gqkhao/pcb-schematics/01.png

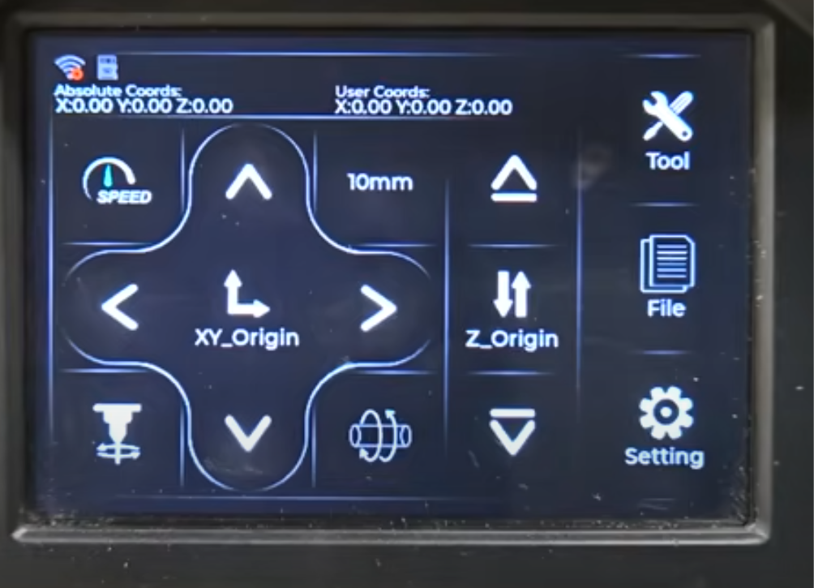
01.png
