gqkhao/pcb-schematics/CMB50N20测试正常MOS管.jpg

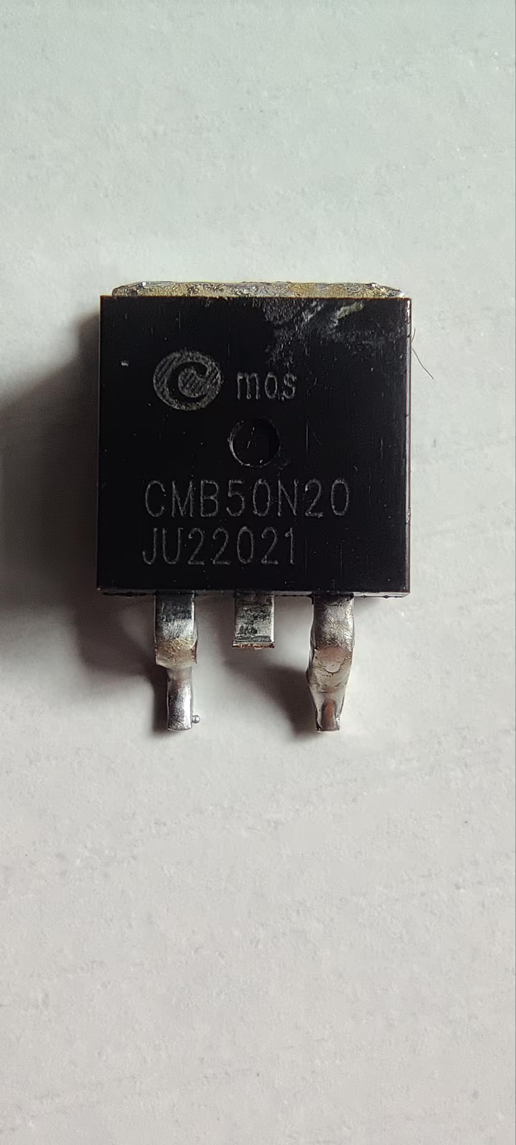
CMB50N20测试正常MOS管.jpg
