gqkhao/pcb-schematics/FluidNC/包裹款功能.docx

测试确定主板功能无误，主板功能如下

1.XYZ轴均为闭环步进电机；A轴：使用开环电机，用于升降探针；B和C轴：使用开环电机，旋转轴用；

2.控制板控制RGB状态灯（三色）；主轴照明灯不过控制板，总开关控制亮灭；光线不足通过灯带灯光补充，也是总开关控制亮灭；

3.限位端子三个对应XYZ轴，总共使用六个硬限位开关；

4.开盖保护功能启用了，则开盖后，主轴停，XYZ轴停，机器暂停；通过按键开关方式的一种控制开盖保护功能启用或者不启用（就是打开盖子后机器继续运动）

5.复位：机器上实体按键复位；

6.急停开关：拍下断电，出口欧洲需求专门认证的安全继电器模块（有现货）

7.对刀功能支持，电路板有接口；

8.购买的自动换刀模块有开合盖功能：开关信号触发实现，电路板有接口；

9.探针接口有，上位机控制自动调平、巡边；

10.控制板有接口,机器壳子要留DB9口；

11.USB接口有，WIFI功能有；

12.电源：一个交流转直流48V开关电源，一个DCDC直流小模块；

14.除尘，气泵控制，电路板有接口控制；

15.激光端口输出24V，需要使用24V激光器，电路板有接口；

16.控制板有SD卡接口，通过延长线接机器壳子上面的SD卡口，手轮屏幕不带SD卡口；

17.增加一路电平检测接口，用于检测刀具是否装夹到位
