gqkhao/pcb-schematics/4轴5.0/四轴5.0控制板升级说明.docx

四轴5.0控制板升级说明：

1、 激光和cnc切换引出一路IO口单独检测控制；
2、 12V电源输出端子修改为24V；
3、 对四个定位孔周围铺铜进行挖空；
4、 拨码开关SW2不焊接；
5、 功率MOS管板子上的Q2采用CMB50N20如下图

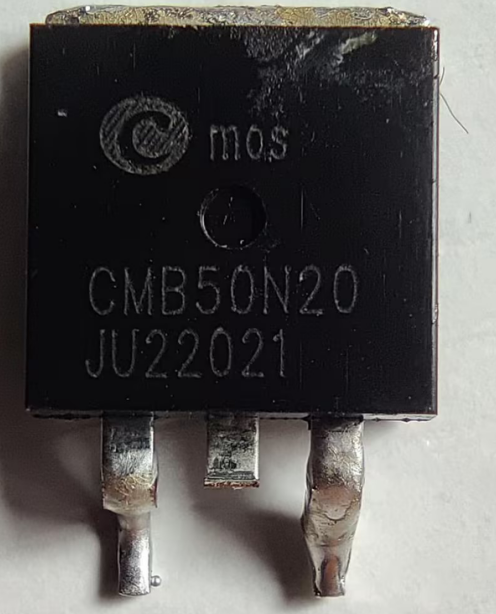
[picture p21: figure]
企业微信截图_17570547071518
