gqkhao/pcb-schematics/3020机器转接板/XZ转接板.pdf

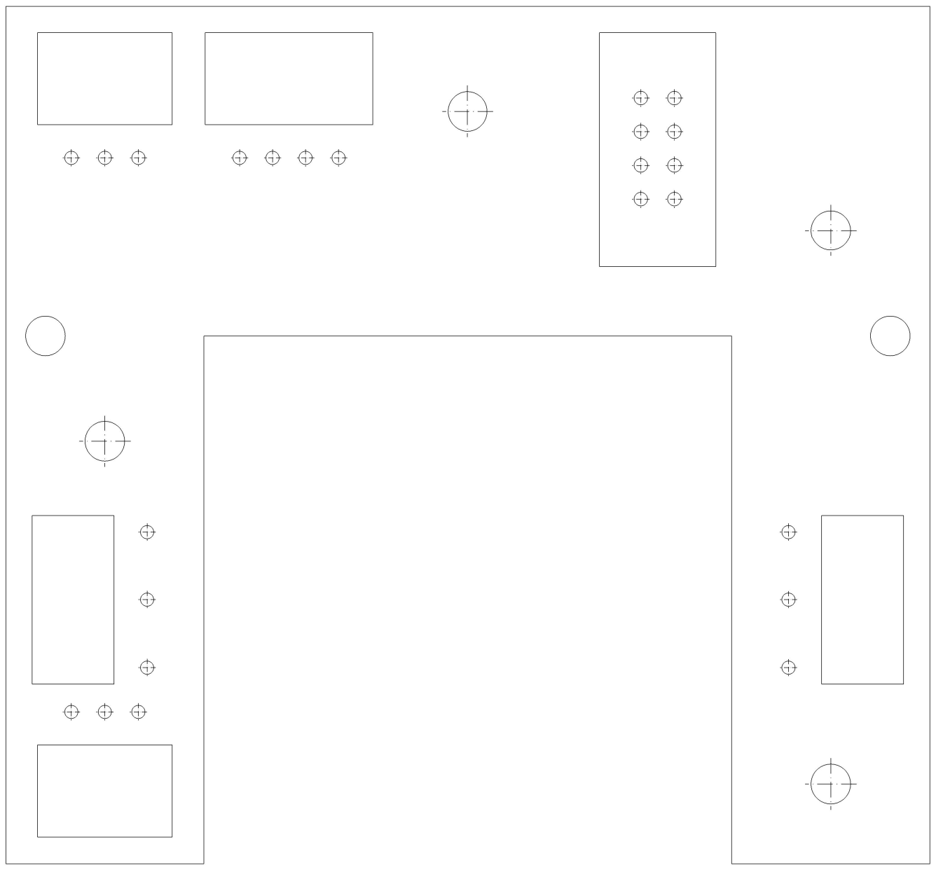
[picture p22: page 1]
