gqkhao/pcb-schematics/3020机器转接板/小限位开关板.png

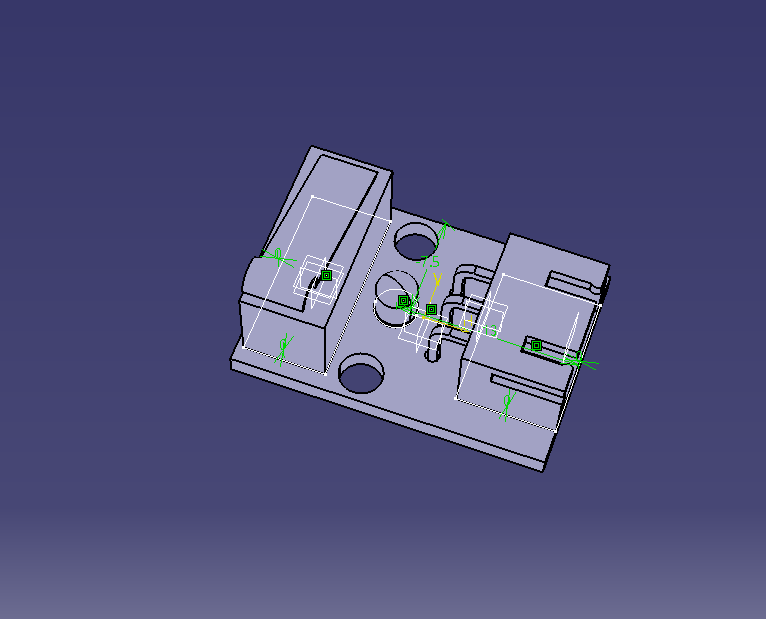
3020机器转接板/小限位开关板.png
