gqkhao/pcb-schematics/3020机器转接板/限位开关.png

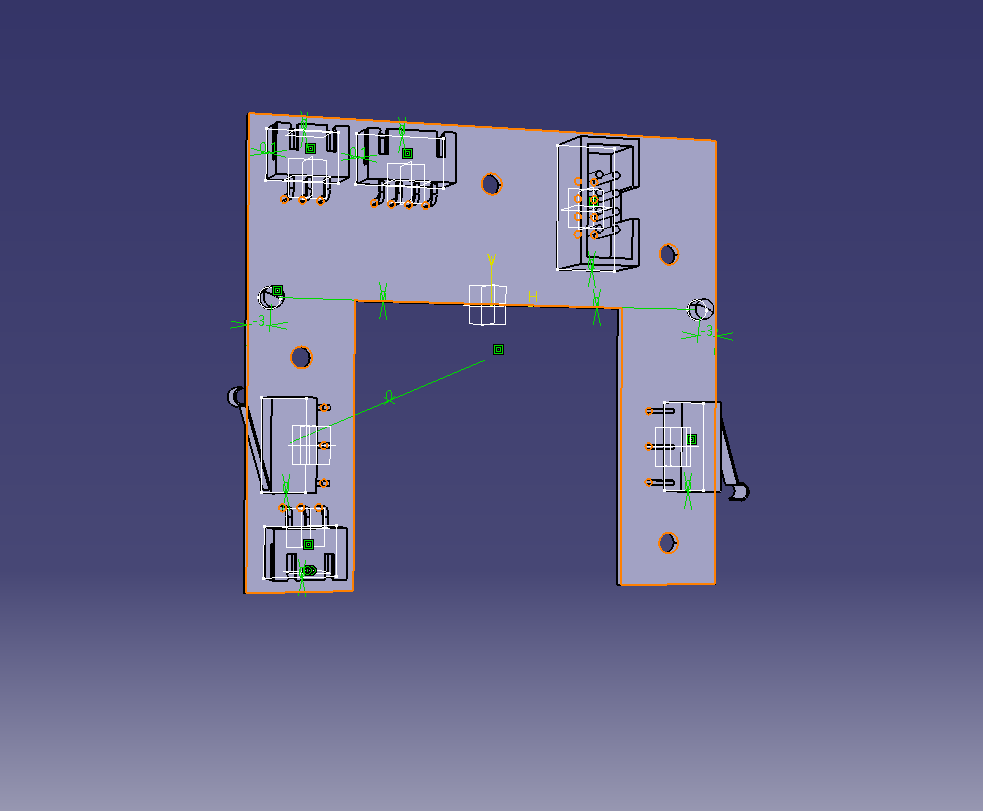
3020机器转接板/限位开关.png
