gqkhao/pcb-schematics/4040lite转接板/脉冲信号.png

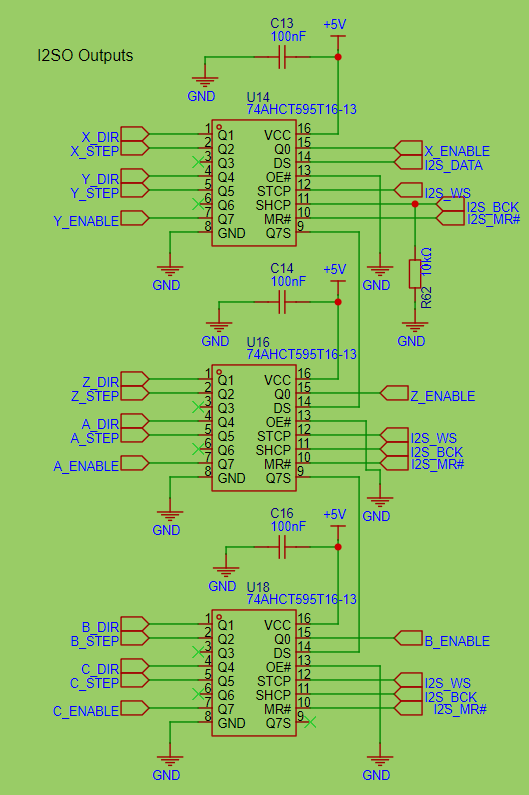
4040lite转接板/脉冲信号.png
