gqkhao/pcb-schematics/FluidNC/电源模块图片.png

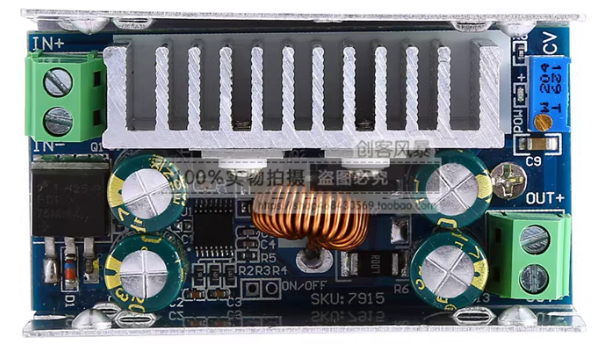
FluidNC/电源模块图片.png
