gqkhao/pcb-schematics/探针圆盘/对刀连接示意图/主板全部.png

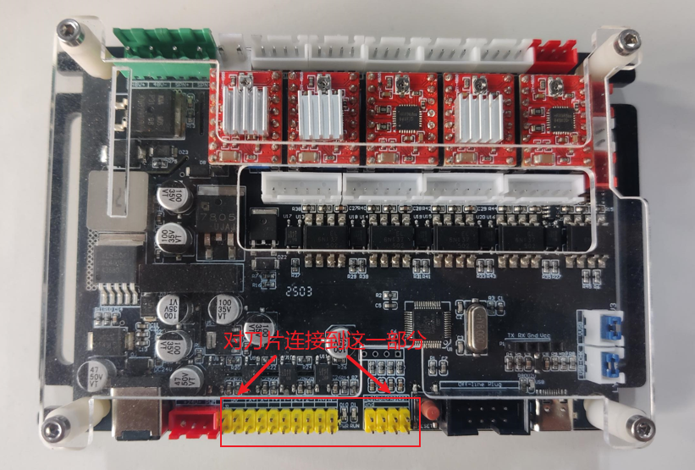
探针圆盘/对刀连接示意图/主板全部.png
