gqkhao/pcb-schematics/探针圆盘/对刀连接示意图/主板细节.png

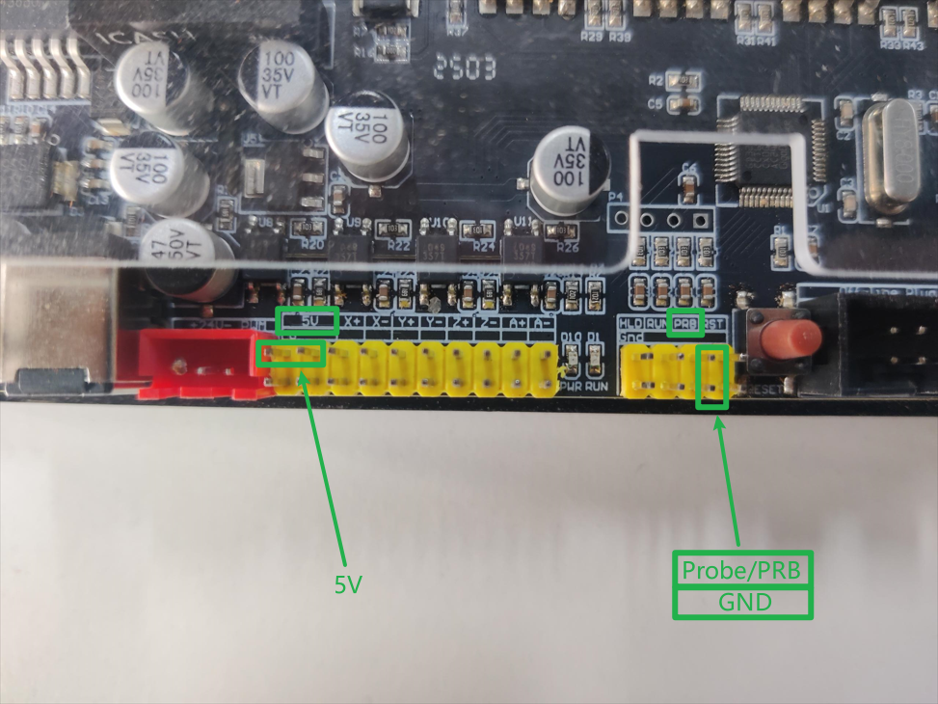
探针圆盘/对刀连接示意图/主板细节.png
