gqkhao/pcb-schematics/探针圆盘/对刀连接示意图/对刀片.jpg

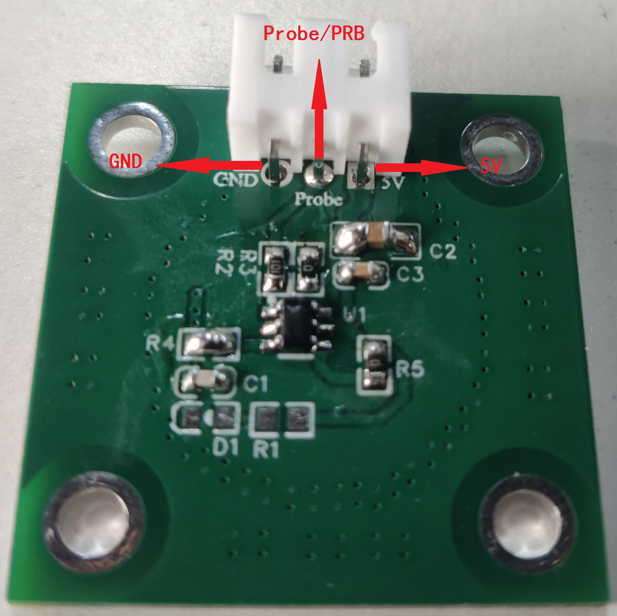
探针圆盘/对刀连接示意图/对刀片.jpg
