gqkhao/pcb-schematics/电机驱动TB6600/TB6600驱动板/tb6600板子资料/保证在110度条件下运行的 3.3V 5V驱动高速逻辑IC耦合器 TLP2309 - 电子发烧友网_files/15355635O-1.gif

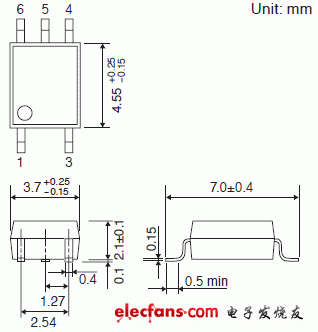
电机驱动TB6600/TB6600驱动板/tb6600板子资料/保证在110度条件下运行的 3.3V 5V驱动高速逻辑IC耦合器 TLP2309 - 电子发烧友网_files/15355635O-1.gif
