gqkhao/pcb-schematics/4040M/BOM_MCU+U盘__2026-06-23.xlsx

No. | 位号 | 数量 | 规格 | 封装 | 备注
1 | C1,C6,C10,C14,C34 | 5 | 100uF/10V | 电解电容贴片5.3X5.3
2 | C2,C3,C4,C7,C9,C12,C13,C17,C21,C22,C23,C24,C26,C28,C29,C33,C37,C40,C41,C42,C43,C44,C45,C46,C47,C48,C49,C25,C27,C39,C54,C55 | 32 | 0.1uF | C0603
3 | C5,C11,C15,C16,C50,C51,C52,C53 | 8 | 100uF/35V | 电解电容贴片6X6
4 | C30,C31,C32,C35,C36,C38 | 6 | 33pF | C0603
5 | CN1 | 1 | XHD2.54--3Pin | 弯针插件XHD2.54--3Pin
6 | D1,D9,D22 | 3 | SMAJ28A | SMA
7 | D2,D3,D6,D7,D8,D10,D11,D24 | 8 | SS56 | SMA
8 | D4,D12,D13,D16,D17,D20 | 6 | PESD5V0L1BA-N | SOD-323
9 | D5,D23 | 2 | SMAJ06A | SMA
10 | D14 | 1 | SMBJ15A | SMA
11 | D15 | 1 | 1N4148 | SOD-323
12 | D18,D19 | 2 | USBLC6-2SC6 | SOT-23-6
13 | L1,L2 | 2 | 贴片功率电感68uH | SMD_L7.0-W7.0
14 | LED1,LED2,LED3,LED5,D21 | 5 | 贴片LED绿光 | LED0603
15 | R1 | 1 | 47kΩ | R0603
16 | R4,R5,R8,R19,R22,R42,R43,R47,R48,R49,R57,R58,R61,R63 | 15 | 0Ω | R0603
17 | R10,R11,R23 | 3 | 22Ω | R0603
18 | R12,R16,R25,R32,R34 | 5 | 5.1K | R0603
19 | R13,R17,R26,R20,R27,R29,R36,R38,R33,R35,R40,R41,R45 | 13 | 220Ω | R0603
20 | R2,R3,R6,R7,R52,R53,R54,R56,R50,R76,R77,R78,R79,R21,R28,R30,R31,R37,R39,R24,R44,R46,R55,R59,R60,R62,R64,R65,R66,R67,R68,R69,R70,R71,R72,R73,R74,R75,R80,R81 | 40 | 10K | R0603
21 | U1 | 1 | 1117-3.3 | SOT-223
22 | U3,U5 | 2 | XL1509-5.0 | ESOP-8
23 | U9,U11,U14,U15,U16,U17,U18,U19,U21,U22,U26 | 11 | LTV-357T光耦 | SOP-4
24 | U23 | 1 | CH340G | SOIC-16
25 | U24 | 1 | CA-IS3760 | SOIC-16
26 | U27 | 1 | GD32F303CCT6 | LQFP48
27 | U29 | 1 | SP3232EEN | SOIC-16
28 | U30 | 1 | CH376T | SSOP-20_L7.5-W5.2-P0.65-LS8.0-BL
29 | USB1 | 1 | TYPE-C贴片座子 | USB-TYPE-C-SMD
30 | USB2 | 1 | U-USBAR04P-F002 | USB-A-TH_USB-302-T
31 | Y1,Y2 | 2 | 12M | 晶振贴片49SSMD
32 | Y3 | 1 | 8M | 晶振贴片
33
34 | U2,U4 | 2 | 插件隔离电源模块B0505LS-1WR3 | B0505LS-1WR3 | 插件物料
35 | DC1 | 1 | 插件DC007B-2.5 | 插件DC-IN-TH_HX-DC007B-2.5
36 | H3,H4,H5,H6,H7,H8,H9,H10 | 8 | 插件2.54单排母座8P | 插件2.54单排母座8P
37 | P1,P2,P3 | 3 | 插件XHD2.54--2Pin | 直针插件XHD2.54--2Pin
38 | P5,P6,P7,P9,P10,P11 | 6 | 插件XHD2.54--3Pin | 直针插件XHD2.54--3Pin
39 | P8,P14 | 2 | 插件5.08-2Pin | 弯针KF2EDG15R-5.08-2P
40 | P15 | 1 | 插件USB-B10-BRW | D型口USB母座
41 | P16,P17,P18,P19 | 4 | 插件XHD2.54--4Pin | 直针插件XHD2.54--4Pin
