gqkhao/pcb-schematics/3020-2.0包裹款/BOM_触摸屏控制板v1.0_2026-04-15.xlsx

序号 | 名称规格 | 数量 | 封装 | 位号
1 | 100uF/35V | 2 | 贴片电解电容6X6 | C1,C29
2 | 104/50v | 17 | 0603C | C2,C3,C15,C16,C17,C18,C19,C20,C21,C22,C23,C24,C25,C26,C27,C28,C30,C31
3 | 4.7uF/25V | 3 | C1206 | C4,C5,C14
4 | 100uF/10V | 2 | 贴片电解电容L5.3-W5.3 | C7,C8
5 | SS56 | 3 | SMA | D1,D2,D11
6 | LED绿或红灯 | 3 | 0603LED | D3,D5,D10
7 | USBLC6-2SC6 | 1 | SOT-23-6 | D7
8 | 1N4148 | 6 | SOD-323 | D8,D9,D12,D13,D14,D15
9 | FPC--6Pin(0.5mm)翻盖下接 | 1 | FPC--6Pin(0.5mm间距) | FPC1
10 | FPC--40Pin(0.5mm)抽屉上接 | 1 | FPC--40Pin(0.5mm间距) | FPC3
11 | 功率电感68uH | 2 | SMD_L7.0-W7.0 | L1,L6
12 | 2.54-4Pin立贴 | 2 | SMD_4P-2.54 | P9,P10
13 | SS8050 | 3 | SOT-23-3 | Q2,Q3,Q5
14 | 47K | 3 | 0603R | R1,R2,R32
15 | 10K | 20 | 0603R | R3,R5,R6,R7,R13,R14,R15,R16,R18,R19,R36,R20,R21,R22,R27,R28,R29,R30,R34,R35
16 | 1K | 1 | 0603R | R31
17 | XL1509-5.0 | 1 | SOP-8 | U1
18 | 1117-3.3 | 2 | SOT-223 | U2,U4
19 | ESPS3-32-WROOM-N8R8 | 1 | WIRELM-SMD_ESP32-S3 | U5
20 | CH340C(没有库存可以不焊接) | 1 | SOIC-16 | U6
21 | 自弹TF卡座TFAA | 1 | SIM-SMD | U8
22 | TYPE-C 16PIN | 1 | USB-C-SMD_TYPE-C | USB2
