gqkhao/pcb-schematics/转接隔离板/BOM_转接隔离板_-03-05.xlsx

No. | 数量 | Comment | Designator | Footprint
1 | 2 | 104 | C1,C3 | 0603C
2 | 1 | 100uF/35V | C2 | 电解电容贴片6x6
3 | 2 | 100uF/35V | C4,C5 | 电解电容贴片6X6
4 | 2 | 4.7uF | C6,C7 | C0805
5 | 1 | 104 | C8 | C1206
6 | 2 | 红光 | D1,D8 | 0603LED
7 | 3 | PESD24VL2BTN | D2,D4,D5 | SOT-23-3_L2.9-W1.6-P1.90-LS2.8-BR
8 | 1 | PESD24VL1BA | D3 | SOD-323_L1.7-W1.3-LS2.5-BI
9 | 1 | PESD5V0L1BA-N | D6 | SOD-323_L1.7-W1.3-LS2.5-BI
10 | 1 | 绿光 | D7 | 0603LED
11 | 1 | PESD3V3L1BA-N | D9 | SOD-323_L1.7-W1.3-LS2.5-BI
12 | 1 | 稳压管8.2V | DZ1 | SMA
13 | 2 | WJ2EDGVC-5.08-2P | P1,P6 | CONN-TH_WJ2EDGVC-5.08-2P
14 | 8 | 3P | P2,P3,P4,P5,P8,P9,P10,P11 | HDR1X3_CON
15 | 1 | 2P | P7 | HDR1X2_CON
16 | 1 | F50N06/FDB3632(FR9024N)/F540NS | Q1 | TO-263-2_L10.0-W9.1-P5.08-LS15.2-TL
17 | 3 | 100K | R1,R8 | 0603R
18 | 9 | 10K | R2,R3,R5,R6,R10,R11,R12,R13,R14,R15 | 0603R
19 | 1 | 5.1K | R4 | 0603R
20 | 1 | 47K | R7 | 0603R
21 | 1 | 100Ω | R9 | 0603R
22 | 5 | LTV-357T-C | U1,U2,U3,U5,U6 | SOP-4_L4.4-W3.9-P2.54-LS7.0-TL
23 | 1 | 1117-3.3 | U4 | SOT-223
