gqkhao/pcb-schematics/控制板10长宽/BOM_控制板_.xlsx

序号 | 数量 | Comment | Designator | Footprint | 备注
1 | 1 | HNR-1255PA5.0 | BUZ1 | BUZ-TH_BD12.5-P5.00-D0.9 | HNR-1255PA5.0
2 | 4 | 104 | C1,C11,C20,C50 | 0603C | 104
3 | 4 | 104 | C37,C39,C44,C52 | C0603
4 | 15 | 104 | C4,C5,C6,C9,C10,C13,C14,C15,C16,C17,C18,C23,C32,C35,C46 | 0603C
5 | 2 | 22pF | C2,C3 | 0603C | 22pF
6 | 6 | 100uF/35V | C12,C24,C25,C27,C33,C47 | 电解电容贴片6X6 | 100uF/35V
7 | 3 | 100uF/63V | C19,C21,C22 | 电解电容贴片10x10 | 100uF/63V
8 | 1 | 104 | C26 | 0805C | 104
9 | 3 | 105 | C28,C29,C31 | 0805C | 105
10 | 4 | 100uF/35V | C30,C38,C42,C51 | 电解电容贴片6x6 | 100uF/35V
11 | 6 | 4.7uF | C34,C36,C40,C43,C48,C49 | C0805 | 4.7uF
12 | 2 | 105 | C41,C45 | C0603 | 105
13 | 11 | ESD05V52D-C | D1,D2,D3,D4,D8,D9,D10,D11,D12,D13,D14 |  | ESD05V52D-C
14 | 8 | SS56二极管 | D5,D6,D17,D18,D20,D22,D25,D27 | SMA | 拆其它
15 | 3 | 贴片LED | D7,D19,D26 | 0603LED
16 | 3 |  | D15,D21,D24 | 0603LED
17 | 1 |  | D23 | 0603LED
18 | 3 | SMAZ10V | DZ1,DZ2,DZ4 | SMA
19 | 1 | RS5M | DZ3 | SMC
20 | 5 | 2.54排针 | H1,H2,H3,H4,H5 | HDR-TH_2P-P2.54-V-M | 2.54排针
21 | 1 | SW_6X6_H=12.0MM | K1 | KEY-SMD_4P-L6.0-W6.0-P4.50-LS9.0 | 拆其它
22 | 1 | 47uH/470 | L1 | IND-SMD_L13.45-W12.6 | 47uH/470
23 | 1 | 47uH/470 | L2 | IND-SMD_L13.45-W12.6 | 47uH/470
24 | 1 | 33uH/330 | L3 | IND-SMD_L7.0-W7.0_SMDRI74-330MT | 33uH/330
25 | 14 | 2.54排针 | P1,P2,P3,P4,P5,P6,P7,P8,P9,P10,P11,P12,P22,P25 | HDR1X2_CON | 2P
26 | 3 |  | P13,P14,P15 | HDR-TH_3P-P2.54-V-M | PZ254V-11-03P
27 | 1 |  | P16 | IDC8 | 8P
28 | 6 |  | P17,P26,P27,P31,P32,P33 | HDR1X3_CON | 3P
29 | 4 |  | P18,P19,P20,P21 | HDR1X4_CON | 4P
30 | 1 |  | P23 | SIP4
31 | 4 | DB2ER-5.0-2P-GN | P24,P28,P29,P30 | CONN-TH_2P-P5.00_DB2ER-5.0-2P-GN | DB2ER-5.0-2P-GN
32 | 7 | SS8050 | Q1,Q3,Q4,Q5,Q8,Q11,Q13 | SOT-23 | SS8050
33 | 1 | AO3401 | Q2 | SOT-23-3_L3.0-W1.7-P0.95-LS2.9-BR | AO3401
34 | 2 | F50N06 (FR9024N) | Q6,Q9 | TO-252 | F50N06 (FR9024N)
35 | 1 | IRFB4110PBF | Q7 | TO-220-3_L10.0-W4.5-P2.54-L | IRFB4110PBF
36 | 2 | AO3401 | Q10,Q12 | SOT-23 | AO3401
37 | 14 | 1K | R1,R2,R3,R4,R13,R14,R15,R17,R22,R23,R24,R25,R77,R81 | 0603R
38 | 13 | 10K | R5,R6,R7,R8,R19,R20,R21,R29,R31,R34,R35,R36,R39 | 0603R
39 | 15 |  | R9,R12,R16,R40,R43,R48,R51,R53,R57,R67,R73,R75,R76,R79,R80 | 0603R
40 | 2 |  | R45,R46 | R0603
41 | 3 |  | R32,R33,R44 | 0603R
42 | 6 | 1K | R11,R42,R55,R69,R74,R78 | 0603R
43 | 5 | 100K | R18,R52,R54,R56,R58 | 0603R
44 | 7 |  | R68,R71,R47,R41,R59,R70,R82 | 0603R
45 | 4 | 510Ω | R27,R28,R37,R38 | 0603R
46 | 2 | 100Ω | R49,R50,R63 | 0603R
47 | 2 | 0Ω | R60,R72 | 0603R
48 | 1 | 44.2K | R61 | 0603R | 拆其它
49 | 1 | 2.37K | R62 | 0603R
50 | 2 | 0Ω | R65,R66,R64 | R0603
51 | 11 | LTV-357T-C | U1,U2,U3,U4,U5,U6,U7,U8,U10,U11,U12 | SOP-4_L4.4-W3.9-P2.54-LS7.0-TL | 拆其它
52 | 1 | USBLC6-2SC6 | U9 | SOT-23-6_L2.9-W1.6-P0.95-LS2.8-BL | USBLC6-2SC6
53 | 1 | CH340C | U13 | SOIC-16_L9.9-W3.9-P1.27-LS6.0-BL | CH340C
54 | 1 | STM32F103RCT6 | U14 | LQFP-64_L10.0-W10.0-P0.50-LS12.0-BL | STM32F103RCT6
55 | 3 | CA-IS3760 | U15,U16,U17 | SOIC-16_L9.9-W3.9-P1.27-LS6.0-BL | CA-IS3760
56 | 1 | CD4066B | U18 | SOP-14_L8.6-W3.9-P1.27-LS6.0-BL | CD4066B
57 | 1 | CA-IS3720LS | U19 | SOIC-8_L4.9-W3.9-P1.27-LS6.0-BL | 拆其它
58 | 1 | 74LVC1G04 | U20 | SOT-23-5 | 74LVC1G04
59 | 1 | LM2576HVS-ADJ | U21 | TO-263 | 拆其它
60 | 1 | LM2596S-12 | U22 | TO-263-5_L10.2-W8.6-P1.70-LS14.4-BR | LM2596S-12
61 | 2 | B0505LS-1WR3 | U23,U24 | PWRM-TH_BXXXXLS-1WR3 | B0505LS-1WR3
62 | 1 | 1117-3.3 | U25 | SOT-223 | 1117-3.3
63 | 1 | LM2596S-5.0RG | U26 | TO-263-5_L10.1-W8.7-P1.70-LS15.2-BR | LM2596S-5.0RG
64 | 1 | USB-B10-BRW | USB_TTL1 | USB-B-TH_USB-B10-BRW | USB-B10-BRW
65 | 1 | 8M | Y1 | 晶振贴片 | 8M
