gqkhao/pcb-schematics/控制板10长宽/BOM_控制板_-02-17.xlsx

No. | Quantity | Comment | Designator | Footprint | Name
1 | 1 | HNR-1255PA5.0 | BUZ1 | BUZ-TH_BD12.5-P5.00-D0.9 | HNR-1255PA5.0
2 | 18 | 104 | C1,C4,C5,C6,C9,C10,C13,C14,C15,C16,C17,C18,C20,C23,C32,C35,C46,C50 | 0603C | 104
3 | 2 | 22pF | C2,C3 | 0603C | 22pF
4 | 2 | 33pF | C7,C8 | 0603C | 33pF
5 | 2 | 104 | C11,C26 | 0805C | 104
6 | 6 | 100uF/35V | C12,C24,C25,C27,C33,C47 | 电解电容贴片6X6 | 100uF/35V
7 | 3 | 100uF/63V | C19,C21,C22 | 电解电容贴片10x10 | 100uF/63V
8 | 3 | 105 | C28,C29,C31 | 0805C | 105
9 | 4 | 100uF/35V | C30,C38,C42,C51 | 电解电容贴片6x6 | 100uF/35V
10 | 6 | 4.7uF | C34,C36,C40,C43,C48,C49 | C0805 | 4.7uF
11 | 4 | 104 | C37,C39,C44,C52 | C0603 | 104
12 | 2 | 105 | C41,C45 | C0603 | 105
13 | 11 | ESD05V52D-C | D1,D2,D3,D4,D8,D9,D10,D11,D12,D13,D14 | SOD-523_L1.2-W0.8-LS1.6-BI | ESD05V52D-C
14 | 8 | SS56 | D5,D6,D17,D18,D20,D22,D25,D27 | SMA | SS56
15 | 3 | 红光 | D7,D19,D26 | 0603LED | 红光
16 | 3 | 绿光 | D15,D21,D24 | 0603LED | 绿光
17 | 1 | 1N4148 | D16 | SMA | 1N4148
18 | 1 | -̹- | D23 | 0603LED | -̹-
19 | 3 | --ѹ------SMAZ10V | DZ1,DZ2,DZ4 | SMA | --ѹ------SMAZ10V
20 | 1 | RS5M | DZ3 | SMC | RS5M
21 | 5 | PZ254V-11-02P | H1,H2,H3,H4,H5 | HDR-TH_2P-P2.54-V-M | PZ254V-11-02P
22 | 1 | SW_6X6_H=12.0MM | K1 | KEY-SMD_4P-L6.0-W6.0-P4.50-LS9.0 | SW_6X6_H=12.0MM
23 | 1 | 47uH/5A | L1 | IND-SMD_L13.45-W12.6 | 47uH/5A
24 | 1 | 33uH | L2 | IND-SMD_L13.45-W12.6 | 33uH
25 | 1 | 33uH | L3 | IND-SMD_L7.0-W7.0_SMDRI74-330MT | 33uH
26 | 14 | 2P | P1,P2,P3,P4,P5,P6,P7,P8,P9,P10,P11,P12,P22,P25 | HDR1X2_CON | 2P
27 | 3 | PZ254V-11-03P | P13,P14,P15 | HDR-TH_3P-P2.54-V-M | PZ254V-11-03P
28 | 1 | 8P | P16 | IDC8 | 8P
29 | 6 | 3P | P17,P26,P27,P31,P32,P33 | HDR1X3_CON | 3P
30 | 4 | 4P | P18,P19,P20,P21 | HDR1X4_CON | 4P
31 | 1 | 4P | P23 | SIP4
32 | 4 | DB2ER-5.0-2P-GN | P24,P28,P29,P30 | CONN-TH_2P-P5.00_DB2ER-5.0-2P-GN | DB2ER-5.0-2P-GN
33 | 7 | SS8050 | Q1,Q3,Q4,Q5,Q8,Q11,Q13 | SOT-23 | SS8050
34 | 1 | AO3401 | Q2 | SOT-23-3_L3.0-W1.7-P0.95-LS2.9-BR | AO3401
35 | 2 | F50N06 (FR9024N) | Q6,Q9 | TO-252 | F50N06 (FR9024N)
36 | 1 | IRFB4110PBF/不贴 | Q7 | TO-220-3_L10.0-W4.5-P2.54-L | IRFB4110PBF/不贴
37 | 2 | AO3401 | Q10,Q12 | SOT-23 | AO3401
38 | 14 | 1K | R1,R2,R3,R4,R13,R14,R15,R17,R22,R23,R24,R25,R77,R81 | 0603R | 1K
39 | 28 | 10K | R5,R6,R7,R8,R9,R12,R16,R19,R20,R21,R29,R31,R34,R35,R36,R39,R40,R43,R48,R51,R53,R57,R67,R73,R75,R76,R79,R80 | 0603R | 10K
40 | 2 | 5.1K | R10,R44 | 0603R | 5.1K
41 | 6 | 2K | R11,R42,R55,R69,R74,R78 | 0603R | 2K
42 | 5 | 20K | R18,R52,R54,R56,R58 | 0603R | 20K
43 | 2 | 1M | R26,R30 | R0603 | 1M
44 | 4 | 510Ω | R27,R28,R37,R38 | 0603R | 510Ω
45 | 2 | 10k | R32,R33 | 0603R | 10k
46 | 4 | 50K | R41,R59,R70,R82 | 0603R | 50K
47 | 2 | 10K | R45,R46 | R0603 | 10K
48 | 2 | 200K | R47,R68 | 0603R | 200K
49 | 2 | 100 | R49,R50 | 0603R | 100
50 | 2 | 0Ω | R60,R72 | 0603R | 0Ω
51 | 1 | 44.2K | R61 | 0603R | 44.2K
52 | 1 | 2.37K | R62 | 0603R | 2.37K
53 | 1 | 100Ω | R63 | R0603 | 100Ω
54 | 1 | 0Ω/NC | R64 | R1210 | 0Ω/NC
55 | 2 | 0Ω | R65,R66 | R1210 | 0Ω
56 | 1 | 100K | R71 | 0603R | 100K
57 | 11 | LTV-357T-C | U1,U2,U3,U4,U5,U6,U7,U8,U10,U11,U12 | SOP-4_L4.4-W3.9-P2.54-LS7.0-TL | LTV-357T-C
58 | 1 | MSUSBLC6-2SC6 | U9 | SOT-23-6_L2.9-W1.6-P0.95-LS2.8-BL | MSUSBLC6-2SC6
59 | 1 | CH340G | U13 | SOIC-16_L9.9-W3.9-P1.27-LS6.0-BL | CH340G
60 | 1 | STM32F103RBT6/RCT6 | U14 | LQFP-64_L10.0-W10.0-P0.50-LS12.0-BL | STM32F103RBT6/RCT6
61 | 3 | CA-IS3760 | U15,U16,U17 | SOIC-16_L9.9-W3.9-P1.27-LS6.0-BL | CA-IS3760
62 | 1 | CD4066B | U18 | SOP-14_L8.6-W3.9-P1.27-LS6.0-BL | CD4066B
63 | 1 | CA-IS3720LS | U19 | SOIC-8_L4.9-W3.9-P1.27-LS6.0-BL | CA-IS3720LS
64 | 1 | 74LVC1G04 | U20 | SOT-23-5 | 74LVC1G04
65 | 1 | LM2576HVS-ADJ | U21 | TO-263 | LM2576HVS-ADJ
66 | 1 | LM2596S-12 | U22 | TO-263-5_L10.2-W8.6-P1.70-LS14.4-BR | LM2596S-12
67 | 2 | B0505LS-1WR3 | U23,U24 | PWRM-TH_BXXXXLS-1WR3 | B0505LS-1WR3
68 | 1 | 1117-3.3 | U25 | SOT-223 | 1117-3.3
69 | 1 | LM2596S-5.0RG | U26 | TO-263-5_L10.1-W8.7-P1.70-LS15.2-BR | LM2596S-5.0RG
70 | 1 | USB-B10-BRW | USB_TTL1 | USB-B-TH_USB-B10-BRW | USB-B10-BRW
71 | 1 | 8M | Y1 | 晶振贴片 | 8M
72 | 1 | 12M | Y2 | 晶振贴片49SSMD | 12M
