gqkhao/pcb-schematics/安全继电器TXAS1-3012/BOM_延时继电器.xlsx

序号 | 数量 | Comment | 位号 | 封装
1 | 8 | 1K | R8,R10,R18,R20,R23, R25,R30,R33 | 0603R
2 | 1 | 4P | P9 | SIP4
3 | 4 | 4.7uF | C1,C2,C8,C16 | C1206
4 | 8 | 5.08-2P | P1,P2,P3,P4,P5,P6,P7,P8 | CONN-TH_2P-P5.08_ DB128L-5.08-2P
5 | 2 | 5.1K | R31,R34 | 0603R
6 | 1 | 8M | Y1 | 晶振贴片SMD
7 | 3 | 10k | R14,R15,R17 | 0603R
8 | 20 | 10K | R2,R3,R4,R5,R6, R9,R11,R12,R13,R16 R19,R21,R22,R24, R26,R28,R29,R32,R35 | 0603R
9 | 2 | 22pF | C10,C11 | 0603C
10 | 1 | 47K | R27 | 0603R
12 | 1 | 100uF/35V | C4 | 电解电容贴片6X6
13 | 1 | 100uF/50V | C6 | CAP-SMD_BD10.0-L10.3-W 10.3-LS11.0-R-RD
14 | 7 | 104 | C5,C7,C9,C12,C13,C14,C15 | 0603C
15 | 1 | 104 | C3 | C0603
16 | 1 | 1117-3.3 | U3 | SOT-223
17 | 1 | B0505LS-1WR3 | U1 | PWRM-TH_BXXXXLS-1WR3
18 | 1 | CJ7805 | U2 | TO-263-2
19 | 3 | JQC-3FF/24VDC-1HS(551) | K1,K2,K3 | RELAY-TH_JQC-3FF-1HXX
20 | 8 | LTV-357T-C | U4,U5,U7,U8,U9, U10,U11,U12 | SOP-4_L4.4-W3.9- P2.54-LS7.0-TL
21 | 1 | mSMD030 | F1 | F1812
22 | 1 | PESD3V3L1BA-N | D44 | SOD-523_L1.2-W0.8-LS1.6-BI
23 | 1 | PESD5V0L1BA-N | D2 | SOD-523_L1.2-W0.8-LS1.6-BI
24 | 3 | PESD24VL2BTN | D38,D41,D42 | SOT-23-3_L2.9-W1.6-P 1.90-LS2.8-BR
25 | 4 | SS56 | D1,D5,D10,D12 | SMA
26 | 3 | SS8050 | Q1,Q2,Q3 | SOT-23-3_L2.9-W1.3-P 1.90-LS2.4-BR
27 | 1 | STM32F103C8T6/CBT6 | U6 | LQFP48
29 | 7 | 绿光LED | D6,D11,D13, D39,D40,D43 | 0603
