gqkhao/pcb-schematics/FluidNC/BOM_RS232--_2025-11-11.xlsx

No. | 数量 | Comment | Designator | Footprint
1 | 1 | 100uF/35V | C6 | 电解电容贴片6X6
2 | 1 | 10uF | C9 | C1206
3 | 5 | 104 | C27,C28,C29,C30,C31 | 0603C
4 | 1 | 100uF/10V | C40 | CAP-SMD_BD5.0-L5.3-W5.3-RD
5 | 1 | SS56 | D3 | SMA
6 | 1 | XDDB-1809-0816 | DB1 | DB9-TH_LD09P33E4GV00LF
7 | 1 | PZ254V-11-04P | H1 | HDR-TH_4P-P2.54-V-M
8 | 2 | 510Ω | R40,R41 | 0603R
9 | 1 | SP3232EEN-L/TR | U12 | SP3232EEN-L/TR
10 | 1 | CJ7805 | U18 | CJ7805
