gqkhao/pcb-schematics/FluidNC/BOM_4040-3.0--01-08.xlsx

No. | 数量 | Comment | Designator | Footprint
1 | 7 | 103 | C1,C2,C3,C6,C12,C17,C18 | 11
2 | 2 | 100uF/35V | C4,C13 | 电解电容贴片6X6
3 | 11 | 104 | C5,C8,C11,C14,C16,C19,C21,C22,C23,C24,C25 | 0603C
4 | 2 | 10uF | C7,C27 | C1206
5 | 1 | 100uF/10V | C9 | CAP-SMD
6 | 2 | 4.7uF | C10,C20 | C1206
7 | 1 | 100uF/35V | C15 | 电解电容贴片6X6
8 | 2 | 33pF | C26,C29 | 0603C
9 | 1 | 104 | C28 | 11
10 | 1 | SS56 | D1 | SMA
11 | 1 | SS34 | D2 | SMA
12 | 3 | 绿光 | D3,D5,D7 | 0603LED
13 | 1 | PESD5V0L1BA-N | D4 | SOD-323
14 | 1 | PESD3V3L1BA-N | D6 | SOD-323
15 | 2 | 1N4148 | D8,D9 | SOD-123
16 | 2 | PZ254V-11-08P | H1,H2 | HDR-TH_8P-P2.54-V-M
17 | 3 | PZ254V-11-02P | H3,H4,H5 | HDR-TH_2P-P2.54-V-M
18 | 1 | SW_6X6_H=12.0MM | K1 | KEY-SMD_4P
19 | 1 | TS-1088-AR02016 | K2 | SW-SMD_
20 | 1 | 68uH | L1 | IND-SMD_
21 | 1 | KF2EDGVC-5.08-2P | P1 | CONN-TH_P5.08
22 | 5 | 3P | P2,P6,P13,P16,P17 | HDR1X3_CON
23 | 8 | 4P | P3,P4,P5,P7,P8,P11,P12,P19 | HDR1X4_CON
24 | 4 | 2P | P9,P10,P14,P15 | HDR1X2_CON
25 | 1 | USB-B12-BRW | P18 | USB-B-TH_USB-B12-BRW
26 | 3 | SS8050 | Q1,Q2,Q3 | SOT-23-3
27 | 27 | 10K | R1,R2,R3,R4,R9,R10,R14,R16,R19,R20,R27,R28,R29,R30,R31,R32,R33,R34,R39,R41,R45,R24,R8,R40,R42,R43,R44 | 0603R
29 | 2 | 100Ω | R6,R13 | 10
30 | 4 | 47K | R7,R5,R11,R21 | 0603R
32 | 2 | RT0603BRD0710KL | R12,R15 | R0603
33 | 4 | 1.8K | R17,R18,R22,R23 | 0603R
36 | 2 | 100 | R25,R26 | 0603R
37 | 1 | 1K | R35 | 0603R
38 | 1 | 0Ω | R36 | 0603R
39 | 2 | 470Ω | R37,R38 | 0603R
40 | 1 | SN74AHC1G08 | U1 | SC-70-5_L2.1
41 | 1 | XL1509-5.0E1 | U2 | ESOP-8
42 | 5 | 74LVC1G17 | U3,U5,U9,U10,U11 | SOT-23-5
43 | 1 | 1117-3.3 | U4 | SOT-223
44 | 2 | 74AHCT595T16-13 | U6,U7 | TSSOP-16
45 | 1 | ESP32-WROOM-32 | U8 | WIFI-SMD
46 | 1 | CH340G | U12 | SOIC-16
47 | 1 | 自弹TF卡座TFAA | U13 | SIM-SMD
48 | 1 | USBLC2-2SC6 | U14 | SOT-23-6
49 | 1 | 12M | Y1 | 晶振贴片49SSMD
