gqkhao/pcb-schematics/FluidNC/BOM_12-23_2025-12-23.xlsx

No. | 数量 | Comment | Designator | Footprint
1 | 7 | 103 | C1,C4,C11,C14,C20,C21,C31 | 11
2 | 4 | 100uF/35V | C2,C7,C13,C19 | 电解电容贴片6X6
3 | 17 | 104 | C3,C10,C12,C16,C17,C18,C23,C25,C26,C27,C28,C29,C30,C32,C33,C35,C39 | 0603C
4 | 1 | 10uF | C5 | C1206
5 | 2 | 100uF/10V | C6,C34 | CAP-SMD_BD5.0-L5.3-W5.3-RD
6 | 2 | 4.7uF | C8,C9 | C1206
7 | 1 | 100uF/35V(47uF/50V) | C24 | 电解电容贴片6X6
8 | 2 | 33pF | C36,C37 | 0603C
9 | 1 | 104 | C38 | 11
10 | 2 | SS56 | D1,D2 | SMA
11 | 1 | SS34 | D3 | SMA
12 | 3 | 绿光 | D4,D6,D7 | 0603LED
13 | 5 | PESD5V0L1BA-N | D5,D8,D11,D13,D21 | SOD-323_L1.8-W1.3-LS2.5-BI
14 | 1 | PESD3V3L1BA-N | D9 | SOD-323_L1.8-W1.3-LS2.5-BI
15 | 7 | 1N4148 | D14,D15,D16,D17,D18,D19,D20 | SOD-123_L2.8-W1.8-LS3.7-RD
16 | 1 | XDDB-1809-0816 | DB1 | DB9-TH_LD09P33E4GV00LF
17 | 6 | PZ254V-11-08P | H1,H2,H5,H6,H9,H10 | HDR-TH_8P-P2.54-V-M
18 | 2 | PZ254V-11-03P | H7,H14 | HDR-TH_3P-P2.54-V-M
19 | 1 | PZ254V-11-02P | H8 | HDR-TH_2P-P2.54-V-M
20 | 2 | PZ254 | H11,H12 | HDR-TH_2P-P2.54-V-M
21 | 1 | PZ254V-11-04P | H13 | HDR-TH_4P-P2.54-V-M
22 | 1 | JQC-3FF/24VDC-1HS(551) | K1 | RELAY-TH_JQC-3FF-1HXX
23 | 1 | SW_6X6_H=12.0MM | K2 | KEY-SMD_4P-L6.0-W6.0-P4.50-LS9.0
24 | 1 | TS-1088-AR02016 | K3 | SW-SMD_L3.9-W3.0-P4.45
25 | 1 | 68uH | L1 | IND-SMD_L7.0-W7.0_SMDRI74-330MT
26 | 2 | KF2EDGVC-5.08-2P | P1,P2 | CONN-TH_P5.08_KF2EDGVC-5.08-2P
27 | 11 | 3P | P3,P4,P5,P6,P8,P9,P17,P20,P21,P22,P24 | HDR1X3_CON
28 | 7 | 4P | P7,P11,P14,P15,P16,P18,P19 | HDR1X4_CON
29 | 2 | 2P | P10,P12 | HDR1X2_CON
30 | 1 | USB-B12-BRW | P23 | USB-B-TH_USB-B12-BRW
31 | 4 | SS8050 | Q1,Q2,Q3,Q4 | SOT-23-3_L2.9-W1.3-P1.90-LS2.4-BR
32 | 27 | 10K | R1,R2,R3,R6,R11,R12,R16,R17,R18,R22,R23,R24,R26,R33,R34,R35,R38,R39,R40,R41,R44,R45,R46,R49,R54,R60,R61 | 0603R
33 | 3 | 22K | R4,R9,R13 | 10
34 | 3 | 1K | R5,R36,R47 | 0603R
35 | 3 | 100 | R7,R10,R14 | 10
36 | 4 | 47K | R8,R37,R57,R59 | 0603R
37 | 4 | 22K | R15,R27,R42,R58 | 0603R
38 | 5 | 100 | R20,R21,R29,R30,R43 | 0603R
39 | 1 | 10kΩ | R25 | R0603
40 | 3 | 0Ω | R32,R48,R83/NC | 0603R
41 | 4 | 10K | R50,R51,R53,R56 | 10
42 | 2 | 100Ω | R52,R55 | 0603R
43 | 3 | LTV-357T-C | U1,U10,U18 | SOP-4_L4.4-W3.9-P2.54-LS7.0-TL
44 | 1 | XL1509-5.0E | U2 | ESOP-8_L4.9-W3.9-P1.27-LS6.0-BL-EP
45 | 1 | CJ7812 | U3 | TO-263-2_L10.1-W9.1-P5.08-LS15.2-TL
46 | 1 | 1117-3.3 | U4 | SOT-223
47 | 5 | 74LVC1G17 | U5,U7,U12,U14,U19 | SOT-23-5
48 | 2 | 74AHCT595T16-13 | U6,U8 | TSSOP-16_L5.0-W4.4-P0.65-LS6.4-BL
49 | 1 | ESP32-WROOM-32 | U9 | WIFI-SMD_ESP32-WROOM-32UE-A
50 | 1 | SP3232EEN-L/TR | U11 | SOIC-16_L9.9-W3.9-P1.27-LS6.0-BL
51 | 1 | 74LVC1G04 | U13 | SOT-23-5
52 | 1 | CH340G | U15 | SOIC-16_L9.9-W3.9-P1.27-LS6.0-BL
53 | 1 | 自弹TF卡座TFAA | U16 | SIM-SMD_C9900015645
54 | 1 | USBLC2-2SC6 | U17 | SOT-23-6
