gqkhao/pcb-schematics/4轴5.0/LY-4X5.0-V3.1--BOM(20260119)新.xlsx

型号：LY-5X-V3.1
序号 | 元件 | 位号 | 封装 | 用量
1 | 100nf(104)/50V | C1,C15,C16,C17,C19,C12,C14,C24,C25,C26,C62,C29,C30,C31,C32,C77,C78 | C0603 | 17
2 | 1UF(105)/50v | C4,C6 | 0805C | 2
3 | 100uF/35V | C5,C8,C11,C13,C28，C79 | 电解贴片6x6.7 | 6
4 | 1UF(105)/50v | C7,C9 | C0603 | 2
5 | 10nf(103)/50V | C18,C64,C65,C66,C67,C68,C69 | C0603 | 7
6 | 33pF/50V | C20,C21 | C0603 | 2
7 | 22pF/50V | C22,C23 | C0603 | 2
10 | 10uF/10V | C72,C74,C76 | C0805 | 3
11 | 红灯 | D1,D5,D6 | LED0603 | 3
12 | SS56 | D2,D3, | SMA | 2
14 | SMBJ36A | D11 | SMB | 1
17 | 6*6*9轻触 | K1 | 四脚轻触 | 1
18 | 33uH 1265电感 | L1 | 1265 | 1
19 | 33uH 0630电感 | L3 | 0630 | 1
22 | SS8050 | Q5 | SOT-23 | 1
23 | SI2301 | Q4 | SOT-23-3 | 1
24 | si2302 | Q6 | SOT-23-3 | 1
25 | 1K | R1,R12,R21,R99,R101 | 0603R | 5
26 | 470R 1% | R9,R19,R27 | 0603R | 3
27 | 10K 1% | R2,R8,R11,R10,R13,R16,R20,R28,R86,R88,R90,R92,R94,R96,R100,R102,R103,R107 | 0603R | 18
28 | 100 1% | R14,R15,R34,R39,R40,R85,R87,R89,R91,R93,R95,R97 | 0603R | 12
29 | 1M 1% | R22,R23 | R0603 | 2
35 | LM2596S-12 | U1 | TO-263-5 | 1
36 | LM2596S-5.0RG | U2 | TO-263-5 | 1
37 | 1117-3.3 | U3 | SOT-223 | 1
38 | GD32F303CCT6 | U6 | LQFP48 | 1
39 | LTV-357T-C | U7,U9,U10,U12 | SOP-4 | 4
40 | CH340G | U8 | SOP16 | 1
41 | 74LVC1G17 | U13 | SOT-23-5 | 1
43 | CA-IS3720LS | U16,U17,U19,U20,U30 | SOIC-8 | 5
45 | USBLC6-2SC6（UL26） | U29 | SOT-23-6 | 1
46 | 12M | Y1 | 49SSMD | 1
47 | 8M | Y2 | 49HC-SMD | 1
以下为插件料
48 | B0505LS-1WR3 | U4 | 4 DIP | 1
49 | VH3.96-3P | SW1 | VH3.96 | 1
51 | USB-Type-B-4DIP | USB1 |  | 1
52 | XH2.54-3P | P4,P6,P8,P10,P11,P14,P21,P22 | HDR1X3_CON | 8
53 | XH2.54-2P | P5,P9,P12,P13,P19,P20,P29,P30,P15,P32 | HDR1X2_CON | 10
54 | XH2.54-4P-直插蓝色 | J1,J2,J3,J4,J5, |  | 5
57 | DC3-8P弯插 | P16 | DC3 | 1
59 | DC007B | P1 | DC007B | 1
60 | DB2ER-5.0-2P-GN | P2 | P5.0 | 2
