gqkhao/pcb-schematics/3轴6.0--esp32/BOM_esp32__2025-07-31.xlsx

No. | 数量 | Comment | Designator | Footprint
1 | 4 | 103 | C1,C4,C11,C16 | 11
2 | 1 | 100uF/35V | C2 | 电解电容贴片6X6
3 | 11 | 104 | C3,C6,C10,C17,C18,C19,C20,C23,C24,C25,C26 | 0603C
4 | 1 | 10uF | C5 | C1206
5 | 1 | 100uF/10V | C7 | CAP-SMD_BD5.0-L5.3-W5.3-RD
6 | 2 | 4.7uF | C8,C9 | C1206
7 | 2 | 33pF | C27,C28 | 0603C
8 | 1 | 104 | C30 | 11
9 | 1 | SS56 | D1 | SMA
10 | 1 | SS34 | D2 | SMA
11 | 3 | 绿光 | D3,D5,D7 | 0603LED
12 | 1 | PESD5V0L1BA-N | D4 | SOD-323_L1.8-W1.3-LS2.5-BI
13 | 1 | PESD3V3L1BA-N | D6 | SOD-323_L1.8-W1.3-LS2.5-BI
14 | 3 | 1N4148 | D8,D9,D10 | SOD-123_L2.8-W1.8-LS3.7-RD
15 | 1 | 68uH | L1 | IND-SMD_L7.0-W7.0_SMDRI74-330MT
16 | 1 | WJ2EDGR-5.08-2P | P1 | CONN-TH_WJ2EDGR-5.08-2P
17 | 5 | 3P | P2,P3,P4,P8,P19 | HDR1X3_CON
18 | 5 | 4P | P5,P6,P9,P12,P13 | HDR1X4_CON
19 | 1 | USB-B10-BRW | P16 | USB-B-TH_USB-B10-BRW
20 | 2 | SS8050 | Q2,Q3 | SOT-23-3_L2.9-W1.3-P1.90-LS2.4-BR
21 | 3 | 20K | R1,R4,R8 | 10
22 | 3 | 100 | R2,R5,R9 | 10
23 | 1 | 47K | R3 | 0603R
24 | 13 | 10K | R6,R7,R10,R14,R24,R28,R29,R32,R39,R40,R41,R42,R47 | 0603R
25 | 1 | 20K | R15 | 0603R
26 | 1 | 100 | R20 | 0603R
27 | 2 | 0Ω | R30,R31 | 0603R
28 | 4 | 10K | R63,R64,R66,R68 | 10
29 | 1 | XL1509-5.0E1 | U1 | ESOP-8
30 | 1 | 1117-3.3 | U2 | SOT-223
31 | 1 | 74LVC1G04 | U4 | SOT-23-5
32 | 1 | ESP32-WROOM-32 | U6 | ESP32-WROOM-32UE-A
33 | 1 | CA-IS3760 | U7 | SOIC-16_L9.9-W3.9-P1.27-LS6.0-BL
34 | 4 | 74LVC1G17 | U8,U9,U12,U13 | SOT-23-5
35 | 1 | CH340G | U14 | SOIC-16_
36 | 1 | USBLC2-2SC6 | U15 | SOT-23-6
37 | 1 | 自弹TF卡座TFAA | U16 | SIM-SMD_C9900015645
38 | 1 | 12M | Y1 | 晶振贴片49SSMD
