gqkhao/pcb-schematics/3轴6.0--esp32/BOM_esp32_2025-07-11.xlsx

序号 | 数量 | Comment | Designator | Footprint
1 | 6 | 103 | C1,C4,C12,C14,C15,C16 | 11
2 | 2 | 100uF/35V | C2,C8 | 电解电容贴片6X6
3 | 12 | 104 | C3,C6,C11,C17,C18,C19,C20,C21,C22,C23,C24,C25 | 0603C
4 | 2 | 10uF | C5,C28 | C1206
5 | 1 | 100uF/10V | C7 | CAP-SMD_BD5.0-L5.3-W5.3-RD
6 | 2 | 4.7uF | C9,C10 | C1206
7 | 1 | 100uF/35V(47uF/50V) | C13 | 电解电容贴片6X6
8 | 2 | 33pF | C26,C27 | 0603C
9 | 1 | SS56 | D1 | SMA
10 | 1 | SS34 | D2 | SMA
11 | 4 | 绿光 | D3,D5,D7,D8 | 0603LED
12 | 1 | PESD5V0L1BA-N | D4 | SOD-323_L1.8-W1.3-LS2.5-BI
13 | 1 | PESD3V3L1BA-N | D6 | SOD-323_L1.8-W1.3-LS2.5-BI
14 | 5 | 1N4148 | D9,D10,D11,D12,D13 | SOD-123_L2.8-W1.8-LS3.7-RD
16 | 2 | PZ254V-11-08P | H1,H2 | HDR-TH_8P-P2.54-V-M
17 | 1 | SW_6X6_H=12.0MM | K1 | KEY-SMD_4P-L6.0-W6.0-P4.50-LS9.0
18 | 1 | 68uH | L1 | IND-SMD_L7.0-W7.0_SMDRI74-330MT
19 | 1 | WJ2EDGR-5.08-2P | P1 | CONN-TH_WJ2EDGR-5.08-2P
20 | 5 | 3P | P2,P3,P5,P9,P15 | HDR1X3_CON
21 | 2 | 2P | P11,P12 | HDR1X2_CON
22 | 7 | 4P | P6,P7,P8,P10,P13,P14,P17 | HDR1X4_CON
23 | 1 | USB-B10-BRW | P16 | USB-B-TH_USB-B10-BRW
26 | 3 | SS8050 | Q3,Q4,Q5 | SOT-23-3_L2.9-W1.3-P1.90-LS2.4-BR
27 | 3 | 20K | R1,R4,R8 | 10
28 | 3 | 100 | R2,R5,R9 | 10
29 | 1 | 47K | R3 | 0603R
30 | 22 | 10K | R6,R7,R10,R16,R18,R25,R26,R27,R28,R29,R30,R33,R34,R35,R36,R39,R40,R41,R42,R43,R45,R48 | 0603R
34 | 4 | 1.8K | R15,R17,R20,R21 | 0603R
35 | 1 | 20K | R19 | 0603R
36 | 3 | 100 | R22,R23,R24 | 0603R
37 | 7 | 0Ω | R31,R32,R38,R44,R46,R47,R49 | 0603R
38 | 1 | 1K | R37 | 0603R
39 | 1 | XL1509-5.0E1//SXL1509-5.0E1 | U1 | ESOP-8_L4.9-W3.9-P1.27-LS6.0-BL-EP
40 | 1 | 1117-3.3 | U2 | SOT-223
41 | 1 | CJ7812 | U3 | TO-263-2_L10.1-W9.1-P5.08-LS15.2-TL
42 | 2 | 74LVC1G04 | U4,U9 | SOT-23-5
43 | 1 | ESP32-WROOM-32 | U5 | WIFI-SMD_ESP32-WROOM-32UE-A
44 | 1 | CA-IS3760 | U6 | SOIC-16_L9.9-W3.9-P1.27-LS6.0-BL
45 | 5 | 74LVC1G17 | U7,U8,U10,U11,U12 | SOT-23-5
46 | 1 | CH340G | U13 | SOIC-16_L9.9-W3.9-P1.27-LS6.0-BL
47 | 1 | USBLC2-2SC6 | U14 | SOT-23-6
48 | 1 | 12M | Y1 | 晶振贴片49SSMD
