gqkhao/pcb-schematics/3轴5.2/BOM_3轴5.2--.xlsx

No. | 数量 | Comment | Designator | Footprint | Name
1 | 3 | 100uF/63V | C1,C2,C20 | 电解电容贴片10x10 | 100uF/63V
2 | 19 | 104 | C3,C9,C14,C18,C19,C27,C38,C39,C40,C41,C42,C43,C44,C45,C81,C102,C106,C107,C108 | 0603C | 104
3 | 7 | 105 | C4,C12,C30,C31,C32,C33,C70 | 0805C | 105
4 | 2 | 10uF | C6,C8 | C1206 | 10uF
5 | 4 | 100uF/35V | C7,C10,C13,C15 | 电解电容贴片6X6 | 100uF/35V
6 | 7 | 103 | C17,C20,C23,C26,C60,C61,C62 | 0603C | 103
7 | 2 | 22pF | C21,C22 | 0603C | 22pF
8 | 2 | 100uF/35V | C24,C80 | 电解电容贴片6x6 | 100uF/35V
9 | 1 | 103? | C25 | 0603C | 103?
10 | 4 | 47uF/50V | C34,C35,C36,C37 | 电解电容贴片6X6 | 47uF/50V
11 | 4 | 224 | C46,C47,C48,C49 | 0603C | 224
12 | 2 | 33pF | C54,C55 | 0603C | 33pF
13 | 1 | 33nF | C56 | 0603C | 33nF
14 | 1 | SS34 | D1 | SMA | SS34
15 | 3 | 红光 | D4,D10,D13 | 0603LED | 红光
16 | 7 | SS56 | D5,D6,D7,D9,D11,D17,D18 | SMA | SS56
17 | 3 | 绿光 | D12,D15,D16 | 0603LED | 绿光
18 | 2 | 快恢复二极管RS2M | DZ1,DZ2 | SMC | 快恢复二极管RS2M
19 | 1 | 稳压二极管SMAZ10V | DZ4 | SMA | 稳压二极管SMAZ10V
20 | 4 | 4P | J6,J7,J8,J9 | SIP4 | 4P
21 | 1 | 按键 | K1 | 船型开关KCD1-101 | 按键
22 | 1 | 按键 | K2 | 按键6x6贴片 | 按键
23 | 2 | 47uH/5A | L1,L2 | 电感贴片12X12 | 47uH/5A
24 | 1 | 68uH | L3 | IND-SMD_L7.0-W7.0_SMDRI74-330MT | 68uH
25 | 1 | DC007B | P1 | DC007B | DC007B
26 | 1 | KF300 | P2 | 直插座4P-KF300 | KF300
27 | 8 | 3P | P3,P4,P7,P8,P11,P12,P14,P16 | HDR1X3_CON | 3P
28 | 6 | 2P | P5,P6,P9,P13,P23,P25 | HDR1X2_CON | 2P
29 | 1 | USB_TYPE-B | P10 | USB_TYPEB | USB_TYPE-B
30 | 1 | 2P-3.96 | P15 | 2P-P3.96 | 2P-3.96
31 | 1 | 2P | P17 | VH3.96-2P直插座 | 2P
32 | 1 | 8P | P18 | IDC8 | 8P
33 | 4 | 4P | P19,P20,P21,P22 | HDR1X4_CON | 4P
34 | 1 | 2P红色 | P24 | HDR1X2_CON | 2P红色
35 | 1 | KF300 | P27 | 直插座2P-KF300 | KF300
36 | 1 | Header 3X2 | P30 | HDR2X3 | Header 3X2
37 | 1 | SIP4 | P50 | SIP4
38 | 1 | F540NS | Q1 | TO-263-2 | F540NS
39 | 1 | F50N06 | Q2 | TO-252 | F50N06
40 | 1 | SS8050 | Q3 | SOT-23 | SS8050
41 | 1 | 16K | R1 | 0603R | 16K
42 | 23 | 10K | R2,R4,R11,R14,R19,R21,R45,R46,R47,R48,R49,R50,R51,R57,R58,R66,R67,R68,R70,R72,R73,R81,R90 | 0603R | 10K
43 | 6 | 1K | R3,R27,R71,R76,R77,R78 | 0603R | 1K
44 | 1 | 44.2K | R6 | 0603R | 44.2K
45 | 2 | 1.8K | R7,R75 | 0603R | 1.8K
46 | 1 | 2.37K | R8 | 0603R | 2.37K
47 | 1 | 680!! | R15 | 0603R | 680!!
48 | 13 | 100 | R16,R22,R25,R52,R59,R60,R61,R62,R63,R64,R65,R80,R91 | 0603R | 100
49 | 8 | 0.1 | R29,R30,R31,R32,R33,R34,R35,R36 | 0805R | 0.1
50 | 4 | 20K | R37,R38,R39,R40 | 0603R | 20K
51 | 4 | 10K | R41,R42,R43,R44 | 松下贴片电位器3x3 | 10K
52 | 4 | 0 | R53,R54,R55,R56 | 0603R | 0
53 | 1 | 1K? | R74 | 0603R | 1K?
54 | 1 | 1K!! | R100 | 0603R | 1K!!
55 | 2 | 10k | R102,R104 | 0603R | 10k
56 | 1 | 0603R | R103 | 0603R
57 | 1 | LM2576HVS-ADJ | U2 | TO-263 | LM2576HVS-ADJ
58 | 1 | XL4015 | U3 | TO-263 | XL4015
59 | 1 | STM32F103C8T6/CBT6 | U4 | LQFP48 | STM32F103C8T6/CBT6
60 | 1 | 1117-3.3 | U5 | SOT-223 | 1117-3.3
61 | 1 | CH340G | U6 | SOP16 | CH340G
62 | 1 | XL1509-5.0E1//SXL1509-5.0E1 | U7 | ESOP-8_L4.9-W3.9-P1.27-LS6.0-BL-EP | XL1509-5.0E1//SXL1509-5.0E1
63 | 4 | HR4988SQ | U8,U9,U10,U11 | QFN28 | HR4988SQ
64 | 1 | 74LVC1G04 | U15 | SOT-23-5 | 74LVC1G04
65 | 1 | 74LVC1G17 | U16 | SOT-23-5 | 74LVC1G17
66 | 1 | 12M | Y1 | 晶振贴片49SSMD | 12M
67 | 1 | 8M | Y2 | 晶振贴片 | 8M
