gqkhao/pcb-schematics/3轴5.2/3轴5.2--BOM.xlsx

型号：3轴5.2-PCB-V3.4
元件 | 位号 | 封装 | 用量
100uF/63V 电解贴片 | C1, C2 | 电解电容贴片10x10 | 2
105/50V | C4, C12, C30, C31, C32, C33, C70 | 0805C | 7
100uF/35V 电解贴片 | C5, C7, C10, C13, C15, C24, C80 | 电解电容贴片6X6 | 7
104/50V | C9, C14, C16, C18, C19, C27, C38, C39, C40, C41, C42, C43, C44, C45, C52, C81, C102, C106, C107, C108 | 0603C | 20
103/50V | C17, C20, C23, C26, C60, C61, C62 | 0603C | 7
22pF/50V | C21, C22 | 0603C | 2
47uF/50V 电解贴片 | C34, C35, C36, C37 | 电解电容贴片6X6 | 4
224 25V | C46, C47, C48, C49 | 0603C | 4
33pF/50V | C54, C55 | 0603C | 2
33nF/25v | C56 | 0603C | 1
红光-LED | D4, D10, D13 | 0603LED | 3
SS56 | D5, D6, D7, D11, D17, D18 | SMA | 6
绿光-LED | D12, D15, D16 | 0603LED | 3
二极管RS5M | DZ1, DZ2 | SMC | 2
稳压管1SMA4740 | DZ4 | SMA | 1
47uH/5A 1265 | L1, L2 | 电感贴片12X12 | 2
红柄四脚轻触 6*6*9 | K2 | 按键6x6贴片 | 1
USB TYPE B 方口插件 | P10 | USB-TYPE-B-4DIP | 1
CS50N20 | Q1 | TO-263-2 | 1
F50N06 | Q2 | TO-252 | 1
SS8050 | Q3 | SOT-23 | 1
16K 1% | R1 | 0603R | 1
1K 1% | R3, R27, R71, R76, R77, R78、R100 | 0603R | 7
10K 1% | R4, R11, R14, R19, R21, R45, R46, R47, R48, R49, R50, R51, R57, R58, R66, R67, R68, R70, R72, R73, R81, R90, R102, R104,R103 | 0603R | 25
44.2K 1% | R6 | 0603R | 1
1.8K 1% | R7, R75 | 0603R | 2
2.37K 1% | R8 | 0603R | 1
680R 1% | R15 | 0603R | 1
100R 1% | R16, R22, R25, R52, R59, R60, R61, R62, R63, R64, R65, R80, R91 | 0603R | 13
0.1R 1% | R29, R30, R31, R32, R33, R34, R35, R36 | 0805R | 8
20K 1% | R37, R38, R39, R40 | 0603R | 4
0R 1% | R53, R54, R55, R56 | 0603R | 4
VGF39NCHXTB103-北陆 | R41, R42, R43, R44 | 10K 3*3电位器 | 4
CJ7805 | U1 | TO-263-2 | 1
LM2576HVS-ADJ UMW | U2 | TO-263 | 1
XL4015 | U3 | TO-263 | 1
GD32F303CCT6 | U4 | LQFP48 | 1
1117-3.3 | U5 | SOT-223 | 1
CH340G | U6 | SOP16 | 1
HR4988SQ | U8, U9, U10, U11 | QFN28 | 4
74LVC1G04 | U15 | SOT-23-5 | 1
74LVC1G17 | U16 | SOT-23-5 | 1
12M | Y1 | 晶振贴片49SSMD | 1
8M | Y2 | 晶振贴片 | 1
以下为插件物料
DC007B-2.5孔镀金 | P1 | DC007B | 1
KF300 -2P 红色-订做 | P2-1（48V） | 直插座2P-KF300 | 1
KF300 -2P 蓝色-常规 | P2-2，P27 | 直插座2P-KF300 | 2
XH 3P 2.54 黑色 | P3, P4, P16 | HDR1X3_CON | 3
XH 3P 2.54 红色 | P11, P12, P14, |  | 3
XH 3P 2.54 白色 | P7, P8, |  | 2
XH 2P 2.54 黑色 | P9, P13, P23, P24,P25 | HDR1X2_CON | 5
XH 2P 2.54 蓝色 | P5 | HDR1X2_CON | 1
XH 2P 2.54 白色 | P6 |  | 1
4P XH 2.54 黑色 | P22 | HDR1X4_CON | 1
4P XH 2.54 红色 | P21 |  | 1
4P XH 2.54 蓝色 | P20 |  | 1
4P XH 2.54 绿色 | P19 |  | 1
4P 2.54 排针 | J6, J7, J8, J9 | SIP4 | 4
船型开关KCD1-101 | K1 |  | 1
VH3.96-2P 黑色 | P17、P15 | VH3.96-2P直插座 | 2
直插简牛-2.54-2*4P 黑 | P18 | IDC8 | 1
2.54排针 3X2 | P30 | HDR2X3 | 1
