gqkhao/pcb-schematics/3020机器转接板/X轴转接板--BOM.xlsx

序号 | 数量 | Comment | 位号 | Footprint | 备注参考
1 | 3 | 10uF | C1,C2,C3,C4,C5,C6 | C1206
2 | 2 | 弯针XH 3P 2.54 白色 | P1,P2 | XH2.54
3 | 1 | 弯针XH 4P 2.54 白色 | P3 | CONN-TH_3P-P2.50_XH-3A
4 | 1 | 2*4P双排弯针座XHD2.54 | P4 | XHD2.54-2*4P | https://detail.tmall.com/item.htm?abbucket=5&id=747284687322
5 | 1 | 弯针微动端子限位开关左开 | SW1 | 弯针微动端子限位开关
6 | 1 | 弯针微动端子限位开关右开 | SW2 | 弯针微动端子限位开关
板子要喷三防漆
