gqkhao/pcb-schematics/3020-2.0包裹款/BOM--触摸屏电路板-2026-03-25.xlsx

No. | 数量 | Comment | 位号 | Footprint
1 | 2 | 100uF/35V | C1,C10 | 电解电容贴片6X6
2 | 18 | 104 | C2,C3,C9,C12,C13,C15,C16,C17,C18,C19,C20,C21,C22,C23,C24,C25,C26,C27 | 0603C
3 | 4 | 4.7uF(10uF) | C4,C5,C14,C6 | 1206C
4 | 3 | 100uF/10V(10uF) | C7,C8,C11 | 电解电容贴片BD5.0
5 | 3 | SS56 | D1,D2,D6 | SMA
6 | 2 | 绿光 | D3,D5 | 0603LED
7 | 1 | PESD5V0L1BA-N | D4 | SOD-323_L1.8
8 | 1 | USBLC6-2SC6 | D7 | SOT-23-6_L2.9
9 | 2 | 1N4148WS | D8,D9 | SOD-323_L1.8-W1.3
10 | 1 | LED红 | D10 | 0603L
11 | 1 | FPC-05F-6PH20(0.5) | FPC1 | P0.50_XUNPU_FPC
12 | 1 | AFC07-S40ECA-00 | FPC3 | FPC-SMD_P0.50-40P_LCS-SJ
13 | 1 | 68uH | L1 | IND-SMD_L7.0-W7.0_SMDRI74
14 | 1 | 10uH | L2 | IND-SMD_L7.0-W7.0_SMDRI74
15 | 1 | 10uH | L3 | L0603
16 | 1 | KF2EDGVC-5.08-2P | P1 | CONN-TH_P5.08_KF2EDGVC
17 | 2 | 4P | P2,P3 | HDR1X4_CON
18 | 3 | SS8050 | Q1,Q2,Q3 | SOT-23-3_L2.9-W1.3-P1.90-LS2.4-BR
19 | 1 | 47K | R1 | 0603R
20 | 11 | 10K | R2,R3,R5,R6,R7,R13,R14,R15,R16,R18,R19 | 0603R
21 | 9 | 10K | R4,R12,R20,R21,R22,R27,R28,R29,R30 | 10
22 | 1 | 50Ω | R8 | 0603R
23 | 1 | 1K | R9 | 10
24 | 2 | 10Ω | R10,R11 | 0603R
25 | 1 | 0Ω | R17 | 10
26 | 4 | 100Ω | R23,R24,R25,R26 | 0603R
27 | 1 | XL1509-5.0 | U1 | ESOP-8_L4.9-W3.9
28 | 2 | 1117-3.3 | U2,U4 | SOT-223
29 | 1 | RY3730 | U3 | SOT-23-6_L2.9-W1.6
30 | 1 | ESPS3-32-WROOM | U5 | WIRELM-SMD_ESP32-S3-WROOM
31 | 1 | CH340C | U6 | SOIC-16_L9.9-W3.9
32 | 1 | SP3232EEN-L/TR | U7 | SOIC-16_L9.9-W3.9
33 | 1 | 自弹TF卡座TFAA | U8 | SIM-SMD_
34 | 1 | U-USBAR04P-F002 | USB1 | USB-A-TH_USB-302-T
35 | 1 | TYPE-C 16PIN | USB2 | USB-C-SMD_TYPE-C
36 | 2 | U-USBAS04P-F001 | USB3,USB4 | USB-A-TH_USB-M-22
