gqkhao/pcb-schematics/3020-2.0包裹款/BOM--摄像头电路板-2026-03-25.xlsx

No. | 数量 | Comment | 位号 | Footprint
1 | 3 | 10uF | C1,C6,C21 | C1206
2 | 2 | 1uf | C2,C5 | 0603C
3 | 7 | 1uf | C13,C4,C16,C17,C18,C19,C20 | 0603C
4 | 3 | 10uF(4.7uF) | C7,C9,C12 | 0805C
5 | 4 | 1uf | C8,C10,C11,C14 | 0603C
6 | 3 | 104 | C3,C15,C22 | C0603
7 | 1 | USBLC6-2SC6 | D1 | SOT-23-6_L2.9-W1.6-P0.95
8 | 2 | LED | D2/NC,D3 | 0603L
9 | 1 | FPC-05F-24PH20 | FPC1 | FPC-SMD_24P-P0.50_FPC-
12 | 3 | 5.1K | R5,R6,R7 | 0603R
13 | 6 | 22K | R8,R1,R2,R3,R4,R13 | 0603R
14 | 2 | 100Ω | R9,R10 | 0603R
15 | 2 | 100Ω | R11,R12 | 0603R
16 | 1 | 1117-3.3 | U1 | SOT-223
17 | 1 | VRD1228MTX | U2 | SOT-23-6_L2.9-W1.6-P0.95
18 | 1 | ESP32-S3-WROOM-1U | U3 | ESP32-S3-WROOM-1U
19 | 1 | SP3232EEN-L/TR | U4 | SOIC-16_L9.9-W3.9-P1.27
20 | 2 | TYPE-C 16PIN | USB1,USB2 | USB-C-SMD_TYPE-C-6PIN
