gqkhao/pcb-schematics/2轴4.0/BOM_2轴4.6---02-08+.xlsx

No. | Quantity | Comment | Designator | Footprint | Value | Name
1 | 9 | 104 | C1,C2,C3,C6,C9,C15,C16,C25,C26 | 0603C |  | 104
2 | 2 | 22pF | C4,C5 | 0603C | 100pF | 22pF
3 | 3 | 105 | C7,C17,C28 | 0805C |  | 105
4 | 6 | 104 | C8,C19,C27,C32,C34,C35 | 0603C | 104 | 104
5 | 3 | 224 | C10,C18,C31 | 0603C |  | 224
6 | 4 | 100uF/35V | C11,C20,C24,C33 | 电解电容贴片6X6 |  | 100uF/35V
7 | 3 | 105 | C12,C14,C22 | C0603 |  | 105
8 | 3 | 100uF/35V | C13,C21,C38 | 电解电容贴片6x6 |  | 100uF/35V
9 | 1 | 104 | C23 | C0603 |  | 104
10 | 2 | 33pF | C29/NC,C30/NC | 0603C | 18pF | 33pF
11 | 2 | 103 | C36,C37 | 0603C |  | 103
12 | 1 | PESD12VL1BA | D1 | SOD-323_L1.8-W1.3-LS2.5-BI |  | PESD12VL1BA
13 | 3 | 红光 | D2,D6,D9 | 0603LED |  | 红光
14 | 3 | SS56 | D3,D4,D10 | SMA |  | SS56
15 | 1 | 绿光 | D5 | 0603LED |  | 绿光
16 | 1 | PESD5V0L1BA-N | D7 | SOD-523_L1.2-W0.8-LS1.6-BI |  | PESD5V0L1BA-N
17 | 1 | PESD3V3L1BA-N | D8 | SOD-523_L1.2-W0.8-LS1.6-BI |  | PESD3V3L1BA-N
18 | 1 | 按键 | K1 | 按键18X13 |  | 按键
19 | 1 | 开关 | K2 | 按键6X6贴片 |  | 开关
20 | 1 | 33uH | L1 | IND-SMD_L7.0-W7.0_SMDRI74-330MT | 33uH | 33uH
21 | 1 | 3P | P1 | DC0044A |  | 3P
22 | 1 | 4P | P2 | SIP4
23 | 3 | 4P | P3,P5,P7 | HDR1X4_P |  | 4P
24 | 2 | 2P | P4,P6 | HDR1X2_P |  | 2P
25 | 3 | 3P | P8,P9,P10 | HDR1X3_P |  | 3P
26 | 1 | 8P | P11 | IDC8弯脚 |  | 8P
27 | 1 | USB-B10-BRW | P12 | J1 |  | USB-B10-BRW
28 | 2 | SS8050 | Q1,Q2 | SOT-23 |  | SS8050
29 | 1 | SI2301CDS-T1-GE3 | Q3 | SOT-23-3_L3.0-W1.7-P0.95-LS2.9-BR |  | SI2301CDS-T1-GE3
30 | 3 | 10k | R1,R2,R3 | 0603R | 10K | 10k
31 | 6 | 0.1 | R4,R7,R13,R15,R22,R26 | 0805R |  | 0.1
32 | 4 | 100 | R5,R14,R25,R36 | 0603R |  | 100
33 | 5 | 10K | R6,R8,R16,R27,R30 | 0603R | 10K | 10K
34 | 3 | 10K | R9,R17,R28 | 0603R |  | 10K?
35 | 6 | 10K | R10,R18,R21,R40,R42,R43 | 0603R |  | 10K
36 | 3 | 30K | R11,R19,R32 | 0603R |  | 30K
37 | 3 | 10K | R12,R20,R33 | 松下贴片电位器3X3 |  | 10K
38 | 4 | 510Ω | R23,R24,R37,R38 | 0603R |  | 510Ω
39 | 6 | 2K | R29,R31,R45,R46,R47,R48 | 0603R |  | 2K
40 | 2 | 20K | R34,R35 | 0603R | 10K | 20K
41 | 1 | 5.1K | R39 | 0603R |  | 5.1K
42 | 2 | 1K | R41,R44 | 0603R |  | 1K
43 | 3 | HR4988SQ | U1,U4,U6 | QFN28 |  | HR4988SQ
44 | 1 | STM32F103C8T6/CBT6 | U2 | LQFP48 |  | STM32F103C8T6/CBT6
45 | 1 | LM2596S-5.0RG | U3 | TO-263-5_L10.1-W8.7-P1.70-LS15.2-BR |  | LM2596S-5.0RG
46 | 1 | 1117-3.3 | U5 | SOT-223 |  | 1117-3.3
47 | 1 | CH340G/CH340C | U7 | SOP16 |  | CH340G/CH340C
48 | 6 | 74LVC1G17 | U8,U10,U11,U12,U13,U14 | SOT-23-5 |  | 74LVC1G17
49 | 1 | MSUSBLC6-2SC6 | U9 | SOT-23-6_L2.9-W1.6-P0.95-LS2.8-BL |  | MSUSBLC6-2SC6
50 | 1 | 8M | Y1 | 晶振贴片 |  | 8M
51 | 1 | 12M | Y2/NC | 晶振贴片49SSMD |  | 12M
