gqkhao/pcb-schematics/2轴4.0/BOM_2轴4.6---02-08++.xlsx

2轴4.6-v3版本BOM
序号 | 名称 | 封装 | 规格 | 位号 | 用量 | 备注
1 | 贴片电阻 | 0805R | 0.1Ω | R4,R6,R7,R8,R10,R12,R27,R29,R30,R33 | 10
2 | 贴片电阻 | 0603R | 10K | R1,R2,R3,R5,R9,R11,R25,R26,R28,R31,R14,R18,R22,R35,R37,R40,R41,R44 | 10+8
3 | 贴片电阻 | 0603R | 30K | R13,R15,R19,R34,R36 | 5
4 | 贴片电阻 | 0603R | 100Ω | R32 | 1
5 | 贴片电阻 | 0603R | 44.2K | R45 | 1
6 | 贴片电阻 | 0603R | 20K | R46 | 1
7 | 贴片电阻 | 0603R | 2.37K | R47 | 1
8 | 贴片电阻 | 0603R | 0Ω | R17,R21,R24,R39,R43 | 6
9 | 贴片电位器 | 贴片电位器3x3 | 10K | R16,R20,R23,R38,R42 | 5
10 | 贴片电容 | 0603C | 0.1uF/50V | C2,C4,C6,C7,C8,C9,C10,C11,C12,C14,C16,C17,C18,C19,C20,C23 | 16
11 | 贴片电容 | 0805C | 1uF/50V | C25 | 1
12 | 贴片电容 | 电解电容贴片6x6 | 47uF/50V | C1,C3,C5,C13,C15,C24 | 6
13 | 贴片电容 | 电解电容贴片10x10 | 100uF/63V | C21,C22 | 2
14 | 贴片LED | 0603LED | 绿光 | D24 | 1
15 | 贴片二极管 | SMA | SS56 | D1,D2,D3,D4,D5,D6,D7,D8,D9,D10,D11,D12,D13,D14,D15,D16,D17,D18,D19,D20,D21,D22,D23 | 23
16 | 功率电感 | IND-SMD_L13.45-W12.6 | 47uH/5A | L1 | 1
17 | 排针 | 2.54间距 | 2.54间距排针 | P10,P14 | 2
18 | 单排座 | 5.08间距-2P | 5.08-2P | P4,P13 | 2
19 | 单排座 | HDR1X4_2.54间距 | 4P | P1,P2,P3,P5,P6,P7,P8,P9,P11,P12 | 10
20 | 贴片IC | TO-263 | LM2576HVS-ADJ | U6 | 1
21 | 贴片IC | SSOP-28 | HR8825 | U1,U2,U3,U4,U5 | 5
