gqkhao/pcb-schematics/电机驱动TB6600/原电机驱动板/BOM_电机驱动板.xlsx

No. | 数量 | Comment | Designator | Footprint | Name
1 | 4 | 100uF/63V | C1,C6 | 电解电容贴片 | 47uF/50V
2 | 12 | 104 | C2,C4,C7,C8,C10,C11,C14,C16,C17,C18,C19,C20 | C0603 | 104
3 | 1 | 100uF/35V | C24 | 电解电容贴片 | 100uF/35V
4 | 14 | 105 | C,C,C,C,C,C,C,C,C,C,C,C,C23,C25 | 0805C | 105
5 | NC不焊接 | SS56 | D1,D2,D4,D5,D6,D7,D9,D10,D11,D12,D14,D15,D16,D17,D19,D20 | SMA | SS56
6 | 8 | 4P | P1,P2,P5,P6,P8,P9,P11,P12 | HDR1X4_CON | 4P
7 | 1 | Header 3X2 | P10 | HDR2X3 | Header 3X2
8 | 1 | WJ2EDGVC-5.08-2P | P13 | CONN-TH_WJ2EDGVC-5.08-2P | WJ2EDGVC-5.08-2P
9 | 2 | PZ254V-11-02P | P14,P14 | HDR-TH_2P-P2.54-V-M | PZ254V-11-02P
10 | 8 | 0.1 | R4,R6,R8,R10,R27,R29,R30,R33 | 0805R | 0.1
11 | NC不焊接 | 30K | R13,R15,R34,R36 | 0603R | 30K
12 | 7 | 10K | R14,R18,R35,R37,R40,R41,R44 | 0603R | 10K
13 | 4 | 10K | R16,R20,R38,R42 | 松下贴片电位器3x3 | 10K
15 | 1 | 0 | R32 | 0603R | 0
16 | 4 | HR8825 | U1,U2,U4,U5 | HTSSOP-28_L9.7-W4.4-P0.65-LS6.4-BL-EP-1 | HR8825
