gqkhao/pcb-schematics/电机驱动TB6600/TB6600驱动板/BOM_LY-TB6600-V1.0.xls

BOM_LY_TB6600_V1.0
NO. | 类别 | 元件 | 位号 | 封装 | 用量
1 | 电容 | 100NF/50V | C1 C3 C5 | 0603 | 3
2 |  | 1UF/50V | C2 C6 C7 | 0603 | 3
3 |  | 470UF50V | C4 | DIP-10*21 | 1
4 | 电阻 | 0.62R 1% | R17 R18 R19 R6 R7 R8 | 2512 | 6
5 |  | 12K 5% | R3 | 0603 | 1
6 |  | 1K 5% | R15 | 0603 | 1
7 |  | 330R 5% | R10 R14 R4 | 0603 | 3
8 |  | 4.7K 5% | R12 R16 R20 R21 R22 R5 | 0603 | 6
9 |  | 5.1K 5% | R13 R2 | 0603 | 2
10 |  | 51K 5% | R1 | 0603 | 1
11 |  | 560K 5% | R9 | 0603 | 1
12 |  | 56K 5% | R11 | 0603 | 1
13 | 电位器 | P103(10K) | R23 | 3362 | 1
14 | TVS | CR | D6 | SMB | 1
15 | 二极管 | SS54 | D5 | SMB | 1
16 | LED | 红光 | ALE PWR RUN | 0603 | 3
17 | 针座 | XH2.54-4P-白色 | J1 J4 | XH2.54 | 2
18 |  | 2EDG-2P直插 | J3 | 5.08 | 1
19 | 拨码开关 | DS-4P红色 | SW1 | DIP-8P-2.54 | 1
20 | IC | 74HC123D | U2 | SOP16 | 1
21 | 光耦 | CT 521GB | U5 | DIP4 | 1
22 | 光耦 | EL4N35 | U4 | DIP6 | 1
23 | 光耦 | EL6N137 | U3 | DIP8 | 1
24 | 驱动IC | TB6600 | U1 | 25P | 1
 |  |  | 以下NC
25 | / | NC | R26 R27 |  | 2
26 | / | KF128-4P-绿色 | J2 | KF128 | 1
