gqkhao/pcb-schematics/4轴3.0/BOM和Gerber制板文件（LY-4X3.0-V3.4）/BOOM_4轴3.0.xls

Comment | Description | Designator | Footprint | LibRef | Quantity
104 | Capacitor (Semiconductor SIM Model), [NoValue] | C1, C5, C6, C7, C8, C9, C70, C71, C72, C73, C85 | 0603C | Cap Semi, CAP | 11
22pF | Capacitor (Semiconductor SIM Model) | C2, C3 | 0603C | Cap Semi | 2
220uF/16V |  | C4 | 电解电容贴片6x6 | ELECTRO1 | 1
47uF/50V |  | C86 | 电解电容贴片6x6 | ELECTRO1 | 1
22uF/35V |  | C87 | 电解电容贴片5x5 | ELECTRO1 | 1
绿光 |  | D1 | 0603LED | LED | 1
S4 |  | D2 | SOD-123 | 1N4148 | 1
红光 |  | D20 | 0603LED | LED | 1
开关 |  | K1 | 按键6x6贴片 | 开关 | 1
 |  | P1, P4 | SIP4 | 4P | 2
8P |  | P2 | IDC8 | 8P | 1
Header 4X2H | Header, 4-Pin, Dual row, Right Angle | P3 | HDR2X4H | Header 4X2H | 1
USB座TYPE-C-16P |  | P5 | USB-TYPE-C-16P-全贴片 | USB座TYPE-C-16P | 1
2P红色 |  | P10, P11 | HDR1X2_CON | 2P | 2
2P |  | P12, P23, P24 | HDR1X2_CON | 2P | 3
3P |  | P13, P30 | HDR1X3_CON | 3P | 2
10k | Resistor | R1, R2, R3, R8, R70, R71, R72, R73, R85 | 0603R | RES | 9
100 | Resistor | R4, R5, R15 | 0603R | RES | 3
2K | Resistor | R6 | 0603R | RES | 1
1K | Resistor | R7, R9, R80 | 0603R | RES | 3
470 | Resistor | R45, R46 | 0603R | RES | 2
1.8K | Resistor | R59 | 0603R | RES | 1
STM32F103C8T6/CBT6 | STM32 ARM-based 32-bit MCU with 32 Kbytes Flash, 48-pin LQFP, Industrial Temperature | U1 | LQFP48 | STM32F103C6T6 | 1
74LVC1G126/74LVC1G08 |  | U6 | SOT-23-5 | 74LVC1G126 | 1
6N137 |  | U21 | SMD8 | 6N137 | 1
8M | Crystal Oscillator | Y1 | 晶振贴片 | XTAL | 1
