gqkhao/pcb-schematics/3轴5.2/3轴5.2-V3.4_改丝印/BOM_3轴5.2.xlsx

No. | Quantity | Comment | Designator | Footprint | Name
1 | 2 | 100uF/63V | C1,C2 | 电解电容贴片10x10 | 100uF/63V
2 | 7 | 105 | C4,C12,C30,C31,C32,C33,C70 | 0805C | 105
3 | 5 | 100uF/35V | C5,C7,C10,C13,C15 | 电解电容贴片6X6 | 100uF/35V
4 | 20 | 104 | C9,C14,C16,C18,C19,C27,C38,C39,C40,C41,C42,C43,C44,C45,C52,C81,C102,C106,C107,C108 | 0603C | 104
5 | 7 | 103 | C17,C20,C23,C26,C60,C61,C62 | 0603C | 103
6 | 2 | 22pF | C21,C22 | 0603C | 22pF
7 | 2 | 100uF/35V | C24,C80 | 电解电容贴片6x6 | 100uF/35V
8 | 1 | 103? | C25 | 0603C | 103?
9 | 4 | 47uF/50V | C34,C35,C36,C37 | 电解电容贴片6X6 | 47uF/50V
10 | 4 | 224 | C46,C47,C48,C49 | 0603C | 224
11 | 2 | 33pF | C54,C55 | 0603C | 33pF
12 | 1 | 33nF | C56 | 0603C | 33nF
13 | 3 | 红光 | D4,D10,D13 | 0603LED | 红光
14 | 7 | SS56 | D5,D6,D7,D9,D11,D17,D18 | SMA | SS56
15 | 3 | 绿光 | D12,D15,D16 | 0603LED | 绿光
16 | 2 | 快恢复二极管RS2M | DZ1,DZ2 | SMC | 快恢复二极管RS2M
17 | 1 | 稳压二极管SMAZ10V | DZ4 | SMA | 稳压二极管SMAZ10V
18 | 4 | 4P | J6,J7,J8,J9 | SIP4 | 4P
19 | 1 | 按键 | K1 | 船型开关KCD1-101 | 按键
20 | 1 | 按键 | K2 | 按键6x6贴片 | 按键
21 | 2 | 47uH/5A | L1,L2 | 电感贴片12X12 | 47uH/5A
22 | 1 | DC007B | P1 | DC007B | DC007B
23 | 1 | KF300 | P2 | 直插座4P-KF300 | KF300
24 | 8 | 3P | P3,P4,P7,P8,P11,P12,P14,P16 | HDR1X3_CON | 3P
25 | 6 | 2P | P5,P6,P9,P13,P23,P25 | HDR1X2_CON | 2P
26 | 1 | USB_TYPE-B | P10 | USB_TYPEB | USB_TYPE-B
27 | 1 | 2P-3.96 | P15 | 2P-P3.96 | 2P-3.96
28 | 1 | 2P | P17 | VH3.96-2P直插座 | 2P
29 | 1 | 8P | P18 | IDC8 | 8P
30 | 4 | 4P | P19,P20,P21,P22 | HDR1X4_CON | 4P
31 | 1 | 2P红色 | P24 | HDR1X2_CON | 2P红色
32 | 1 | KF300 | P27 | 直插座2P-KF300 | KF300
33 | 1 | Header 3X2 | P30 | HDR2X3 | Header 3X2
34 | 1 | SIP4 | P50 | SIP4
35 | 1 | F540NS | Q1 | TO-263-2 | F540NS
36 | 1 | F50N06 | Q2 | TO-252 | F50N06
37 | 1 | SS8050 | Q3 | SOT-23 | SS8050
38 | 1 | 16K | R1 | 0603R | 16K
39 | 6 | 1K | R3,R27,R71,R76,R77,R78 | 0603R | 1K
40 | 22 | 10K | R4,R11,R14,R19,R21,R45,R46,R47,R48,R49,R50,R51,R57,R58,R66,R67,R68,R70,R72,R73,R81,R90 | 0603R | 10K
41 | 1 | 44.2K | R6 | 0603R | 44.2K
42 | 2 | 1.8K | R7,R75 | 0603R | 1.8K
43 | 1 | 2.37K | R8 | 0603R | 2.37K
44 | 1 | 680!! | R15 | 0603R | 680!!
45 | 13 | 100 | R16,R22,R25,R52,R59,R60,R61,R62,R63,R64,R65,R80,R91 | 0603R | 100
46 | 8 | 0.1 | R29,R30,R31,R32,R33,R34,R35,R36 | 0805R | 0.1
47 | 4 | 20K | R37,R38,R39,R40 | 0603R | 20K
48 | 4 | 10K | R41,R42,R43,R44 | 松下贴片电位器3x3 | 10K
49 | 4 | 0 | R53,R54,R55,R56 | 0603R | 0
50 | 1 | 1K? | R74 | 0603R | 1K?
51 | 1 | 1K!! | R100 | 0603R | 1K!!
52 | 2 | 10k | R102,R104 | 0603R | 10k
53 | 1 | 0603R | R103 | 0603R
54 | 1 | CJ7805 | U1 | TO-263-2 | CJ7805
55 | 1 | LM2576HVS-ADJ | U2 | TO-263 | LM2576HVS-ADJ
56 | 1 | XL4015 | U3 | TO-263 | XL4015
57 | 1 | STM32F103C8T6/CBT6 | U4 | LQFP48 | STM32F103C8T6/CBT6
58 | 1 | 1117-3.3 | U5 | SOT-223 | 1117-3.3
59 | 1 | CH340G | U6 | SOP16 | CH340G
60 | 4 | HR4988SQ | U8,U9,U10,U11 | QFN28 | HR4988SQ
61 | 1 | 74LVC1G04 | U15 | SOT-23-5 | 74LVC1G04
62 | 1 | 74LVC1G17 | U16 | SOT-23-5 | 74LVC1G17
63 | 1 | 12M | Y1 | 晶振贴片49SSMD | 12M
64 | 1 | 8M | Y2 | 晶振贴片 | 8M
