gqkhao/pcb-schematics/2轴4.0/BOM和Gerber制板文件（采购用LY-2X4.5-V4-ESD）/BOM--2轴4.0.xls

2轴4.6-v3版本
NO | 元件 | 位号 | 封装 | 用量 | 备注
1 | 104/50v | C2, C3, C4, C9,C10, C13, C14, C15, C16, C20, C23, C27, C28, C30, C31, C35, C43, C44, C50 | 0603 | 19
2 | 103/50V | C5, C7, C18 | 0603 | 3
3 | 100uf/35V | C1, C6, C8, C19, C24, C25 | 电解6.3*7.7 | 6
4 | 22pf 50v | C11,C12 | 0603 | 2
5 | 105/50V | C17, C21, C22 | 0805 | 3
6 | 224/25V | C26, C33, C34 | 0603 | 3
7 | SS54 | D1, D4 | SMA | 2
8 | LED-红灯 | D2, D3, D6 | 0603 | 3
9 | LED-绿灯 | D5 | 0603 | 1
10 | AE(SMBJ5.0CA) | D7 | SMB | 1
11 | 6*6*12 | K2 | K2 | 1
12 | MMBT5551 | Q1, Q2, Q4 | SOT-23 | 3
13 | MMBT5401 | Q3 | SOT-23 | 1
14 | 1K | R1, R7, R31 | 0603 | 3
15 | 2K/0603 | R2, R9, R13, R17, R24, R47 | 0603 | 6
16 | 10K/0603 | R3, R4, R5,R6, R10, R12, R14, R25, R34,R8, R16, R28, R32, R33, R38, R39, R43, R45, R46 | 0603 | 19
17 | 100R/0603 | R11, R18, R19, R35, R36, R44, R51, R52 | 0603 | 8
18 | 5.1K/0603 | R15 | 0603 | 1
19 | R100 1% | R20, R21, R22, R23, R37, R40 | 0805 | 6
20 | 30K/0603 | R26, R27, R41 | 0603 | 3
21 | 3*3 10K | R29, R30, R42 | 0603 | 3
22 | 470R/0603 | R48, R49 | 0603 | 2
23 | 1M/0603 | R50 | 0603 | 1
24 | 7805 | U1 | TO263-3 | 1
25 | 1117-3.3 | U2 | SOT-223 | 1
26 | NC | U3 | U3 | 1
27 | GD32F303CCT6 | U4 | LQFP-48 | 1
28 | HR4988 | U5, U6, U7 | U5 | 3
29 | UL26 | U8 | SOT23-6 | 1
30 | CH340G | U9 | SOP-16 | 1
31 | 74LVC1G17 | U10 | SOT23-5 | 1
32 | PESD5V0L1BA | D9 | SOD-523 | 1 | 5V(TVS/ESD)
33 | PESD3V3L1BA | D8 | SOD-523 | 1 | 3.3V(TVS/ESD)
34 | 8M | Y1 | HC49S | 1
35 | 12M(CSTNE12M0G520000R0 ) | Y2 |  | 1
36 | PCB | 1.6 哑黑 白字 无铅喷锡 1*4 |  | 1
 | 插件装配物料
37 | KAN-9A | K1 | K1 | 1
38 | DC044A | P1 | P1 | 1
39 | XH2.54-3P-90 | P2, P5, P7 | XH-2.54 | 3
40 | XH2.54-2P-90 | P6, P19 | XH-2.54 | 2
41 | XH2.54-4P-90 | P16, P17, P18 | XH-2.54 | 3
42 | DC3-8P | P14 | IDC | 1
43 | USB TYPE B | J1 | DIP-6P | 1
44 | 蜂鸣器有源09055 | B1 | B1 | 1
