gqkhao/pcb-schematics/001发采购/LY-4X6.0-V1.0(ESP32)/BOM--LY-4X6.0-V2.0(ESP32).xlsx

序号 | 元器件 | 位号 | 封装 | 用量
1 | 10nf(103)/50V | C1,C4,C11,C14,C15 | 0603C | 5
2 | 100uF/35V | C2,C12,C13 | 电解电容贴片6X6 | 3
3 | 100nf(104)/50V | C3,C6,C10,C16,C17,C18,C20,C21,C22,C23,C24,C25,C29,C30 | 0603C | 14
4 | 100uF/10V | C7 | SMD_BD5.0-L5.3-W5.3 | 1
5 | 4.7uF/35V | C8,C9,C5 | C1206 | 3
6 | 33pF/50V | C26,C28 | 0603C | 2
7 | SS56 | D1,D2 | SMA | 2
8 | 绿光 | D3,D5,D7 | 0603LED | 3
9 | PESD5V0L1BA | D4 | SOD-323 | 1
10 | PESD3V3L1BA | D6 | SOD-323 | 1
11 | 2.54单排母座8P | H1,H2 | HDR-TH_8P-P2.54 | 2
12 | 功率电感68uH | L1 | IND-SMD_L7.0-W7.0 | 1
13 | WJ2EDGVC-5.08-2P | P1 | 插件WJ2EDGVC-5.08-2P | 1
14 | XH2.54-3P | P2,P3,P4,P10,P16,P17 | 插件HDR1X3_CON | 6
15 | XH2.54-2P | P5,P12,P13 | 插件HDR1X2_CON | 3
16 | XH2.54-4P | P7,P8,P9,P11,P14,P15,P19 | 插件HDR1X4_CON | 7
17 | KF2510-3P | P6 | KF2510-3P(2.54端子) | 1 | https://item.taobao.com/item.htm?abbucket=19&id=659897836154&skuId=4761354676012
18 | USB-D口母座立式 | P18 | 插件USB-B-TH_USB | 1
19 | SS8050 | Q2,Q3 | SOT-23-3_L2.9-W1.3 | 2
21 | 100Ω | R2,R5,R9,R21,R22 | 0603R | 5
22 | 47K | R3 | 0603R | 1
23 | 10K | R1,R4,R8,R6,R7,R10,R15,R18,R19,R23,R24,R25,R27,R29,R30,R35,R36,R43,R20,R37,R38,R41,R42 | 0603R | 23
24 | 2K | R11,R12,R13,R14 | 0603R | 4
27 | 470Ω | R33,R34 | 0603R | 2
29 | XL1509-5.0E1 | U1 | ESOP-8_L4.9-W3.9-P1.27-LS6.0-BL-EP | 1
30 | 1117-3.3 | U2 | SOT-223 | 1
31 | CA-IS3760 | U4 | SOIC-16 | 1
32 | 74LVC1G17 | U6,U8,U10,U11,U13 | SOT-23-5 | 5
33 | ESP32-WROOM-32UE-N8 | U7 | WIFI-SMD_ESP32-WROOM | 1
34 | 74LVC1G04 | U5 | SOT-23-5 | 1
35 | CH340G | U14 | SOIC-16_L9.9-W3.9-P1.27-LS6.0-BL | 1
36 | 自弹TF卡座TFAA | U15 | SIM-SMD | 1
37 | USBLC2-2SC6 | U16 | SOT-23-6 | 1
38 | 12M | Y1 | 晶振贴片49SSMD | 1
39 | 2.54排针2P | H6,H7 | 2Pin-P2.54 | 2
40 | 跳线帽 | 插在H7上面 | 2.54跳线帽 | 1
