gqkhao/pcb-schematics/2Axis-5.0-南塘/上传/BOM和Gerber制板文件（采购用LY-2X5.0-V1.1）/BOM__2轴5.0.xlsx

No. | 数量 | Comment | 位号 | Footprint | Name
1 | 22 | 104 | C1,C2,C6,C7,C9,C11,C12,C13,C18,C22,C23,C24,C25,C26,C32,C33,C34,C35,C36,C37,C38,C39 | 0603C | 104
2 | 2 | 100uF/35V | C3,C4 | 电解电容贴片6X6 | 100uF/35V
4 | 2 | 33pF | C8,C10 | 0603C | 33pF
5 | 9 | 4.7uF | C5,C14,C15,C19,C21,C27,C28,C29,C30 | C1206 | 10uF
6 | 2 | 22pF | C16,C17 | 0603C | 22pF
7 | 1 | 100uF/10V | C20 | CAP-SMD_BD5.0-L5.3-W5.3-RD | 100uF/10V
8 | 1 | 103 | C31 | 0603C | 103
9 | 2 | 224 | C40,C41 | 0603C | 224
10 | 2 | SS34 | D1,D5 | SMA | SS34
11 | 1 | SS56 | D2 | SMA | SS56
12 | 1 | PESD3V3L1BA-N | D3 | SOD-323_L1.8-W1.3-LS2.5-BI | PESD3V3L1BA-N
13 | 2 | 绿光 | D4,D7 | 0603LED | 绿光
14 | 1 | PESD5V0L1BA-N | D6 | SOD-323_L1.8-W1.3-LS2.5-BI | PESD5V0L1BA-N
15 | 1 | SMBJ28A | DZ1 | SMB | SMBJ28A
16 | 1 | 6V/0.75A | F1 | 1206R | 6V/0.75A或者接近的
18 | 1 | SW_6X6 | K1 | KEY-SMD_4P | 按键比较低的
19 | 1 | 68uH | L1 | IND-SMD_L7.0-W7.0_SMDRI74-330MT | 68uH
20 | 1 | TYPE-C 16PIN | P1 | USB-C-SMD_TYPE-C-6PIN-2MD-073 | TYPE-C 16PIN
21 | 1 | Header 4 | P2 | VH3.96-4P直插座 | Header 4
22 | 1 | 3P | P3 | HDR1X3_CON | 3P
23 | 1 | Header 5 | P4 | HDR1X5_CON | Header 5
25 | 2 | 4P | P6,P7 | HDR1X4_CON | 4P
26 | 1 | S8050 | Q1 | SOT-23 | S8050
27 | 14 | 10K | R1,R6,R9,R12,R13,R15,R17,R27,R34,R35,R38,R39,R40,R41 | 0603R | 10K
28 | 3 | 5.1K | R2,R36,R37 | 0603R | 5.1K
29 | 2 | 510Ω | R3,R4 | 0603R | 510Ω
30 | 1 | 2K | R5 | 0603R | 2K
31 | 3 | 10k | R7,R8,R11 | 0603R | 10k
32 | 2 | 100 | R10,R33 | 0603R | 100
33 | 2 | 100Ω | R14,R16 | 0603R | 100Ω
34 | 8 | 1.91K | R18,R19,R20,R21,R22,R25,R26,R30 | 1206R | 1.91K
35 | 4 | 0.1 | R23,R24,R28,R29 | 1206R | 0.1
36 | 2 | 30K | R31,R32 | 0603R | 30K
37 | 2 | 10K/NC | R42,R43 | 0603R | 10K/NC
38 | 1 | CH340G | U1 | SOP16 | CH340G
39 | 1 | 1117-3.3 | U2 | SOT-223 | 1117-3.3
40 | 1 | USBLC2-2SC6 | U3 | SOT-23-6 | USBLC2-2SC6
41 | 1 | 74LVC1G17 | U4 | SOT-23-5 | 74LVC1G17
42 | 1 | GD32F103CCT6 | U5 | LQFP48 | STM32F103C8T6/CBT6
43 | 1 | XL1509-5.0E1 | U6 | ESOP-8_L4.9-W3.9-P1.27-LS6.0-BL-EP | XL1509-5.0E1
44 | 2 | HR4988SQ | U7,U8 | QFN28 | HR4988SQ
45 | 1 | 12M | Y1 | 晶振贴片49SSMD | 12M
46 | 1 | 8M | Y2 | 晶振贴片 | 8M
