gqkhao/pcb-schematics/4040M/BOM_MCU+U盘__2026-06-11.xlsx

N | 位号 | 数量 | 规格 | 封装
1 | C1,C6,C10,C34 | 4 | 100uF/10V | CAP-SMD_BD5.0-L5.3-W5.3-RD
2 | C2,C7,C9,C17,C21,C22,C23,C24,C26,C28,C29,C33,C37,C40,C41,C42,C43,C44,C45,C46,C47,C48,C49 | 23 | 0.1uF | C0603
3 | C3,C4,C12 | 3 | 104 | C0603
4 | C5,C15,C16,C50,C51,C53 | 6 | 100uF/35V | 电解电容贴片6X6
5 | C8,C11 | 2 | 10uF | C1206
6 | C13,C20 | 2 | 100uF/63V | 电解电容贴片10x10
7 | C14 | 1 | 100nF | C0805
8 | C18 | 1 | 470nF | C1210
9 | C19 | 1 | 100nF | C0603
10 | C25,C27,C39,C54,C55 | 5 | 104 | 11
11 | C30,C31,C32,C35,C36,C38 | 6 | 33pF | C0603
12 | C52 | 1 | 100uF/35V | 电解电容贴片6X6
13 | CN1 | 1 | XH-3AW | CONN-TH_3P-P2.54_HCTL_XH-3AW
14 | D1,D22 | 2 | SMAJ28A | SMA_L4.4-W2.8-LS5.1-RD
15 | D2,D3,D6,D7,D8 | 5 | SS56 | SMA
16 | D4,D13,D16,D17,D20 | 5 | PESD5V0L1BA-N | SOD-323_L1.8-W1.3-LS2.5-BI
17 | D5 | 1 | SMAJ06A | SMA_L4.4-W2.8-LS5.1-RD
18 | D9 | 1 | SMBJ58CA | SMB_L4.6-W3.6-LS5.3-BI
19 | D10,D11 | 2 | RS5M-SMB | SMB_L4.3-W3.6-LS5.3-RD
20 | D12 | 1 | SMBJ12A | SMB_L4.6-W3.6-LS5.3-RD
21 | D14 | 1 | SMBJ15A | SMA_L4.4-W2.8-LS5.1-RD
22 | D15 | 1 | 1N4148 | SOD-323_L1.8-W1.3-LS2.5-RD
23 | D18,D19 | 2 | USBLC6-2SC6 | SOT-23-6_L2.9-W1.6-P0.95-LS2.8-BL
24 | D21 | 1 | 绿光 | 0603LED
25 | DC1 | 1 | DC007B-2.5 | DC-IN-TH_HX-DC007B-2.5
26 | H1 | 1 | PZ254V-11-02P | HDR-TH_2P-P2.54-V-M
27 | H2 | 1 | PZ254 | HDR-TH_4P-P2.54-V-M
28 | H3,H4,H5,H6,H7,H8,H9,H10 | 8 | PZ254V-11-08P | HDR-TH_8P-P2.54-V-M
29 | L1 | 1 | 68uH功率电感 | SMD_L7.0-W7.0
30 | LED1,LED2,LED3 | 3 | 绿光 | LED0603-RD
31 | P1,P2 | 2 | 插件XHD2.54--2Pin | 插件XHD2.54--2Pin
32 | P3 | 1 | 5.08-04P | CONN-TH_4P-P5.08_WJ2EDGVC-5.08-4P
33 | P4,P5,P6,P7,P9,P10,P11 | 7 | 插件XHD2.54--3Pin | 插件XHD2.54--3Pin
34 | P8,P14 | 2 | 5.08-2P | CONN-TH_KF2EDG15R-5.08-2P
35 | P12 | 1 | 2P | HDR1X2_CON
36 | P13 | 1 | SS12D10G5-WJ | SW-TH_3P-SS12D06-1
37 | P15 | 1 | USB-B10-BRW | USB-B-TH_USB-B10-BRW
38 | P16,P17,P18,P19 | 4 | 4P | HDR1X4_CON
39 | Q1 | 1 | VBL1104N | TO-263-2_L10.2-W8.5-P2.54-LS15.2-TL
40 | R1 | 1 | 47kΩ | R0603
41 | R2,R3,R10,R11 | 4 | 10kΩ | R0603
42 | R4 | 1 | 470Ω | R1210
43 | R5,R15,R19,R42,R43,R47,R48,R49,R57,R58,R61,R63 | 12 | 0Ω | R0603
44 | R6 | 1 | 750Ω | R0805
45 | R7,R8 | 2 | 1kΩ | R0603
46 | R9 | 1 | 100Ω | R0805
47 | R12,R16,R25 | 3 | 5.1K | R0603
48 | R13,R17,R26 | 3 | 220Ω | R0603
49 | R14,R45 | 2 | 120Ω | R0603
50 | R18,R22 | 2 | 0Ω | R0603
51 | R20,R27,R29,R36,R38 | 5 | 220Ω | 0603R
52 | R21,R28,R30,R37,R39 | 5 | 10K | 0603R
53 | R23 | 1 | 10Ω | R0603
54 | R24,R44,R46,R55,R59,R60,R62,R80,R81 | 9 | 10K | R0603
55 | R31 | 1 | 47K | 10
56 | R32,R34 | 2 | 5.1K | R0603
57 | R33,R35 | 2 | 220Ω | R0603
58 | R40,R41 | 2 | 510Ω | R0603
59 | R50 | 1 | 10K | R0603
60 | R52,R53,R54,R56 | 4 | 10K | 10
61 | R64,R65,R66,R67,R68,R69,R70,R71,R72,R73,R74,R75 | 12 | 10K | R0603
62 | R76,R77,R78,R79 | 4 | 10K | R0603
63 | U1 | 1 | 1117-3.3 | SOT-223
64 | U2,U4 | 2 | B0505LS-1WR3 | 插件PWRM-TH_BXXXXLS
65 | U3 | 1 | XL1509-5.0E1 | ESOP-8_L4.9-W3.9-P1.27-LS6.0-BL-EP
66 | U5 | 1 | B0512LS-1WR3 | PWRM-TH_BXXXXLS-1WR3
67 | U6 | 1 | 78M12 | TO-252-2_L6.6-W6.1-P4.57-LS9.9-BR-CW
68 | U7,U9,U10,U11,U14,U15,U16,U17,U18,U19,U21,U22,U26 | 13 | LTV-357T-C | SOP-4_L4.4-W3.9-P2.54-LS7.0-TL
69 | U8 | 1 | UCC27517DBVR(UMW) | SOT-23-5_L3.0-W1.7-P0.95-LS2.8-BR
70 | U12 | 1 | GP8101C-SH | SOIC-8_L4.9-W3.9-P1.27-LS6.0-BL
71 | U13 | 1 | 74LVC1G04 | SOT-23-5
72 | U20 | 1 | XDJK-0051-025 | DC-IN-TH_XDJK-0051-025
73 | U23 | 1 | CH340G | SOIC-16_L9.9-W3.9-P1.27-LS6.0-BL
74 | U24 | 1 | CA-IS3760 | SOIC-16_L9.9-W3.9-P1.27-LS6.0-BL
75 | U27 | 1 | GD32F303CCT6 | LQFP48
76 | U28 | 1 | 自弹TF卡座TFAA | SIM-SMD_C9900015645
77 | U29 | 1 | SP3232EEN-L/TR | SOIC-16_L9.9-W3.9-P1.27-LS6.0-BL
78 | U30 | 1 | CH376T | SSOP-20_L7.5-W5.2-P0.65-LS8.0-BL
79 | USB1 | 1 | MC-107SSY | USB-TYPE-C-SMD_MC-107SSY
80 | USB2 | 1 | U-USBAR04P-F002 | USB-A-TH_USB-302-T
81 | Y1,Y2 | 2 | 12M | 晶振贴片49SSMD
82 | Y3 | 1 | 8M | 晶振贴片
