gqkhao/pcb-schematics/4040M/BOM_MCU+U盘__2026-05-27.xlsx

No. | 数量 | Comment | Designator | Footprint | Value | Manufacturer Part | Manufacturer | Supplier Part | Supplier
1 | 4 | 100uF/10V | C1,C3,C11,C23 | CAP-SMD_BD5.0-L5.3-W5.3-RD | 100uF/10V | CS1A101M-CRD54 | ST(先科) |  | LCSC
2 | 15 | 0.1uF | C2,C15,C17,C18,C19,C20,C28,C29,C30,C31,C32,C33,C35,C36,C38 | C0603 | 0.1uF | 0603B682K500NT | FH(风华) |  | LCSC
3 | 7 | 100uF/35V | C6,C12,C14,C16,C27,C39,C40 | 电解电容贴片6X6
4 | 2 | 0.1uF | C7,C10 | C0603 | 0.1uF | 0603B822K500NT | FH(风华) |  | LCSC
5 | 6 | 33pF | C8,C9,C21,C24,C34,C37 | C0603 | 33pF | CL10C120JB8NNNC | SAMSUNG(三星) |  | LCSC
6 | 3 | 104 | C13,C22,C26 | 0603C | 104
7 | 1 | 100uF/35V(47uF/50V) | C25 | 电解电容贴片6X6
8 | 1 | XH-3AW | CN1 | CONN-TH_3P-P2.54_HCTL_XH-3AW |  | XH-3AW | HCTL(华灿天禄) | C2908612 | LCSC
9 | 4 | SS56 | D1,D2,D5,D7 | SMA
10 | 5 | 1N4148 | D3,D4,D8,D14,D15 | SOD-323_L1.8-W1.3-LS2.5-RD |  | 1N4148 | CJ(江苏长电/长晶) | C2128 | LCSC
11 | 4 | PESD5V0L1BA-N | D6,D10,D11,D16 | SOD-323_L1.8-W1.3-LS2.5-BI |  | PESD5V0L1BA-N | BORN伯恩半导体 | C314264 | LCSC
12 | 1 | 绿光 | D9 | 0603LED
13 | 2 | USBLC6-2SC6 | D12,D13 | SOT-23-6_L2.9-W1.6-P0.95-LS2.8-BL |  | USBLC6-2SC6 | UMW(友台半导体) | C2687116 | LCSC
14 | 1 | SMAJ26A | D17 | SMA_L4.4-W2.8-LS5.1-RD |  | SMAJ26A | JJW(捷捷微) | C356747 | LCSC
15 | 16 | SMBJ30A | D18,D19,D20,D21,D22,D23,D24,D25,D26,D27,D28,D29,D30,D31,D32,D33 | SMB_L4.6-W3.6-LS5.3-RD |  | SMBJ30A | GOOD-ARK(固锝) | C266337 | LCSC
16 | 1 | DC007B-2.5 | DC1 | DC-IN-TH_HX-DC007B-2.5 |  | DC007B-2.5 | SHOU HAN(首韩) | C17701685 | LCSC
17 | 1 | PZ254 | H1 | HDR-TH_4P-P2.54-V-M |  | PZ254 | XFCN(兴飞) | C2691448 | LCSC
18 | 2 | PZ254V-11-02P | H2,H5 | HDR-TH_2P-P2.54-V-M |  | PZ254V-11-02P | XFCN(兴飞) | C492401 | LCSC
19 | 8 | PZ254V-11-08P | H3,H4,H6,H7,H8,H9,H10,H11 | HDR-TH_8P-P2.54-V-M |  | PZ254V-11-08P | XFCN(兴飞) | C492407 | LCSC
20 | 1 | 68uH | L1 | IND-SMD_L7.0-W7.0_SMDRI74-330MT | 68uH | SMDRI74-330MT | SXN(顺翔诺) |  | LCSC
21 | 3 | 绿光 | LED1,LED2,LED3 | LED0603-RD |  | 绿光 | KENTO | C2286 | LCSC
22 | 6 | 3P | P1,P2,P3,P5,P6,P8 | HDR1X3_CON
23 | 2 | 5.08-2P | P4,P7 | CONN-TH_KF2EDG15R-5.08-2P |  | 5.08-2P | KEFA(科发) | C6393959 | LCSC
24 | 2 | XH2.54-2P | P9,P10 | CONN-TH_XH2.54-2P |  | XH2.54-2P |  | C9900016957 | LCSC
25 | 1 | 2P | P11 | HDR1X2_CON
26 | 4 | 4P | P12,P14,P15,P16 | HDR1X4_CON
27 | 1 | SS12D10G5-WJ | P13 | SW-TH_3P-SS12D06-1 |  | SS12D10G5-WJ | SHOU HAN(首韩) | C7431058 | LCSC
28 | 1 | USB-B10-BRW | P17 | USB-B-TH_USB-B10-BRW |  | USB-B10-BRW | XUNPU(讯普) | C720549 | LCSC
29 | 3 | 5.1K | R1,R5,R18 | R0603 | 47K | 0603WAF2402T5E | UNI-ROYAL(厚声) |  | LCSC
30 | 3 | 2K | R2,R6,R19 | R0603 | 4.7K | 0603WAF2402T5E | UNI-ROYAL(厚声) |  | LCSC
31 | 15 | 0Ω | R3,R4,R34,R35,R36,R37,R38,R39,R50,R56,R57,R60,R61,R62/NC,R63/NC | R0603 | 0Ω | 0603WAF2402T5E | UNI-ROYAL(厚声) |  | LCSC
32 | 2 | 10kΩ | R8,R15 | R0603 | 10kΩ | 0603WAF2402T5E | UNI-ROYAL(厚声) |  | LCSC
33 | 2 | 470Ω | R9,R17 | R0603 | 47K | 0603WAF2402T5E | UNI-ROYAL(厚声) |  | LCSC
34 | 1 | 20kΩ | R12 | R0603 | 20kΩ | 0603WAF2402T5E | UNI-ROYAL(厚声) |  | LCSC
35 | 1 | 47kΩ | R14 | R0603 | 47kΩ | 0603WAF2402T5E | UNI-ROYAL(厚声) |  | LCSC
36 | 8 | 10K | R16,R25,R26,R31,R32,R33,R51,R58 | R0603 | 10K | 0603WAF2402T5E | UNI-ROYAL(厚声) |  | LCSC
37 | 2 | 470Ω | R21,R23 | R0603 | 470Ω | 0603WAF2402T5E | UNI-ROYAL(厚声) |  | LCSC
38 | 2 | 5.1K | R22,R24 | R0603 | 10K | 0603WAF2402T5E | UNI-ROYAL(厚声) |  | LCSC
39 | 16 | 2k | R27,R28,R29,R30,R40,R41,R42,R43,R45,R46,R47,R48,R52,R53,R54,R55 | R0603 | 2k | 0603WAF2402T5E | UNI-ROYAL(厚声) |  | LCSC
40 | 2 | 10K | R44,R49 | 0603R
41 | 1 | 47K | R59 | 10
42 | 1 | 1117-3.3 | U1 | SOT-223
43 | 7 | LTV-357T-C | U3,U4,U6,U8,U9,U12,U13 | SOP-4_L4.4-W3.9-P2.54-LS7.0-TL |  | LTV-357T-C | LITEON(光宝) | C119091 | LCSC
44 | 1 | XL1509-5.0E1 | U5 | ESOP-8_L4.9-W3.9-P1.27-LS6.0-BL-EP |  | XL1509-5.0E1 | XLSEMI(芯龙) | C61063 | LCSC
45 | 1 | GD32F303CCT6 | U10 | LQFP48
46 | 3 | 74LVC1G17 | U11,U18,U19 | SOT-23-5
47 | 1 | XDJK-0051-025 | U14 | DC-IN-TH_XDJK-0051-025 |  | XDJK-0051-025 | LX(连欣科技) | C7498153 | LCSC
48 | 1 | CA-IS3760 | U15 | SOIC-16_L9.9-W3.9-P1.27-LS6.0-BL |  | CA-IS3760 | Chipanalog(川土微) | C19723481 | LCSC
49 | 1 | CH376S | U16 | SOIC-28_L17.9-W7.5-P1.27-LS10.3-BL |  | CH376S | WCH(南京沁恒) | C14166 | LCSC
50 | 1 | CH340G | U20 | SOIC-16_L9.9-W3.9-P1.27-LS6.0-BL |  | CH340G | WCH(南京沁恒) | C14267 | LCSC
51 | 1 | SP3232EEN-L/TR | U21 | SOIC-16_L9.9-W3.9-P1.27-LS6.0-BL |  | SP3232EEN-L/TR | MaxLinear(迈凌) | C9378 | LCSC
52 | 1 | 74LVC1G17 | U22 | SOT-23-5 |  | 74LVC1G17 | TECH PUBLIC(台舟) | C52098145 | LCSC
53 | 1 | B2412S-1WR3 | U23 | PWRM-TH_YLPTEC_BXXXXS-1WR3 |  | B2412S-1WR3 | EVISUN(易成) | C7500911 | LCSC
54 | 1 | GP8101C-SH | U24 | SOIC-8_L4.9-W3.9-P1.27-LS6.0-BL |  | GP8101C-SH | Guestgood(客益) | C49253868 | LCSC
55 | 1 | U-USBAR04P-F002 | USB1 | USB-A-TH_USB-302-T |  | U-USBAR04P-F002 | Ckmtw(灿科盟) | C386736 | LCSC
56 | 1 | TYPE-C 16PIN | USB2 | USB-C-SMD_TYPE-C-6PIN+ |  | TYPE-C 16PIN | SHOU HAN(首韩) | C2765186 | LCSC
57 | 1 | 8M | Y1 | 晶振贴片
58 | 2 | 12M | Y2,Y3 | 晶振贴片49SSMD
