gqkhao/pcb-schematics/3020-2.0包裹款/BOM_esp32_包裹款_2026-05-25.xlsx

序号 | 名称规格 | 数量 | 位号 | 封装 | Value | Manufacturer Part | Manufacturer | Supplier Part | Supplier
1 | 100uF/35V | 6 | C1,C2,C12,C18,C28,C32 | 贴片电解电容6*6
2 | 104 | 18 | C3,C4,C7,C8,C10,C14,C20,C21,C27,C29,C30,C31,C33,C34,C38,C39,C40,C46 | 0603C | 104
3 | 10uF | 7 | C5,C6,C9,C11,C16,C53,C54 | 1206C
4 | 4.7uF | 1 | C13 | 1206C
5 | 100uF/10V | 6 | C15,C17,C19,C26,C35,C37 | SMD_BD5.0-L5.3-W5.3 | 100uF/10V | CS1A101M-CRD54 | ST(先科) |  | LCSC
6 | 104 | 4 | C22,C23,C24,C25 | 0603C | 103
7 | 100uF/35V(47uF/50V) | 1 | C36 | 电解电容贴片6X6
8 | 104 | 1 | C41 | 11 | 104
9 | 104 | 6 | C42,C43,C44,C45,C47,C49 | 0603C
10 | 33pF | 2 | C48,C50 | 0603C | 18pF
11 | 104 | 1 | C51 | 0603C | 18pF
12 | 22pF | 2 | C52,C56 | 0603C | 18pF
13 | 103 | 1 | C55 | 11
14 | XHD-8P | 3 | CN1,CN2,CN3 | CONN-TH_8P-P2.50_HCTL_HC-XHD-8P |  | XHD-8P | HCTL(华灿天禄) | C5196922 | LCSC
15 | SS56 | 5 | D1,D3,D4,D5,D15 | SMA
16 | SMAJ28CA | 15 | D2,D16,D17,D19,D20,D21,D22,D23,D24,D26,D27,D28,D29,D31,D33 | SMA_L4.5-W2.6-LS5.1-BI |  | SMAJ28CA | TECH PUBLIC(台舟) | C41425622 | LCSC
17 | SS34 | 2 | D6,D7 | SMA
18 | 绿光 | 4 | D8,D10,D13,D14 | 0603LED
19 | 稳压管12V | 1 | D9 | SOD-123_L2.7-W1.6-LS3.8-RD |  | 稳压管12V |  | C9900022347 | LCSC
20 | SMAJ6.0CA | 2 | D11,D12 | SMA_L4.5-W2.6-LS5.1-BI |  | SMAJ6.0CA | TECH PUBLIC(台舟) | C41425622 | LCSC
21 | PESD3V3L1BA-N | 1 | D18 | SOD-323_L1.8-W1.3-LS2.5-BI |  | PESD3V3L1BA-N | BORN伯恩半导体 | C314264 | LCSC
22 | PESD5V0L1BA-N | 2 | D25,D32 | SOD-323_L1.8-W1.3-LS2.5-BI |  | PESD5V0L1BA-N | BORN伯恩半导体 | C314264 | LCSC
23 | SMAJ9.0CA | 2 | D30,D34 | SMA_L4.5-W2.6-LS5.1-BI |  | SMAJ9.0CA | TECH PUBLIC(台舟) | C41425622 | LCSC
24 | 1N4148WS | 1 | D35 | SOD-323_L1.8-W1.3-LS2.5-RD |  | 1N4148WS | CJ(江苏长电/长晶) | C2128 | LCSC
25 | 1N4148 | 4 | D36,D37,D38,D39 | SOD-323_L1.8-W1.3-LS2.5-RD |  | 1N4148 | CJ(江苏长电/长晶) | C2128 | LCSC
26 | USBLC6-2SC6 | 1 | D40 | SOT-23-6_L2.9-W1.6-P0.95-LS2.8-BL |  | USBLC6-2SC6 | UMW(友台半导体) | C2687116 | LCSC
27 | PZ254V-11-02P | 3 | H1,H6,H9 | HDR-TH_2P-P2.54-V-M |  | PZ254V-11-02P | XFCN(兴飞) | C492401 | LCSC
28 | PZ254V-11-08P | 6 | H2,H3,H4,H5,H7,H8 | HDR-TH_8P-P2.54-V-M |  | PZ254V-11-08P | XFCN(兴飞) | C492407 | LCSC
29 | TS-1088 | 1 | K1 | SW-SMD_L3.9-W3.0-P4.45 |  | TS-1088 | XUNPU(讯普) | C720477 | LCSC
30 | 68uH | 2 | L1,L2 | IND-SMD_L7.0-W7.0_SMDRI74-330MT | 68uH | SMDRI74-330MT | SXN(顺翔诺) |  | LCSC
31 | 2P | 15 | P1,P2,P3,P5,P6,P7,P8,P13,P20,P21,P22,P23,P27,P30,P36 | HDR1X2_CON
32 | KF2EDGVC-5.08-2P | 3 | P4,P37,P41 | CONN-TH_P5.08_KF2EDGVC-5.08-2P |  | KF2EDGVC-5.08-2P | KEFA(科发) | C441386 | LCSC
33 | 3P | 17 | P9,P10,P11,P12,P14,P15,P16,P17,P18,P19,P24,P25,P32,P34,P38,P39,P40 | HDR1X3_CON
34 | XHD2.54--4Pin | 2 | P26,P28 | HDR1X4_CON
35 | 4P | 4 | P29,P31,P33,P42 | HDR1X4_CON
36 | PZ254V-11-03P | 1 | P35 | HDR-TH_3P-P2.54-V-M |  | PZ254V-11-03P | XFCN(兴飞) | C492402 | LCSC
37 | USB-B12-(立式) | 1 | P43 | USB-B-TH_USB-B12-BRW |  | USB-B12-(立式) | XUNPU(讯普) | C720550 | LCSC
38 | F540NS | 1 | Q1 | TO-263-2
39 | AO3401 | 2 | Q2,Q3 | SOT-23 |  | AO3401 | TWGMC(̨--ϼ-) | C727156 | LCSC
40 | SS8050 | 2 | Q4,Q5 | SOT-23
41 | SS8050 | 2 | Q6,Q7 | SOT-23-3_L2.9-W1.3-P1.90-LS2.4-BR |  | SS8050 | Doeshare(德芯) | C2931717 | LCSC
42 | 47K | 1 | R1 | 0603R
43 | 10K | 27 | R2,R5,R6,R9,R12,R13,R14,R16,R20,R22,R24,R26,R32,R33,R34,R35,R36,R38,R40,R41,R50,R64,R68,R71,R74,R76,R83 | 0603R | 10K
44 | 1K | 7 | R3,R15,R17,R37,R39,R63,R70 | 0603R
45 | 220Ω | 6 | R4,R21,R23,R25,R27,R42 | 0603R
46 | 47K | 1 | R7 | 0603R | 10K
47 | 1K | 1 | R8 | 0603R | 10K
48 | 0Ω | 7 | R10,R44,R47,R61,R75,R79,R81 | 0603R
49 | 100Ω | 1 | R11 | 0603R | 10K
50 | RT0603BRD0710KL | 2 | R18,R19 | R0603 | 10K | RT0603BRD0710KL | YAGEO(----) |  | LCSC
51 | RT0603BRD0710KL | 2 | R28,R29 | R0603 | 2K | RT0603BRD0710KL | YAGEO(----) |  | LCSC
52 | 10K | 2 | R30,R31 | 0603R
53 | 10K | 1 | R43 | R0603 |  | 0603WAF1002T5E | UniOhm | C25804 | LCSC
54 | 4.7K | 13 | R45,R46,R48,R49,R51,R52,R53,R54,R56,R57,R58,R59,R66 | 0603R | 10K
55 | 100 | 1 | R55 | 0603R
56 | RT0603BRD0710KL | 2 | R60,R62 | R0603 | 0Ω | RT0603BRD0710KL | YAGEO(----) |  | LCSC
57 | 10K | 5 | R65,R67,R69,R72,R73 | 10
58 | 5.1K | 4 | R77,R78,R80,R82 | 0603R | 10K
59 | 1117-3.3 | 3 | U1,U2,U3 | SOT-223
60 | LTV-357T-C | 13 | U4,U7,U8,U10,U11,U12,U13,U14,U17,U18,U19,U26,U29 | SOP-4_L4.4-W3.9-P2.54-LS7.0-TL |  | LTV-357T-C | LITEON(光宝) | C119091 | LCSC
61 | XL1509-5.0E1//SXL1509-5.0E1 | 1 | U5 | ESOP-8_L4.9-W3.9-P1.27-LS6.0-BL-EP |  | XL1509-5.0E1//SXL1509-5.0E1 | XLSEMI(芯龙) | C61063 | LCSC
62 | XL1509-5.0E1 | 1 | U6 | ESOP-8_L4.9-W3.9-P1.27-LS6.0-BL-EP |  | XL1509-5.0E1 | XLSEMI(芯龙) | C61063 | LCSC
63 | CJ7805 | 1 | U9 | TO-263-2_L10.1-W9.1-P5.08-LS15.2-TL |  | CJ7805 | CJ(江苏长电/长晶) | C145151 | LCSC
64 | 74HC165D(LX) | 1 | U15 | SOIC-16_L9.9-W3.9-P1.27-LS6.0-BL-1 |  | 74HC165D(LX) | LX(灵星芯微) | C52711170 | LCSC
65 | 74AHCT595T16-13 | 3 | U16,U20,U22 | TSSOP-16_L5.0-W4.4-P0.65-LS6.4-BL |  | 74AHCT595T16-13 | DIODES(美台) | C460504 | LCSC
66 | ESP32-WROOM-32 | 1 | U21 | WIFI-SMD_ESP32-WROOM-32UE-A |  | ESP32-WROOM-32 | ESPRESSIF(乐鑫) | C95209 | LCSC
67 | 74LVC1G17 | 2 | U23,U25 | SOT-23-5
68 | TC1508A | 1 | U24 | SOP-16_L10.0-W3.9-P1.27-LS6.0-BL |  | TC1508A | FM(富满) | C5142992 | LCSC
69 | 自弹TF卡座TFAA | 1 | U27 | SIM-SMD_C9900015645 |  | 自弹TF卡座TFAA |  | C9900015645 | LCSC
70 | ACS712ELCTR-20A-T | 1 | U28 | SOIC-8_L4.9-W3.9-P1.27-LS6.0-BL |  | ACS712ELCTR-20A-T | ALLEGRO(美国埃戈罗) | C10681 | LCSC
71 | CH340G | 1 | U30 | SOIC-16_L9.9-W3.9-P1.27-LS6.0-BL |  | CH340G | WCH(南京沁恒) | C14267 | LCSC
72 | SP3232EEN-L/TR | 1 | U31 | SOIC-16_L9.9-W3.9-P1.27-LS6.0-BL |  | SP3232EEN-L/TR | MaxLinear(迈凌) | C9378 | LCSC
73 | SL2.1A | 1 | U32 | SOP-16_L10.0-W3.9-P1.27-LS6.0-BL |  | SL2.1A | CoreChips(和芯润德) | C192893 | LCSC
74 | U-USBAS04P-F001 | 1 | USB1 | USB-A-TH_USB-M-22 |  | U-USBAS04P-F001 | Ckmtw(灿科盟) | C386737 | LCSC
75 | 12M | 2 | Y1,Y2 | 晶振贴片49SSMD
