gqkhao/pcb-schematics/3020-2.0包裹款/BOM_esp32-包裹款控制板_2026-06-06.xlsx

序号 | 位号 | 数量 | 规格 | 封装 | 备注
1 | C1,C2,C12,C18,C28,C32,C57,C36 | 8 | 100uF/35V | 贴片电解电容6x6
2 | C3,C4,C7,C8,C10,C14,C20,C21,C27,C29,C30,C31,C33,C34,C38,C39,C40,C46,C22,C23,C24,C25,C41,C42,C43,C44,C45,C47,C49,C55,C51 | 30 | 0.1uF | 0603C
3 | C5,C6,C9,C11,C16,C53,C54 | 7 | 10uF | C1206
4 | C13 | 1 | 4.7uF | C1206
5 | C15,C17,C19,C26,C35,C37 | 6 | 100uF/10V | 贴片电解电容5x5
6 | C48,C50,C52,C56 | 4 | 22pF | 0603C
7 | CN1,CN2,CN3 | 3 | 插件XHD-8P-2.54 | 插件XHD-8P-2.54
8 | D1,D3,D4,D5,D15，D6,D7 | 5 | SS56 | SMA
9 | D2,D17,D19,D20,D21,D22,D23,D24,D26,D27,D28,D29,D31,D33 | 14 | SMAJ28CA | SMA_L4.5-W2.6
10 | D8,D10,D13,D14,D42 | 5 | 绿光 | 0603LED
11 | D9,D41 | 2 | 稳压管12V或者9V | SOD-123
12 | D11,D12 | 2 | SMAJ6.0CA | SMA_L4.5-W2.6
13 | D18 | 1 | PESD3V3L1BA-N | SOD-323
14 | D25,D32 | 2 | PESD5V0L1BA-N | SOD-323
15 | D30,D34 | 2 | SMAJ9.0CA | SMA_L4.5-W2.6-LS5.1-BI
16 | D36,D37,D38,D39，D35 | 5 | 1N4148 | SOD-323_L1.8-W1.3-LS2.5-RD
17 | D40 | 1 | USBLC6-2SC6 | SOT-23-6_L2.9-W1.6-P0.95-LS2.8-BL
18 | L1,L2 | 2 | 68uH贴片功率电感 | SMD_L7.0-W7.0
19 | Q1,Q8 | 2 | F540NS或者类似的MOS管 | TO-263-2
20 | Q2,Q3 | 2 | AO3401 | SOT-23
21 | Q4,Q5，Q6,Q7 | 4 | SS8050 | SOT-23
22 | R1 | 1 | 47K | 0603R
23 | R2,R5,R6,R9,R12,R13,R14,R16,R20,R22,R24,R26,R32,R33,R34,R35,R36,R38,R40,R41,R50,R64,R68,R71,R74,R76,R83,R85,R87,R90,R7,R30,R31,R43,R65,R67,R69,R72,R73,R18,R19 | 41 | 10K | 0603R
24 | R3,R15,R17,R37,R39,R63,R70,R8,R86,R28,R29 | 9 | 1K | 0603R
25 | R4,R21,R23,R25,R27,R42,R84 | 7 | 220Ω | 0603R
26 | R10,R44,R47,R61,R75,R79,R81,R88,R60,R62 | 10 | 0Ω | 0603R
27 | R11,R89，R55 | 2 | 100Ω | 0603R
28 | R45,R46,R48,R49,R51,R52,R53,R54,R56,R57,R58,R59,R66,R77,R78,R80,R82 | 17 | 4.7K | 0603R
29 | U1,U2,U3 | 3 | 1117-3.3 | SOT-223
30 | U4,U7,U8,U10,U11,U12,U13,U14,U17,U18,U19,U26,U29,U33 | 14 | LTV-357T | SOP-4_L4.4-W3.9
31 | U5，U6 | 2 | XL1509-5.0E1 | ESOP-8_L4.9-W3.9
32 | U9 | 1 | CJ7805 | TO-263-2
33 | U15 | 1 | 74HC165D | SOIC-16_L9.9-W3.9-P1.27-LS6.0-BL-1 | 新物料参考 https://item.szlcsc.com/23931794.html
34 | U16,U20,U22 | 3 | 74AHCT595T16 | TSSOP-16 | 新物料
35 | U21 | 1 | ESP32-WROOM-32 | WIFI-SMD_ESP32
36 | U23,U25 | 2 | 74LVC1G17 | SOT-23-5
37 | U24 | 1 | TC1508A | SOP-16 | 新物料
38 | U27 | 1 | 自弹TF卡座TFAA | SIM-SMD_C9900015645
39 | U30 | 1 | CH340G | SOIC-16_L9.9-W3.9-P1.27-LS6.0-BL
40 | U31 | 1 | SP3232EEN | SOIC-16 | 新物料通用RS232芯片
41 | U32 | 1 | SL2.1A | SOP-16_L10.0-W3.9-P1.27-LS6.0-BL | 新物料
42 | Y1,Y2 | 2 | 12M晶振 | 晶振贴片49SSMD
43 | USB1 | 1 | 插件USB-AS04P-F001(立式USB母座) | USB-A-TH_USB-M-22 | 插件物料
44 | H2,H3,H4,H5,H7,H8 | 6 | 插件2.54单排母座8P | HDR-TH_8P-P2.54
45 | P1,P2,P3,P5,P6,P7,P8,P13,P20,P21,P22,P23,P27,P30,P36,P44 | 16 | 插件XHD2.54--2Pin | 插件XHD-2P-2.54
46 | P4,P37,P41 | 3 | 插件KF2EDGVC-5.08-2P | KF2EDGVC-5.08-2P
47 | P9,P10,P11,P12,P14,P15,P16,P17,P18,P19,P24,P25,P32,P34,P38,P40 | 17 | 插件XHD2.54--3Pin | 插件XHD-3P-2.54
48 | P26,P28,P29,P31,P33,P42 | 6 | 插件XHD2.54--4Pin | 插件XHD2.54--4Pin
49 | P35,P39 | 1 | 插件2.54单排母座3P | 插件2.54单排母座3P
50 | P43 | 1 | 插件USB-B12-(立式USB母座D型口) | USB-B-TH_USB-B12-BRW
