gqkhao/pcb-schematics/FluidNC/BOM_主控板_2025-11-11.xlsx

No. | 数量 | Comment | Designator | Footprint
1 | 9 | 103 | C5,C8,C15,C18,C19,C22,C23,C24,C32 | 11
2 | 3 | 100uF/35V | C6,C11,C35 | 电解电容贴片6X6
3 | 16 | 104 | C7,C10,C14,C16,C20,C21,C25,C26,C27,C28,C29,C30,C31,C33,C34,C36 | 0603C
4 | 1 | 10uF | C9 | C1206
5 | 2 | 4.7uF | C12,C13 | C1206
6 | 2 | 33pF | C37,C38 | 0603C
7 | 1 | 104 | C39 | 11
8 | 1 | SS56 | D3 | SMA
9 | 1 | SS34 | D4 | SMA
10 | 3 | 绿光 | D5,D7,D9 | 0603LED
11 | 1 | PESD5V0L1BA-N | D6 | SOD-323_L1.8-W1.3-LS2.5-BI
12 | 1 | PESD3V3L1BA-N | D8 | SOD-323_L1.8-W1.3-LS2.5-BI
13 | 1 | 1N4148 | D11 | SOD-123_L2.8-W1.8-LS3.7-RD
14 | 1 | XDDB-1809-0816 | DB1 | DB9-TH_LD09P33E4GV00LF
15 | 3 | PZ254 | H1,H7,H8 | HDR-TH_2P-P2.54-V-M
16 | 3 | PZ254V-11-02P | H2,H3,H6 | HDR-TH_2P-P2.54-V-M
17 | 2 | PZ254 | H4,H5 | HDR-TH_4P-P2.54-V-M
18 | 1 | PZ254V-11-04P | H9 | HDR-TH_4P-P2.54-V-M
19 | 1 | SW_6X6_H=12.0MM | K1 | KEY-SMD_4P
21 | 1 | 68uH | L2 | IND-SMD_L7.0
22 | 1 | WJ2EDGR-5.08-2P | P1 | CONN-TH_WJ2EDGR
23 | 6 | 3P | P3,P4,P5,P13,P14,P17 | HDR1X3_CON
24 | 3 | 2P | P6,P8,P9 | HDR1X2_CON
25 | 5 | 4P | P10,P11,P12,P15,P16 | HDR1X4_CON
26 | 1 | USB-B10-BRW | P18 | USB-B-TH_USB-B10-BRW
27 | 3 | SS8050 | Q3,Q4,Q5 | SOT-23-3_L2.9-W1.3-P1.90-LS2.4-BR
28 | 3 | 22K | R4,R7,R11 | 10
29 | 3 | 100 | R5,R8,R12 | 10
30 | 1 | 47K | R6 | 0603R
31 | 15 | 10K | R9,R10,R15,R16,R17,R18,R21,R29,R36,R37,R42,R44,R46,R51,R57 | 0603R
32 | 5 | 22K | R13,R19,R30,R31,R38 | 0603R
33 | 3 | 0Ω | R14,R26,R48 | 0603R
34 | 6 | 100 | R20,R23,R32,R33,R34,R39 | 0603R
35 | 1 | 10kΩ | R28 | R0603
36 | 2 | 1K | R35,R47 | 0603R
37 | 8 | 510Ω | R40,R41,R43,R45,R49,R50,R54,R56 | 0603R
38 | 4 | 10K | R52,R53,R55,R58 | 10
39 | 1 | XL1509-5.0E1//SXL1509-5.0E1 | U2 | ESOP-8_L4.9-W3.9-P1.27-LS6.0-BL-EP
40 | 1 | 1117-3.3 | U3 | SOT-223
41 | 3 | 74LVC1G17 | U4,U11,U13 | SOT-23-5
42 | 3 | 74LVC1G04 | U5,U7,U14 | SOT-23-5
43 | 2 | 74AHCT595T16-13 | U6,U8 | TSSOP-16_L5.0-W4.4-P0.65-LS6.4-BL
44 | 1 | ESP32-WROOM-32 | U9 | WIFI-SMD_ESP32-WROOM-32UE-A
45 | 1 | LTV-357T-C | U10 | SOP-4_L4.4-W3.9-P2.54-LS7.0-TL
46 | 1 | SP3232EEN-L/TR | U12 | SOIC-16_L9.9-W3.9-P1.27-LS6.0-BL
47 | 1 | CH340G | U15 | SOIC-16_L9.9-W3.9-P1.27-LS6.0-BL
48 | 1 | 自弹TF卡座TFAA | U16 | SIM-SMD_C9900015645
49 | 1 | USBLC2-2SC6 | U17 | SOT-23-6
50 | 1 | 12M | Y1 | 晶振贴片49SSMD
