gqkhao/pcb-schematics/FluidNC/BOM_esp32_-01-08.xlsx

No. | 数量 | Comment | Designator | Footprint
1 | 5 | 100uF/35V | C1,C2,C13,C18,C51 | 电解电容贴片6X6
2 | 9 | 103 | C3,C5,C11,C14,C19,C20,C30,C31,C42 | 11
3 | 19 | 104 | C4,C10,C12,C15,C16,C17,C21,C23,C24,C25,C26,C27,C28,C29,C32,C33,C35,C45,C50 | 0603C
4 | 4 | 10uF | C6,C43,C44,C49 | C1206
5 | 3 | 100uF/10V | C7,C34,C52 | CAP-SMD_BD5.0-L5.3-W5.3-RD
6 | 2 | 4.7uF | C8,C9 | C1206
7 | 1 | 100uF/35V | C22 | 电解电容贴片6X6
8 | 4 | 33pF | C36,C37,C39,C40 | 0603C
9 | 1 | 104 | C38 | 11
10 | 2 | SS56 | D1,D27 | SMA
11 | 2 | SS34 | D2,D25 | SMA
12 | 4 | 绿光 | D3,D5,D14,D29 | 0603LED
13 | 9 | PESD5V0L1BA-N | D4,D6,D7,D8,D9,D10,D13,D26,D30 | SOD-323_L1.8-W1.3-LS2.5-BI
14 | 4 | 1N4148 | D11,D12,D16,D17 | SOD-123_L2.8-W1.8-LS3.7-RD
15 | 2 | USBLC6-2SC6 | D18,D22 | SOT-23-6_L2.9-W1.6-P0.95-LS2.8-BL
16 | 1 | PZ254 | H1 | HDR-TH_2P-P2.54-V-M
17 | 6 | PZ254V-11-08P | H2,H3,H4,H5,H7,H8 | HDR-TH_8P-P2.54-V-M
18 | 1 | PZ254V-11-02P | H6 | HDR-TH_2P-P2.54-V-M
19 | 1 | PZ254V-11-04P | H9 | HDR-TH_4P-P2.54-V-M
20 | 1 | SW_6X6_H=12.0MM | K1 | KEY-SMD_4P-L6.0-W6.0-P4.50-LS9.0
21 | 1 | TS-1088 | K2 | SW-SMD_L3.9-W3.0-P4.45
22 | 2 | 68uH | L1,L2 | IND-SMD_L7.0-W7.0_SMDRI74-330MT
23 | 1 | XHD2.54-2x6A | P1 | CONN-TH_12P-P2.50_HC-XHD2.54-2X6A
24 | 1 | XHD2.54-2*12 | P2 | IDC-TH_24P-P2.54-V-R2-C12-S2.54
25 | 6 | 2P | P3,P4,P11,P12,P17,P18 | HDR1X2_CON
26 | 1 | KF2EDGVC-5.08-2P | P5 | CONN-TH_P5.08_KF2EDGVC-5.08-2P
27 | 7 | 3P | P6,P7,P9,P13,P19,P20,P21 | HDR1X3_CON
28 | 6 | 4P | P8,P10,P14,P15,P16,P22 | HDR1X4_CON
29 | 1 | USB-B10-BRW | P24 | USB-B-TH_USB-B10-BRW
30 | 2 | SS8050 | Q1,Q2 | SOT-23-3_L2.9-W1.3-P1.90-LS2.4-BR
31 | 3 | 51K | R1,R5,R10 | 10
32 | 9 | 100 | R2,R3,R6,R7,R11,R12,R23,R44,R45 | 10
33 | 2 | 47K | R4,R34 | 0603R
34 | 13 | 10K | R8,R9,R13,R16,R25,R35,R49,R50,R52,R53,R59,R71,R73 | 0603R
35 | 3 | 22K | R14,R26,R51 | 0603R
36 | 4 | 51K | R15,R17,R40,R41 | 0603R
37 | 12 | 4.7K | R18,R19,R20,R22,R27,R30,R31,R32,R36,R37,R38,R39 | 0603R
38 | 6 | 100 | R21,R28,R29,R42,R43,R47 | 0603R
39 | 1 | 10kΩ | R24 | R0603
40 | 1 | 1K | R33 | 0603R
41 | 4 | 0Ω | R46,R48,R70,R75 | 0603R
42 | 4 | 10K | R54,R55,R57,R60 | 10
43 | 2 | 100Ω | R56,R58 | 0603R
44 | 1 | CJ7812 | U1 | TO-263-2_L10.1-W9.1-P5.08-LS15.2-TL
45 | 2 | XL1509-5.0E1 | U2,U19 | ESOP-8_L4.9-W3.9-P1.27-LS6.0-BL-EP
46 | 1 | 1117-3.3 | U3 | SOT-223
47 | 5 | 74LVC1G17 | U4,U7,U12,U13,U14 | SOT-23-5
48 | 2 | LTV-357T-C | U5,U10 | SOP-4_L4.4-W3.9-P2.54-LS7.0-TL
49 | 2 | 74AHCT595T16-13 | U6,U8 | TSSOP-16_L5.0-W4.4-P0.65-LS6.4-BL
50 | 1 | ESP32-WROOM-32 | U9 | WIFI-SMD_ESP32-WROOM-32UE-A
51 | 1 | SP3232EEN-L/TR | U11 | SOIC-16_L9.9-W3.9-P1.27-LS6.0-BL
52 | 1 | CH340G | U15 | SOIC-16_L9.9-W3.9-P1.27-LS6.0-BL
53 | 1 | 自弹TF卡座TFAA | U16 | SIM-SMD_C9900015645
54 | 1 | USBLC2-2SC6 | U17 | SOT-23-6
55 | 1 | SL2.1A | U18 | SOP-16_L10.0-W3.9-P1.27-LS6.0-BL
56 | 1 | U-USBAS04P-F001 | USB1 | USB-A-TH_USB-M-22
57 | 2 | 12M | Y1,Y2 | 晶振贴片49SSMD
