gqkhao/pcb-schematics/4轴5.0/BOM_导出不用物料.xlsx

No. | Quantity | Comment | Designator | Footprint | Name
1 | 4 | 100nF | C33,C34,C35,C36 | C0603 | 100nF
2 | 5 | 105 | C37,C39,C41,C43,C45 | 0805C | 105
3 | 5 | 47uF/50V | C38,C40,C42,C44,C46 | 电解电容贴片6x6 | 47uF/50V
4 | 10 | 104 | C47,C48,C49,C50,C51,C52,C53,C54,C55,C56 | C0603 | 104
5 | 5 | 224 | C57,C58,C59,C60,C61 | C0603 | 224
6 | 2 | -̹- | D8,D9 | 0603LED | -̹-
7 | 1 | SS56 | D10 | SMA | SS56
8 | 2 | --ָ-------RS2M | DZ1,DZ2 | SMC | --ָ-------RS2M
9 | 1 | --ѹ------SMAZ10V | DZ3 | SMA | --ѹ------SMAZ10V
10 | 1 | 2P | P17 | CONN-TH_2P-P5.00_DB2ER-5.0-2P-GN | 2P
11 | 1 | DB2ER-5.0-2P-GN | P18 | CONN-TH_2P-P5.00_DB2ER-5.0-2P-GN | DB2ER-5.0-2P-GN
12 | 5 | 4P | P23,P24,P25,P26,P27 | HDR1X4_CON | 4P
13 | 1 | Header 3X2 | P28 | HDR2X3 | Header 3X2
14 | 1 | F50N06 | Q1 | TO-252 | F50N06
15 | 1 | F540NS | Q2 | TO-263-2 | F540NS
16 | 1 | SS8050 | Q3 | SOT-23 | SS8050
17 | 12 | 10K | R30,R33,R35,R42,R65,R66,R67,R68,R69,R76,R77,R78 | 0603R | 10K
18 | 3 | 1K | R36,R37,R38 | 0603R | 1K
19 | 2 | 100 | R41,R75 | 0603R | 100
20 | 10 | 0.1 | R45,R46,R47,R48,R49,R50,R51,R52,R53,R54 | 0805R | 0.1
21 | 5 | 20K | R55,R56,R57,R58,R59 | 0603R | 20K
22 | 5 | 10K | R60,R61,R62,R63,R64 | 松下贴片电位器3x3 | 10K
23 | 5 | 0 | R70,R71,R72,R73,R74 | 0603R | 0
24 | 2 | 0R | R104,R105 | R1210 | 0R
25 | 2 | 10K | R106,R109 | R0603 | 10K
26 | 1 | 1K | R108 | R0603 | 1K
27 | 1 | 0R | R110 | R0603 | 0R
28 | 1 | SK12D07VG4 | SW2 | SW-TH_SK12D07VG4 | SK12D07VG4
29 | 1 | 74LVC1G04 | U15 | SOT-23-5 | 74LVC1G04
30 | 2 | CA-IS3720LS | U19,U20 | SOIC-8_L4.9-W3.9-P1.27-LS6.0-BL | CA-IS3720LS
31 | 5 | HR4988SQ | U21,U22,U23,U24,U25 | QFN28 | HR4988SQ
32 | 1 | LTV-357T-C | U31 | SOP-4_L4.4-W3.9-P2.54-LS7.0-TL | LTV-357T-C
