gqkhao/pcb-schematics/4轴5.0/BOM_4轴_2025-09-01.xlsx

No | 数量 | Comment | Designator | Footprint
1 | 22 | 104 | C1,C2,C12,C14,C15,C16,C17,C19,C24,C25,C26,C47,C48,C49,C50,C51,C52,C53,C54,C55,C56,C62 | C0603
2 | 7 | 105 | C4,C6,C37,C39,C41,C43,C45 | 0805C
3 | 6 | 100uF/35V | C5,C8,C11,C13,C28,C79 | 电解电容贴片6x6
4 | 2 | 105 | C7,C9 | C0603
5 | 1 | 103 | C18 | C0603
6 | 2 | 33pF | C20,C21 | C0603
7 | 2 | 22pF | C22,C23 | C0603
8 | 10 | 100nF | C29,C30,C31,C32,C33,C34,C35,C36,C77,C78 | C0603
9 | 5 | 47uF/50V | C38,C40,C42,C44,C46 | 电解电容贴片6x6
10 | 5 | 224 | C57,C58,C59,C60,C61 | C0603
11 | 6 | 103 | C64,C65,C66,C67,C68,C69 | 0603C
12 | 1 | 220uF | C71 | CAP-TH_BD12.5
13 | 3 | 4.7uF | C72,C73,C74 | C0805
14 | 1 | 10uF | C76 | C0805
15 | 2 | --- | D1,D5 | 0603LED
16 | 4 | SS56 | D2,D3,D4,D10 | SMA
17 | 3 | -̹- | D6,D8,D9 | 0603LED
18 | 1 | SMBJ36A | D11 | SMB_L4.6-
19 | 3 | ESD05V52D | D12,D13,D14 | SOD-523_L1.2
20 | 2 | 稳压管 | DZ1,DZ2 | SMC
21 | 1 | 稳压管 | DZ3 | SMA
22 | 1 | MPJA101- | JP1 | HDR-TH_8P-P2.54
23 | 1 | SW_6X6_H=12.0MM | K1 | KEY-SMD_4P-L6.0-W6.0-P4.50-LS9.0
24 | 2 | 33uH | L1,L2 | IND-SMD_L13.45-W12.6
25 | 1 | 33uH | L3 | IND-SMD_L7.0-W7.0_SMDRI74-330MT
26 | 1 | DC007B | P1 | DC007B
27 | 1 | DB2ER-5.0-2P-GN | P2 | conn-th_2p-p5.00_db2er-5.0-2p-gn
28 | 5 | 6P | P3,P33,P34,P35,P36 | HDR1X6_CON
29 | 6 | 3P | P4,P6,P8,P10,P11,P14 | HDR1X3_CON
30 | 9 | 2P | P5,P9,P12,P13,P19,P20,P29,P30,P32 | HDR1X2_CON
31 | 1 | 4P | P7 | SIP4
32 | 2 | 2P--ɫ | P15,P31 | HDR1X2_CON
33 | 1 | HC-JN254-2-04-W | P16 | HDR-TH_8P-P2.54-H-F-R2-C4-W9.0
34 | 1 | 2P | P17 | CONN-TH_2P-P5.00_DB2ER-5.0-2P-GN
35 | 1 | DB2ER-5.0-2P-GN | P18 | CONN-TH_2P-P5.00_DB2ER-5.0-2P-GN
36 | 2 | XH-3AW | P21,P22 | conn-th_3p-p2.54_hctl_xh-3aw
37 | 5 | 4P | P23,P24,P25,P26,P27 | HDR1X4_CON
38 | 1 | Header 3X2 | P28 | HDR2X3
39 | 1 | F50N06 | Q1 | TO-252
40 | 1 | F540NS | Q2 | TO-263-2
41 | 2 | SS8050 | Q3,Q5 | SOT-23
42 | 1 | SI2301CDS-T1-GE3 | Q4 | SOT-23-3_L3.0-W1.7-P0.95-LS2.9-BR
43 | 1 | si2302-nmosfet | Q6 | SOT-23-3_L2.9-W1.3-P1.90-LS2.4-BR
44 | 8 | 1K | R1,R12,R21,R36,R37,R38,R99,R101 | 0603R
45 | 2 | 10k | R2,R11 | 0603R
46 | 1 | 1K!! | R3 | 0603R
47 | 1 | 1K? | R4 | 0603R
48 | 1 | 1.8K | R5 | 0603R
49 | 4 | 470R | R6,R9,R19,R27 | 0603R
50 | 28 | 10K | R7,R8,R10,R13,R16,R20,R28,R30,R33,R35,R42,R65,R66,R67,R68,R69,R76,R77,R78,R86,R88,R90,R92,R94,R96,R100,R102,R103 | 0603R
51 | 1 | 680!! | R14 | 0603R
52 | 13 | 100 | R15,R34,R39,R40,R41,R75,R85,R87,R89,R91,R93,R95,R97 | 0603R
53 | 2 | 1M | R22,R23 | R0603
54 | 10 | 0.1 | R45,R46,R47,R48,R49,R50,R51,R52,R53,R54 | 0805R
55 | 5 | 20K | R55,R56,R57,R58,R59 | 0603R
56 | 5 | 10K | R60,R61,R62,R63,R64 | 松下贴片电位器3x3
57 | 5 | 0 | R70,R71,R72,R73,R74 | 0603R
58 | 2 | 0R | R104,R105 | R1210
59 | 3 | 10K | R106,R107,R109 | R0603
60 | 1 | 1K | R108 | R0603
61 | 1 | 0R | R110 | R0603
62 | 1 | ZX-VH3.96 | SW1 | CONN-TH_3P
63 | 1 | SK12D07VG5 | SW2 | SW-TH_SHOU_SK12D07VG5
64 | 1 | HYM2596S-12 | U1 | TO-263-5_L10.2-W8.6-P1.70-LS14.4-BR
65 | 1 | LM2596S-5.0RG | U2 | TO-263-5
66 | 1 | 1117-3.3 | U3 | SOT-223
67 | 1 | B0505LS-1WR3 | U4 | PWRM-TH_BXXXXLS
68 | 1 | STM32F103C8T6/CBT6 | U6 | LQFP48
69 | 5 | LTV-357T-C | U7,U9,U10,U12,U31 | SOP-4_L4.4
70 | 1 | CH340G | U8 | SOP16
71 | 1 | 74LVC1G17 | U13 | SOT-23-5
72 | 1 | 74LVC1G04 | U15 | SOT-23-5
73 | 5 | CA-IS3720 | U16,U17,U19,U20,U30 | SOIC-8_L4.9-
74 | 5 | HR4988SQ | U21,U22,U23,U24,U25 | QFN28
75 | 1 | MSUSBLC6 | U29 | SOT-23-6
76 | 1 | USB-B10 | USB1 | USB-B-TH_
77 | 1 | 12M | Y1 | 晶振贴片49SSMD
78 | 1 | 8M | Y2 | 晶振贴片
