gqkhao/pcb-schematics/4轴3.0/BOM__4轴3.0_2025-04-21.xlsx

序号 | 数量 | 名称 | 位号 | 封装
1 | 24 | 104 | C1,C5,C6,C7,C19,C22,C23,C24,C25,C26,C27,C28,C29,C30,C32,C37,C41,C42,C43,C70,C71,C72,C73,C85 | 0603C
2 | 2 | 22pF | C2,C3 | 0603C
3 | 2 | 220uF/16V | C4,C31 | 电解电容贴片6x6
4 | 7 | 47uF/50V | C10,C33,C34,C35,C36,C38,C86 | 电解电容贴片6x6
5 | 4 | 105 | C11,C13,C16,C18 | 0603C
6 | 5 | 100uF/35V | C12,C15,C17,C20,C21 | 电解电容贴片6x6
7 | 1 | 33nF | C14 | 0603C
8 | 2 | 33pF | C39,C40 | 0603C
9 | 2 | 绿光 | D1,D7 | 0603LED
10 | 2 | SS56 | D3,D8 | SMA
11 | 1 | SS56 | D4 | SMC
12 | 1 | SS34 | D6 | SMA
13 | 1 | RS5M | D9 | SMC
14 | 3 | 红光 | D10,D20,D21 | 0603LED
15 | 1 | SMBJ36A | DZ1 | SMB
16 | 2 | SMAZ10V | DZ2,DZ3 | SMA
17 | 2 | PZ254V-11-02P | H1,H1 | HDR-TH_2P-P2.54-V-M
18 | 10 | 8P | J1,J2,J3,J4,J5,J6,J7,J8,J13,J14 | HDR1X8
19 | 1 | DIV-X | J9 | HDR2X3
20 | 1 | DIV-Y | J10 | HDR2X3
21 | 1 | DIV-Z | J11 | HDR2X3
22 | 1 | DIV-A | J12 | HDR2X3
23 | 1 | DIV-Y2 | J15 | HDR2X3
24 | 1 | 开关 | K1 | 按键6x6贴片
25 | 1 | 47uH/5A | L1 | 电感贴片12x12
26 | 1 | 8P | P2 | IDC8
27 | 1 | Header 4X2H | P3 | HDR2X4H
28 | 1 | 3P | P4 | SIP4
29 | 1 | DC007B | P6 | DC007B
30 | 1 | DF2EDGK-4P | P7 | 直插座4P-DF2EDGK
31 | 1 | 2P | P8 | VH3.96-2P直插座
32 | 1 | Header 10X2H | P9 | HDR2X10
33 | 2 | 2P红色 | P10,P11 | HDR1X2_CON
34 | 1 | 2P | P12 | HDR1X2_CON
35 | 3 | 3P | P13,P25,P30 | HDR1X3_CON
36 | 5 | 4P | P14,P16,P17,P18,P20 | HDR1X4_CON
37 | 1 | PZ254V-11-03P | P15 | HDR-TH_3P-P2.54-V-M
38 | 4 | 6P | P15,P19,P21,P22 | HDR1X6_CON
39 | 1 | 50N06 | Q1 | TO-252
40 | 1 | F540NS | Q2 | TO-263-2
41 | 4 | 10k | R1,R2,R3,R8 | 0603R
42 | 2 | 510Ω | R4,R5 | 0603R
43 | 1 | 2K | R6 | 0603R
44 | 2 | 1K | R7,R14 | 0603R
45 | 2 | 5.1K | R9,R59 | 0603R
46 | 1 | 16K | R10 | 0603R
47 | 1 | 1.8K | R11 | 0603R
48 | 33 | 10K | R13,R20,R22,R24,R26,R28,R38,R40,R42,R44,R47,R48,R49,R50,R51,R52,R53,R54,R55,R56,R57,R58,R60,R61,R62,R70,R71,R72,R73,R74,R75,R81,R85 | 0603R
49 | 1 | 100 | R15 | 0603R
50 | 5 | 680 | R16,R19,R21,R23,R25 | 0603R
51 | 15 | 470 | R27,R29,R30,R31,R32,R33,R34,R35,R36,R37,R39,R41,R43,R45,R46 | 0603R
52 | 1 | STM32F103C8T6/CBT6 | U1 | LQFP48
53 | 1 | CJ7805 | U2 | TO-263-2
54 | 1 | XL4015 | U3 | TO-263
55 | 1 | B0505LS-1WR2 | U4 | B0505LS-1W
56 | 1 | 1117-3.3 | U5 | SOT-223
57 | 1 | 74LVC1G126/74LVC1G08 | U6 | SOT-23-5
58 | 9 | LTV-357T-B | U8,U9,U10,U11,U12,U17,U18,U19,U20 | SOP4
59 | 5 | 6N137 | U13,U14,U15,U16,U21 | SMD8
60 | 1 | 74LVC1G17 | U22 | SOT-23-5
61 | 1 | MSUSBLC6-2SC6 | U23 | SOT-23-6_L2.9-W1.6-P0.95-LS2.8-BL
62 | 1 | CH340G | U24 | SOIC-16_L9.9-W3.9-P1.27-LS6.0-BL
63 | 1 | USB-B10-BRW | USB_TTL | USB-B-TH_USB-B12-BRW
64 | 1 | 8M | Y1 | 晶振贴片
65 | 1 | 12M | Y2 | 晶振贴片49SSMD
