gqkhao/pcb-schematics/3轴6.0--esp32/BOM_esp32_原理图_2025-08-15.xlsx

No. | 数量 | Comment | 位号 | Footprint
1 | 8 | 103 | C1,C4,C11,C12,C13,C14,C15,C16 | 11
2 | 3 | 100uF/35V | C2,C7,C22 | 电解电容贴片6X6
3 | 9 | 104 | C3,C6,C10,C21,C23,C27,C28,C29,C30 | 0603C
4 | 1 | 10uF | C5 | C1206
5 | 1 | 4.7uF | C8 | C1206
6 | 2 | 33pF | C24,C25 | 0603C
7 | 1 | SS56 | D1 | SMA
8 | 1 | SS34 | D2 | SMA
9 | 3 | 绿光 | D3,D5,D7 | 0603LED
10 | 1 | PESD5V0L1BA-N | D4 | SOD-323_L1.8-
11 | 1 | PESD3V3L1BA-N | D6 | SOD-323_L1.8
12 | 1 | DC007B-2.5 | DC1 | DC-IN-TH_HX
13 | 1 | PZ254V-11-02P | H10 | HDR-TH_2P-P2.54-V-M
14 | 1 | 68uH | L1 | IND-SMD_L7.0
15 | 4 | 3P | P1,P2,P3,P19 | HDR1X3_CON
16 | 4 | 2P | P4,P5,P6,P8 | HDR1X2_CON
17 | 1 | PZ254V-11-03P | P15 | HDR-TH_3P-P2.54-V-M
18 | 1 | 8P | P21 | IDC8
19 | 1 | USB-B10-BRW | P22 | USB-B-TH_USB
20 | 6 | 4P | P23,P28,P29,P30,P31,P33 | HDR1X4_CON
21 | 1 | 5.08-2P | P27 | CONN-TH_WJ2EDGVC-5.08-2P
22 | 3 | SS8050 | Q1,Q4,Q5 | SOT-23-3_L2.9-W1.3-P1.90-LS2.4-BR
23 | 3 | 20K | R1,R4,R8 | 10
24 | 3 | 100 | R2,R5,R9 | 10
25 | 1 | 47K | R3 | 0603R
26 | 13 | 10K | R6,R7,R10,R13,R15,R16,R17,R33,R34,R58,R62,R69,R75 | 0603R
27 | 1 | 20K | R11 | 0603R
28 | 6 | 100 | R12,R14,R18,R19,R20,R59 | 0603R
29 | 1 | 1K | R36 | 0603R
30 | 1 | 0Ω | R37 | 0603R
31 | 4 | 510Ω | R60,R61,R65,R67 | 0603R
32 | 1 | 10kΩ | R71 | R0603
33 | 1 | XL1509-5.0E | U1 | ESOP-8_
34 | 1 | 1117-3.3 | U2 | SOT-223
35 | 1 | ESP32-WROOM-32 | U3 | WIFI-SMD_ESP32-WROOM-32UE-A
36 | 1 | 74LVC1G17 | U6 | SOT-23-5
37 | 1 | CH340G | U7 | SOIC-16
38 | 1 | USBLC2-2SC6 | U9 | SOT-23-6
39 | 2 | 74AHCT595T16-13 | U19,U20 | TSSOP-16_L5.0-W4.4-P0.65-LS6.4-BL
40 | 1 | 12M | Y1 | 晶振贴片49SSMD
