gqkhao/pcb-schematics/3轴6.0--esp32/BOM_esp32__2025-06-25.xlsx

No. | 数量 | Comment | Designator | Footprint
1 | 8 | 104 | C1,C4,C11,C12,C13,C14,C15,C16 | 11
2 | 3 | 100uF/35V | C2,C7,C22 | 电解电容贴片6X6
3 | 6 | 104 | C3,C6,C10,C21,C23,C27 | 0603C
4 | 2 | 4.7uF或者10uF | C5,C8,C9 | C1206
5 | 2 | 33pF | C24,C25 | 0603C
6 | 1 | 104 | C26 | 11
7 | 2 | SS34或者SS56 | D1,D2,D10 | SMA
8 | 3 | 绿光或者红光 | D3,D5,D7 | 0603LED
9 | 1 | PESD5V0L1BA-N | D4 | SOD-323_L1.8-W1.3-LS2.5-BI
10 | 1 | PESD3V3L1BA-N | D6 | SOD-323_L1.8-W1.3-LS2.5-BI
11 | 1 | DC007B-2.5 | DC1 | DC-IN-TH_HX-DC007B-2.5
12 | 1 | PZ254V-11-02P | H10 | HDR-TH_2P-P2.54-V-M
13 | 1 | SW_6X6_H=12.0MM | K1 | KEY-SMD_4P-L6.0-W6.0-P4.50-LS9.0
14 | 1 | 68uH | L1 | IND-SMD_L7.0-W7.0_SMDRI74-330MT
15 | 4 | 3P | P1,P2,P3,P19 | HDR1X3_CON
16 | 5 | 2P | P4,P5,P6,P7,P8 | HDR1X2_CON
17 | 1 | PZ254V-11-03P | P15 | HDR-TH_3P-P2.54-V-M
18 | 1 | 8P | P21 | IDC8
19 | 1 | USB-B10-BRW | P22 | USB-B-TH_USB-B10-BRW
20 | 5 | 4P | P23,P28,P29,P30,P31 | HDR1X4_CON
21 | 1 | 5.08-2P | P27 | CONN-TH_WJ2EDGVC-5.08-2P
22 | 2 | SS8050 | Q4,Q5 | SOT-23-3_L2.9-W1.3-P1.90-LS2.4-BR
23 | 3 | 20K | R1,R4,R8 | 10
24 | 3 | 100Ω | R2,R5,R9 | 10
25 | 1 | 47K | R3 | 0603R
26 | 11 | 10K | R6,R7,R10,R13,R15,R16,R58,R62,R69,R73 | 0603R
27 | 1 | 20K | R11 | 0603R
28 | 6 | 100 | R12,R14,R18,R19,R59 | 0603R
29 | 4 | 100Ω | R60,R61,R65,R67 | 0603R
30 | 1 | XL1509-5.0E1//SXL1509-5.0E1 | U1 | ESOP-8_L4.9-W3.9-P1.27-LS6.0-BL-EP
31 | 1 | 1117-3.3 | U2 | SOT-223
32 | 1 | ESP32-WROOM-32 | U3 | WIFI-SMD_ESP32-WROOM-32UE-A
33 | 2 | 74LVC1G17 | U6,U10 | SOT-23-5
34 | 1 | CH340C/CH340G | U7 | SOIC-16_L9.9-W3.9-P1.27-LS6.0-BL
35 | 1 | USBLC2-2SC6 | U9 | SOT-23-6
36 | 1 | CA-IS3760 | U15 | SOIC-16_L9.9-W3.9-P1.27-LS6.0-BL
