gqkhao/pcb-schematics/3轴6.0--esp32/BOM_esp32__08-02.xlsx

No. | 数量 | Comment | Designator | Footprint
1 | 6 | 103 | C1,C4,C5,C12,C14,C15 | 11
2 | 2 | 100uF/35V | C2,C13 | 电解电容贴片6X6
3 | 13 | 104 | C3,C7,C11,C16,C17,C18,C19,C20,C21,C22,C23,C24,C25 | 0603C
4 | 1 | 10uF | C6 | C1206
5 | 1 | 100uF/10V | C8 | CAP-SMD_BD5.0-L5.3-W5.3-RD
6 | 2 | 4.7uF | C9,C10 | C1206
7 | 2 | 33pF | C26,C28 | 0603C
8 | 1 | 104 | C27 | 11
9 | 1 | SS56 | D1 | SMA
10 | 1 | SS34 | D2 | SMA
11 | 4 | 绿光 | D3,D5,D7,D8 | 0603LED
12 | 1 | PESD5V0L1BA-N | D4 | SOD-323_L1.8-W1.3-LS2.5-BI
13 | 1 | PESD3V3L1BA-N | D6 | SOD-323_L1.8-W1.3-LS2.5-BI
14 | 3 | 1N4148 | D9,D10,D11 | SOD-123_L2.8-W1.8-LS3.7-RD
15 | 1 | --ѹ------SMAZ10V | DZ1 | SMA
16 | 1 | SW_6X6_H=12.0MM | K1 | KEY-SMD_4P-L6.0-W6.0-P4.50-LS9.0
17 | 1 | TS-1088-AR02016 | K2 | SW-SMD_L3.9-W3.0-P4.45
18 | 1 | 68uH | L1 | IND-SMD_L7.0-W7.0_SMDRI74-330MT
19 | 1 | WJ2EDGR-5.08-2P | P1 | CONN-TH_WJ2EDGR-5.08-2P
20 | 8 | 3P | P2,P3,P4,P5,P9,P11,P15,P16 | HDR1X3_CON
21 | 2 | 2P | P6,P12 | HDR1X2_CON
22 | 5 | 4P | P7,P8,P10,P13,P14 | HDR1X4_CON
23 | 1 | USB-B10-BRW | P17 | USB-B-TH_USB-B10-BRW
24 | 1 | F50N06 (FR9024N) | Q1 | TO-252
25 | 1 | SS8050 | Q2 | SOT-23
26 | 3 | SS8050 | Q3,Q4,Q5 | SOT-23-3_L2.9-W1.3-P1.90-LS2.4-BR
27 | 4 | 20K | R1,R4,R5,R10 | 10
28 | 4 | 100 | R2,R6,R7,R11 | 10
29 | 1 | 47K | R3 | 0603R
30 | 19 | 10K | R8,R9,R12,R15,R17,R18,R22,R23,R24,R25,R26,R27,R28,R29,R30,R31,R34,R35,R40 | 0603R
31 | 1 | 100K | R13 | 0603R
32 | 1 | 50K | R14 | 0603R
33 | 1 | 2K | R16 | 0603R
34 | 1 | 20K | R19 | 0603R
35 | 2 | 100 | R20,R21 | 0603R
36 | 1 | 1K | R32 | 0603R
37 | 1 | 0Ω | R33 | 0603R
38 | 4 | 10K | R36,R37,R38,R39 | 10
39 | 1 | XL1509-5.0E1//SXL1509-5.0E1 | U1 | ESOP-8_L4.9-W3.9-P1.27-LS6.0-BL-EP
40 | 1 | 1117-3.3 | U2 | SOT-223
41 | 2 | 74LVC1G04 | U3,U11 | SOT-23-5
42 | 6 | 74LVC1G17 | U4,U7,U8,U9,U10,U12 | SOT-23-5
43 | 1 | ESP32-WROOM-32 | U5 | WIFI-SMD_ESP32-WROOM-32UE-A
44 | 1 | CA-IS3760 | U6 | SOIC-16_L9.9-W3.9-P1.27-LS6.0-BL
45 | 1 | CH340G | U13 | SOIC-16_L9.9-W3.9-P1.27-LS6.0-BL
46 | 1 | 自弹TF卡座TFAA | U14 | SIM-SMD_C9900015645
47 | 1 | USBLC2-2SC6 | U15 | SOT-23-6
48 | 1 | 12M | Y1 | 晶振贴片49SSMD
