gqkhao/pcb-schematics/3020-2.0包裹款/3020-2.0-BOM（不含换刀和刀仓）.xls

Sheet: 汇总
3020-2.0-BOM（不含换刀和刀仓）
序号 | 部件 | 名称 | 类型 | 型号 | 数量 | 材质 | 备注 | 参考价格 | 说明
1 | 安装 | 螺钉 | 内六角沉头螺栓 | M4×22 | 8 | 不锈钢 | 紧固件 |  | 部分仓库有，无需购买
2 |  | 螺钉 |  | M4×8 | 5 | 不锈钢 | 紧固件
3 |  | 螺钉 | 内六角圆头螺钉 | M3×24 | 8 | 不锈钢 | 紧固件
4 |  | 螺钉 |  | M3×6 | 8 | 不锈钢 | 紧固件
5 |  | 螺钉 |  | M3×8 | 4 | 不锈钢 | 紧固件
6 |  | 螺钉 |  | M4×10 | 84 | 不锈钢 | 紧固件
7 |  | 螺钉 |  | M4×12 | 12 | 不锈钢 | 紧固件
8 |  | 螺钉 |  | M4×16 | 18 | 不锈钢 | 紧固件
9 |  | 螺钉 |  | M4×8 | 44 | 不锈钢 | 紧固件
10 |  | 螺钉 |  | M5×10 | 4 | 不锈钢 | 紧固件
11 |  | 螺钉 |  | M5×12 | 4 | 不锈钢 | 紧固件
12 |  | 螺钉 | 内六角圆柱头螺钉 | M4×12 | 12 | 不锈钢 | 紧固件
13 |  | 螺钉 |  | M5×20 | 2 | 不锈钢 | 紧固件
14 |  | 螺钉 |  | M4×16 | 16 | 不锈钢 | 紧固件
15 |  | 螺钉 |  | M6×40 | 4 | 不锈钢 | 紧固件
16 |  | 螺钉 |  | M3×16 | 16 | 不锈钢 | 紧固件
17 |  | 螺钉 |  | M5×16 | 12 | 不锈钢 | 紧固件
18 |  | 螺钉 |  | M3×30 | 8 | 不锈钢 | 紧固件
19 |  | 螺钉 |  | M3×12 | 12 | 不锈钢 | 紧固件
20 |  | 螺钉 |  | M3×8 | 34 | 不锈钢 | 紧固件
21 |  | 螺钉 |  | M5×12 | 4 | 不锈钢 | 紧固件
22 |  | 螺钉 |  | M6×12 | 10 | 不锈钢 | 紧固件
23 |  | 螺钉 |  | M5×10 | 4 | 不锈钢 | 紧固件
24 |  | 螺钉 |  | M3×6 | 2 | 不锈钢 | 紧固件
25 |  | 螺钉 |  | M4×10 | 38 | 不锈钢 | 紧固件
26 |  | 螺钉 | 球头弹柱塞 | M12×16 | 2 | 不锈钢 | 紧固件
27 | 传动 | Y轴 | 轴承座 | BGTCA608ZZ（发黑） | 1 |  | 采购件
28 |  | Y限位 | 槽型光电开关 | C-MSX953N-2M | 1 |  | 采购件
29 |  | 联轴器 | 刚性夹持式联轴器 | CPMCR-D25-5-8 | 1 |  | 采购件
30 |  | 橡胶脚垫 |  | 22*18*22 | 4 |  | 采购件
31 |  | X丝杠轴承座 | 轴承座 | LBF10-E | 2 |  | 采购件
32 |  | X、Z传动 | 同步轮 | GT2-20齿-内孔8 | 2 |  | 采购件
33 |  |  | 同步轮 | GT2-20齿-内孔5 | 2 |  | 采购件
34 |  |  | 2GT同步带（闭口） | 宽6mm周长150 | 2 |  | 采购件
35 |  | X轴限位开关 | 槽型光电开关 | C-MSX951N-2M | 2 |  | 采购件
36 |  | Z轴限位开关 |  |  | 2 |  | 采购件
37 |  | Z轴丝杆轴承 | 深沟球轴承 | GB/T 276 628/8-2Z | 2 |  | 标准件
38 | 电控类（部分） | 急停开关 |  |  | 1 |  | 采购件 |  | 仓库有
39 |  | USB延长线 | USB-BF[2.0方口打印母免焊线]-上弯头 |  | 1 |  | 采购件
40 |  | 带开关和保险丝座的交流电源连接器 |  |  | 1 |  | 采购件 |  | 仓库有
41 |  | 小辣椒天线 | 弯头 |  | 1 |  | 采购件
42 |  | 天线连接线 | 30cm长 |  | 1 |  | 采购件
43 |  | 小辣椒天线垫套 |  |  | 1 |  | 3D打印
44 |  | 摄像头外壳 |  |  | 1 |  | 3D打印
 |  | 感应开关 | GL-8H(NPN常开)-顶面感应 |  |  |  |  |  | https://detail.tmall.com/item.htm?id=742695872793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
 |  |  | GL-8F(NPN常开)-正面感应 |  |  |  |  |  | https://detail.tmall.com/item.htm?id=742695872793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
 |  | 芯片 | 74HC595PW | TSSOP-16 | 5 |  |  | 6 | https://item.taobao.com/item.htm?id=522555271092
 |  | 稳压器 | XL1509-5.0E1 | SOP-8 | 5 |  |  | 4 | https://item.taobao.com/item.htm?id=522577620562
 |  | 光电耦合器 | LTV-357T-C | SOP-4 | 10 |  |  | 2.7 | https://item.taobao.com/item.htm?id=606786797596
 |  | 贴片电解电容 | 100uF_10V | 5*5.4mm | 15 |  |  | 1.9 | https://item.taobao.com/item.htm?id=522554867387&skuId=5898653519769
 |  | 贴片电解电容 | 100uF_35V | 6.3*7.7mm | 10 |  |  | 1.9 | https://item.taobao.com/item.htm?id=522554867387&skuId=5898653519717
 |  | 贴片LED灯 | 2835 | 正白0.2W | 2 |  |  | 0.66 | https://item.taobao.com/item.htm?abbucket=19&id=553612861789
 |  | 收发器 | UMW SP3232EEN | SOP-16 | 5 |  |  | 4 | https://item.taobao.com/item.htm?id=666773988729
 |  | 磁珠 | 120R | 0603 | 1 |  |  | 3 | https://detail.tmall.com/item.htm?id=795043080166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
 |  | 磁珠 | 10R | 0603 | 1 |  |  | 3 | https://detail.tmall.com/item.htm?id=795043080166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
 |  | FPC/FFC | 连接器插座6P | 1.0mm | 1 |  |  | 2 | https://item.taobao.com/item.htm?ali_trackid=282_c51cfab13b75d0dd1e8ef82740ef6e72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
 |  | FPC/FFC | 连接器插座40P | 0.5mm | 1 |  |  | 4.3 | https://item.taobao.com/item.htm?ali_trackid=282_c51cfab13b75d0dd1e8ef82740ef6e72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
 |  | FPC/FFC | 连接器插座6P | 0.5mm | 1 |  |  | 1.5 | https://item.taobao.com/item.htm?ali_trackid=282_c51cfab13b75d0dd1e8ef82740ef6e72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
45 | 辅助件 | 可调式扎带固定座 | 白色 CL-1(100个)强力胶 |  | 1 |  | 采购件 |  | https://item.taobao.com/item.htm?id=787325376292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

Sheet: 分项
3020-2.0-BOM（不含换刀和刀仓）
序号 | 部件 | 位置 | 类型 | 型号 | 数量 | 材质 | 备注 | 说明
1 | 外壳 | 端盖固定 | 内六角沉头螺栓 | M4×22 | 8 | 不锈钢 | 紧固件
2 |  | 侧板固定 | 内六角圆柱头螺钉 | M4×10 | 12 | 不锈钢 | 紧固件
3 |  |  | 内六角圆柱头螺钉 | M4×12 | 12 | 不锈钢 | 紧固件
4 |  | 集尘把手 | 内六角圆头螺钉 | M4×10 | 12 | 不锈钢 | 紧固件
5 |  | 集尘托板 | 内六角圆头螺钉 | M4×10 | 8 | 不锈钢 | 紧固件
6 |  |  | 球头弹柱塞 | M12×16 | 2 | 不锈钢 | 紧固件
7 |  |  | 薄螺母 | M12 | 2 | 不锈钢 | 紧固件
8 |  | 侧板金 | 内六角圆头螺钉 | M4×10 | 30 | 不锈钢 | 紧固件
9 |  | 顶板金 | 内六角圆头螺钉 | M4×10 | 12 | 不锈钢 | 紧固件
10 |  | 电控板 | 内六角圆头螺钉 | M4×12 | 12 | 不锈钢 | 紧固件
11 |  |  | 内六角圆头螺钉 | M4×8 | 10 | 不锈钢 | 紧固件
12 |  | 电路板 | 内六角圆柱头螺钉 | M3×8 | 6 | 发黑 | 紧固件
13 |  | 电源 | 内六角圆头螺钉 | M3×6 | 4 | 不锈钢 | 紧固件
14 |  | 摄像头板 | 内六角圆柱头螺钉 | M3×8 | 4 | 发黑 | 紧固件
15 |  | 背板 | 内六角圆头螺钉 | M4×8 | 34 | 不锈钢 | 紧固件
16 |  | 后连扳 | 内六角圆头螺钉 | M4×10 | 6 | 不锈钢 | 紧固件
17 |  | 左右前支撑 | 内六角圆头螺钉 | M4×10 | 8 | 不锈钢 | 紧固件
18 |  | 前集尘板 | 内六角圆头螺钉 | M3×24 | 4 | 不锈钢 | 紧固件
19 |  | 后集尘板 | 内六角圆头螺钉 | M3×24 | 4 | 不锈钢 | 紧固件
20 | 平台+Y结构（不含刀仓、主轴部分） | Y导轨 | 内六角圆头螺钉 | M4×16 | 12 | 不锈钢 | 紧固件
21 |  | Y导轨硬限位 | 内六角圆头螺钉 | M5×10 | 4 | 不锈钢 | 紧固件
22 |  | Y导轨滑块 | 内六角圆头螺钉 | M4×10 | 8 | 不锈钢 | 紧固件
23 |  | Y螺母座 | 内六角圆头螺钉 | M5×12 | 4 |  | 紧固件
24 |  | Y丝杠螺母 | 内六角圆头螺钉 | M4×16 | 6 |  | 紧固件
25 |  | Y防尘板 | 内六角圆柱头螺钉 | M3×8 | 4 |  | 紧固件
26 |  | Y限位支架 | 内六角圆柱头螺钉 | M3×8 | 1 |  | 紧固件
27 |  | Y限位开关 | 内六角圆柱头螺钉 | M3×8 | 1 |  | 紧固件
28 |  | Y限位触发 | 内六角圆头螺钉 | M3×6 | 4 |  | 紧固件
29 |  | Y轴承座固定 | 内六角圆柱头螺钉 | M5×20 | 2 |  | 紧固件
30 |  |  | 轴承座 | CBCZA-608ZZ | 1 |  | 采购件
31 |  | Y限位 | 槽型光电开关 | C-MSX953N-2M | 1 |  | 采购件
32 |  | 联轴器 | 刚性夹持式联轴器 | CPMCR-D25-5-8 | 1 |  | 采购件
33 |  | Y电机固定 | 内六角圆柱头螺钉 | M3×12 | 4 |  | 紧固件
34 |  | 橡胶脚垫 |  | 22*18*22 | 4 |  | 采购件
35 |  | 橡胶脚垫固定 | 内六角圆柱头螺钉 | M4×16 | 4 |  | 紧固件
36 | X+Y轴组件 | X丝杠轴承座 | 轴承座 | LBF10-E | 2 |  | 采购件
37 |  | X轴承座固定 | 内六角圆柱头螺钉 | M6×40 | 4 |  | 紧固件
38 |  | X限位触发 | 内六角圆头螺钉 | M3×8 | 4 |  | 紧固件
39 |  | X导轨固定 | 内六角圆柱头螺钉 | M3×16 | 16 |  | 紧固件
40 |  | 丝杠端盖 | 内六角沉头螺栓 | M4×8 | 5 | 不锈钢 | 紧固件
41 |  | X、Z电机座固定 | 内六角圆柱头螺钉 | M5×16 | 8 |  | 紧固件
42 |  | X、Z电机固定 | 内六角圆柱头螺钉 | M3×30 | 8 |  | 紧固件
43 |  | X、Z传动 | 同步轮 | GT2-20齿-内孔8 | 2 |  | 采购件
44 |  |  | 同步轮 | GT2-20齿-内孔5 | 2 |  | 采购件
45 |  |  | 2GT同步带（闭口） | 宽6mm周长150 | 2 |  | 采购件
46 |  | X轴限位开关 | 槽型光电开关 | C-MSX951N-2M | 2 |  | 采购件
47 |  | Z轴限位开关 |  |  | 2 |  | 采购件
48 |  | XZ限位固定 | 内六角圆柱头螺钉 | M3×8 | 8 |  | 紧固件
49 |  | Z轴丝杆轴承 | 深沟球轴承 | GB/T 276 628/8-2Z | 2 |  | 标准件
50 |  | X滑块固定 | 内六角圆柱头螺钉 | M4×10 | 8 |  | 标准件
51 |  | X丝杠螺母固定 | 内六角圆柱头螺钉 | M4×16 | 6 |  | 紧固件
52 |  | X丝杠螺母座固定 | 内六角圆柱头螺钉 | M5×12 | 4 |  | 紧固件
53 |  | Z轴底板固定 | 内六角圆柱头螺钉 | M6×12 | 10 |  | 紧固件
54 |  | Z丝杠螺母座固定 | 内六角圆柱头螺钉 | M5×16 | 4 |  | 紧固件
55 |  | Z轴导轨固定 | 内六角圆柱头螺钉 | M3×12 | 8 |  | 紧固件
56 |  | Z轴滑快固定 | 内六角圆柱头螺钉 | M4×10 | 8 |  | 紧固件
57 |  | Z轴丝杠螺母固定 | 内六角圆柱头螺钉 | M4×16 | 6 |  | 紧固件
58 |  | Z轴丝杠螺母座固定 | 内六角圆柱头螺钉 | M5×10 | 4 |  | 紧固件 | 沉孔过深
59 |  | Z轴开关触板 | 内六角圆柱头螺钉 | M3×6 | 2 |  | 紧固件
60 |  | Z轴外壳固定 | 内六角圆头螺钉 | M4×10 | 10 |  | 紧固件
61 | 电控类（部分） | 急停开关 |  |  | 1 |  | 采购件
62 |  | USB延长线 | USB-BF[2.0方口打印母免焊线]-上弯头 |  | 1 |  | 采购件
63 |  | 带开关和保险丝座的交流电源连接器 |  |  | 1 |  | 采购件
64 |  | 小辣椒天线 | 弯头 |  | 1 |  | 采购件
65 |  | 天线连接线 | 30cm长 |  | 1 |  | 采购件
66 |  | 小辣椒天线垫套 |  |  | 1 |  | 3D打印
67 |  | 摄像头外壳 |  |  | 1 |  | 4D打印
 |  | 感应开关 | GL-8H(NPN常开)-顶面感应 |  |  |  |  | https://detail.tmall.com/item.htm?id=742695872793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
 |  |  | GL-8F(NPN常开)-正面感应 |  |  |  |  | https://detail.tmall.com/item.htm?id=742695872793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
68 |  | 可调式扎带固定座 | 白色 CL-1(100个)强力胶 |  | 100 |  | 采购件
