gqkhao/pcb-schematics/2轴4.0/BOM_2轴.xlsx

No. | 数量 | Comment | 位号 | Footprint
1 | 1 | 100uF/35V | C1 | 电解电容贴片6x6
2 | 17 | 104 | C2,C7,C9,C10,C11,C12,C13,C15,C20,C21,C22,C31,C32,C33,C34,C35,C36 | 0603C
3 | 1 | 4.7uF | C3 | C1206
4 | 4 | 100uF/10V | C4,C5,C8,C19 | CAP-SMD_BD5.0-L5.3-W5.3-RD
6 | 2 | 103 | C14,C17 | 0603C
7 | 2 | 22pF | C16,C18 | 0603C
8 | 2 | 33pF | C23,C24 | 0603C
9 | 3 | 105 | C25,C27,C29 | C1206
10 | 3 | 100uF/35V | C26,C28,C30 | 电解电容贴片6X6
11 | 3 | 224 | C37,C38,C39 | 0603C
12 | 3 | SS56 | D1,D2,D10 | SMA
14 | 1 | PESD5V0L1BA-N | D3 | SOD-323_L1.8-W1.3-LS2.5-BI
15 | 5 | 红光 | D4,D6,D7,D9,D11 | 0603LED
16 | 2 | PESD5V0S1BLN | D5,D8 | SOD-323_L1.8-W1.3-LS2.5-BI
19 | 1 | DC007B-2.5 | DC1 | 插件DC圆头
20 | 1 | PZ254V-11-02P | H1 | HDR-TH_2P-P2.54-V-M
21 | 1 | 按键 | K1 | 按键18X13
22 | 1 | 开关 | K2 | 按键6X6贴片
23 | 1 | 68uH | L1 | IND-SMD_L7.0-W7.0_SMDRI74-330MT
24 | 2 | 2P | P1,P2 | HDR1X2_P
25 | 3 | 3P | P3,P4,P5 | HDR1X3_P
26 | 1 | PZ254V-11-04P | P6 | HDR-TH_4P-P2.54-V-F-3
27 | 1 | 8P | P7 | IDC8弯脚
28 | 3 | 4P | P8,P9,P10 | HDR1X4_P
29 | 1 | SS8050 | Q1 | SOT-23
30 | 17 | 10K | R1,R2,R3,R5,R6,R7,R8,R10,R12,R15,R16,R45,R47,R49,R51,R52,R53 | 0603R
31 | 1 | 2K | R4 | 0603R
32 | 2 | 20K | R9,R13 | 0603R
33 | 6 | 510Ω | R11,R14,R17,R20,R25,R27 | 0603R
34 | 12 | 2K | R18,R19,R21,R22,R23,R24,R26,R28,R29,R30,R31,R32 | 1206R
35 | 6 | 0.1 | R33,R34,R35,R36,R37,R38 | 0805R
36 | 3 | 30K | R39,R40,R41 | 0603R
37 | 3 | 10K | R42,R43,R44 | 松下贴片电位器3X3
38 | 3 | 100 | R46,R48,R50 | 0603R
39 | 1 | XL1509-5.0 | U1 | ESOP-8_L4.9-W3.9-P1.27-LS6.0-BL-EP
40 | 1 | CA-IS3760 | U2 | SOIC-16_L9.9-W3.9-P1.27-LS6.0-BL
41 | 1 | 1117-3.3 | U3 | SOT-223
42 | 1 | GD32F303CCT6 | U4 | LQFP48
43 | 1 | MSUSBLC6-2SC6 | U5 | SOT-23-6_L2.9-W1.6-P0.95-LS2.8-BL
44 | 1 | CH340G | U6 | SOP16
45 | 3 | HR4988SQ | U7,U8,U9 | QFN28
46 | 1 | USB-B10-BRW | USB | USB-B-TH_USB-B10-BRW
47 | 1 | 8M | Y1 | 晶振贴片
48 | 1 | 12M | Y2 | 晶振贴片49SSMD
