gqkhao/pcb-schematics/电机驱动TB6600/原电机驱动板/BOM_-电机驱动板.xlsx

序号 | 数量 | 规格参数 | 位号 | 封装
1 | 2 | 100uF/63V | C1,C6 | 电解电容贴片10x10
2 | 5 | 100uF/35V | C2,C3,C14,C16,C21 | 电解电容贴片6x6
3 | 4 | 104 | C4,C5,C15,C17,C22 | C1206
4 | 12 | 104 | C7,C8,C9,C10,C11,C12,C13,C18,C19,C20,C23,C24,C25 | C0603
5 | 3 | SS56 | D9,D10,D11 | SMA
6 | 1 | 贴片LED | D16 | 0603LED
7 | 1 | 47uH/5A | L1 | IND-SMD_L13.45-W12.6
8 | 2 | WJ2EDGVC-5.08-2P | P1,P7 | CONN-TH_WJ2EDGVC-5.08-2P
9 | 8 | 2.54单排针4P | P2,P3,P4,P5,P8,P9,P10,P11 | HDR1X4_CON
10 | 1 | PZ254V-11-02P | P6 | HDR-TH_2P-P2.54-V-M
11 | 1 | 2.54排针 | P12 | HDR2X3
12 | 4 | 10K | R1,R2,R12,R16 | 松下贴片电位器3x3
13 | 8 | 0.2 | R3,R4,R5,R6,R13,R14,R17,R18 | 0805R
14 | 7 | 10K | R7,R8,R15,R20,R21,R22,R23 | 0603R
15 | 1 | 44.2K | R9 | 0603R
16 | 1 | 2.37K | R10 | 0603R
17 | 1 | 100K | R11 | 0603R
18 | 1 | 100Ω | R19 | 0603R
19 | 1 | LM2576HVS-ADJ | U1 | TO-263
20 | 4 | HR8825 | U2,U3,U4,U5 | HTSSOP-28_L9.7-W4.4-P0.65-LS6.4-BL-EP-1
