gqkhao/pcb-schematics/3轴4.0/BOM和Gerber制板文件（采购用LY-3X4.0-V2.0）/BOM_3轴4.0.xlsx

No. | Quantity | Comment | Designator | Footprint | Name
1 | 1 | 1 |  | 1
2 | 1 | 5 |  | 5
3 | 1 | 2 |  | 2
4 | 1 | 3 |  | 3
5 | 1 | 4 |  | 4
6 | 1 | 6 |  | 6
7 | 1 | 7 |  | 7
8 | 1 | 8 |  | 8
9 | 1 | 9 |  | 9
10 | 1 | 99 |  | 99
11 | 1 | 98 |  | 98
12 | 1 | 97 |  | 97
13 | 1 | 95 |  | 95
14 | 1 | 93 |  | 93
15 | 1 | 94 |  | 94
16 | 1 | 92 |  | 92
17 | 1 | 91 |  | 91
18 | 1 | 90 |  | 90
19 | 1 | 89 |  | 89
20 | 1 | 88 |  | 88
21 | 1 | 87 |  | 87
22 | 1 | 86 |  | 86
23 | 1 | 84 |  | 84
24 | 1 | 83 |  | 83
25 | 1 | 82 |  | 82
26 | 1 | 85 |  | 85
27 | 1 | 81 |  | 81
28 | 1 | 80 |  | 80
29 | 1 | 79 |  | 79
30 | 1 | 77 |  | 77
31 | 1 | 76 |  | 76
32 | 1 | 55 |  | 55
