gqkhao/pcb-schematics/3020机器转接板/限位开关_2024-06-05/限位开关BOM.xlsx

限位开关副板
序号 | 元件 | 位号 | 封装 | 用量 | 需求数量 | 实际到料
3 | 插件开关6*6*12 | SW1 | DIP-4 | 1
