gqkhao/pcb-schematics/电机驱动TB6600/TB6600驱动板/TB6600驱动参考/BOM_Board1_TB6600_2022-10-04night.xlsx

No. | Quantity | Device | Designator | Footprint | Value | Manufacturer Part | Manufacturer | Supplier Part | Supplier
1 | 3 | CC0603KRX7R9BB104 | C1,C7,C15 | C0603 | 100nF | CC0603KRX7R9BB104 | YAGEO(国巨) | C14663 | LCSC
2 | 3 | CL10A105KO8NNNC | C2,C5,C9 | C0603 | 1uF | CL10A105KO8NNNC | SAMSUNG(三星) | C1592 | LCSC
3 | 4 | CL10B104KA8NNNC | C3,C4,C12,C13 | C0603 | 100nF | CL10B104KA8NNNC | SAMSUNG(三星) | C1590 | LCSC
4 | 2 | CL10A105KB8NNNC | C6,C16 | C0603 | 1uF | CL10A105KB8NNNC | SAMSUNG(三星) | C15849 | LCSC
5 | 1 | 16YXJ100M5X11 | C8 | CAP-TH_BD5.0-P2.00-D0.8-FD | 100uF | 16YXJ100M5X11 | rubycon(红宝石) | C108735 | LCSC
6 | 1 | CC0603KRX7R6BB333 | C10 | C0603 | 33nF | CC0603KRX7R6BB333 | YAGEO(国巨) | C519426 | LCSC
7 | 2 | KM107M050F12RR0VH2FP0 | C11,C14 | CAP-TH_BD8.0-P3.50-D0.6-FD | 100uF | KM107M050F12RR0VH2FP0 | CX(承兴) | C2749 | LCSC
8 | 8 | SS310 | D1,D2,D3,D4,D5,D6,D7,D8 | SMA_L4.3-W2.6-LS5.1-R-RD |  | SS310 | GOODWORK(固得沃克) | C2848687 | LCSC
9 | 3 | 1N4148 | D9,D10,D11 | DO-35_BD2.0-L4.0-P8.00-D0.5-FD |  | 1N4148 | ST(先科) | C14516 | LCSC
10 | 1 | SMAJ51CA | D12 | SMA_L4.3-W2.7-LS5.0-BI |  | SMAJ51CA | GOODWORK(固得沃克) | C908832 | LCSC
11 | 1 | 0451004.MRL | F2 | FUSE-SMD_L6.1-W2.7 |  | 0451004.MRL | Littelfuse(美国力特) | C27515 | LCSC
12 | 1 | MWSA0603S-470MT | L1 | IND-SMD_L7.3-W6.8 | 47uH | MWSA0603S-470MT | Sunlord(顺络) | C408455 | LCSC
13 | 1 | XL-2012SURC | LED1 | LED0805-RD_RED |  | XL-2012SURC | XINGLIGHT(成兴光) | C965812 | LCSC
14 | 1 | 0603WAF5102T5E | R1 | R0603 | 51kΩ | 0603WAF5102T5E | UNI-ROYAL(厚声) | C23196 | LCSC
15 | 5 | 0603WAF2001T5E | R2,R5,R6,R10,R17 | R0603 | 2kΩ | 0603WAF2001T5E | UNI-ROYAL(厚声) | C22975 | LCSC
16 | 4 | 0805W8F300LT5E | R3,R4,R7,R8 | R0805 | 300mΩ | 0805W8F300LT5E | UNI-ROYAL(厚声) | C247157 | LCSC
17 | 2 | 0805W8F1002T5E_C17414 | R9,R18 | R0805 | 10kΩ | 0805W8F1002T5E | UNI-ROYAL(厚声) | C17414 | LCSC
18 | 2 | 0603WAF4700T5E | R11,R12 | R0603 | 470Ω | 0603WAF4700T5E | UNI-ROYAL(厚声) | C23179 | LCSC
19 | 3 | RC0603FR-071KL | R13,R15,R16 | R0603 | 1kΩ | RC0603FR-071KL | YAGEO(国巨) | C22548 | LCSC
20 | 2 | 0603WAF3600T5E | R14,R27 | R0603 | 360Ω | 0603WAF3600T5E | UNI-ROYAL(厚声) | C25194 | LCSC
21 | 1 | 0603WAF3301T5E | R19 | R0603_NEW | 3.3kΩ | 0603WAF3301T5E | UNI-ROYAL(厚声) | C22978 | LCSC
22 | 1 | 0603WAF5103T5E | R20 | R0603 |  | 0603WAF5103T5E | UNI-ROYAL(厚声) | C23192 | LCSC
23 | 1 | 0603WAF6800T5E | R21 | R0603 | 680Ω | 0603WAF6800T5E | UNI-ROYAL(厚声) | C23228 | LCSC
24 | 1 | 0603WAF4120T5E | R22 | R0603 | 412Ω | 0603WAF4120T5E | UNI-ROYAL(厚声) | C23051 | LCSC
25 | 2 | 0805W8F1003T5E | R23,R28 | R0805 | 100kΩ | 0805W8F1003T5E | UNI-ROYAL(厚声) | C149504 | LCSC
26 | 1 | 0603WAF1201T5E | R24 | R0603 |  | 0603WAF1201T5E | UNI-ROYAL(厚声) | C22765 | LCSC
27 | 1 | 3362P-1-502 | R25 | RES-ADJ-TH_3362P | 5kΩ | 3362P-1-502 | BOCHEN(博晨) | C118903 | LCSC
28 | 1 | 0603WAF0000T5E | R26 | R0603 | 0Ω | 0603WAF0000T5E | UNI-ROYAL(厚声) | C21189 | LCSC
29 | 1 | 拨码开关,平拨开关,DSWB04LHGET | SW1 | SW-TH_DSWB04LHGET |  | 拨码开关,平拨开关,DSWB04LHGET | YE | C99418 | LCSC
30 | 1 | TB6600HG | U1 | HZIP25-P-1.0_TB6600HG |  | TB6600HG | TOSHIBA(东芝) | C66042 | LCSC
31 | 2 | EL817MB | U2,U3 | DIP-4_L6.5-W4.6-P2.54-LS10.2-BL |  | EL817MB | EVERLIGHT(台湾亿光) | C2912098 | LCSC
32 | 1 | 6N137_C142297 | U4 | DIP-8_L9.8-W6.6-P2.54-LS7.6-BL |  | 6N137 | EVERLIGHT(台湾亿光) | C142297 | LCSC
33 | 1 | XL7005A | U5 | SOIC-8_L4.9-W3.9-P1.27-LS6.0-BL-EP3.1-1 |  | XL7005A | XLSEMI(芯龙) | C50848 | LCSC
34 | 6 | DB125-2.54-2P-GN | U6,U9,U10,U11,U12,U13 | CONN-TH_DB125-2.54-2P-GN |  | DB125-2.54-2P-GN | DIBO(地博电气) | C918120 | LCSC
35 | 1 | SN74LS123DR | U7 | SOIC-16_L9.9-W3.9-P1.27-LS6.0-BL |  | SN74LS123DR | TI(德州仪器) | C234231 | LCSC
36 | 1 | SS210 | U8 | SMA_L4.3-W2.7-LS5.1-RD |  | SS210 | UMW(友台半导体) | C2988626 | LCSC
