gqkhao/pcb-schematics/001发采购/4040--4.0/激光转接板V1.0+BOM无线材/激光转接板--BOM.xlsx

序号 | 数量 | 元器件 | 位号 | 封装
1 | 4 | XH2.54-3P弯针 | P1,P2,P3,P4 | 3P弯针插件
全部是插件物料
