gqkhao/pcb-schematics/001发采购/4040--4.0/X转接板V1.0+BOM+线材/X转接板--BOM.xlsx

序号 | 数量 | 元器件 | 位号 | 封装 | 参考链接
1 | 1 | WJ2EDGR-5.08-2P | P1 | 弯针插件
2 | 1 | DB2ERC-2.54-8P | P2 | 弯针插件 | https://item.taobao.com/item.htm?id=654151269687&skuId=5078209140486
3 | 1 | DB2ERC-2.54-12P | P3 | 弯针插件 | https://item.taobao.com/item.htm?id=654151269687&skuId=5078209140478
全部是插件物料
