gqkhao/pcb-schematics/3020机器转接板/限位开关板.dxf

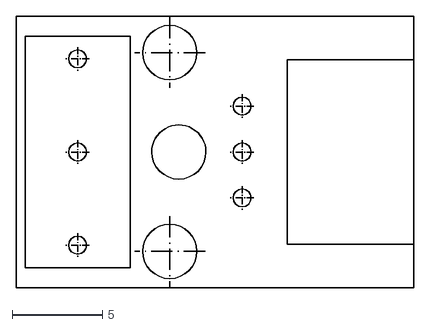
[picture p33: CAD file, 2026-09-07]
3020机器转接板/限位开关板.dxf
22.0 x 15.0
