gqkhao/pcb-schematics/3轴6.0--esp32/DXF_X限位_2025-09-17_AutoCAD2007.dxf

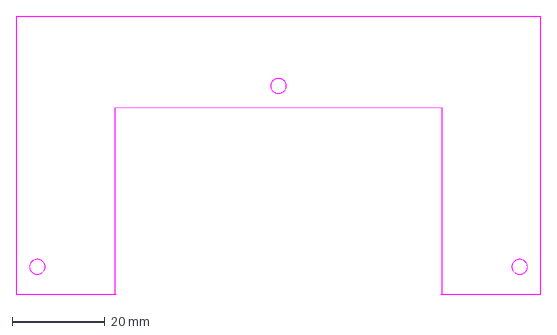
[picture p34: CAD file, 2026-09-07]
3轴6.0--esp32/DXF_X限位_2025-09-17_AutoCAD2007.dxf
113.1 x 60.1 mm
