gqkhao/pcb-schematics/4040M/DXF_PCB_2026-04-30_AutoCAD2007.dxf

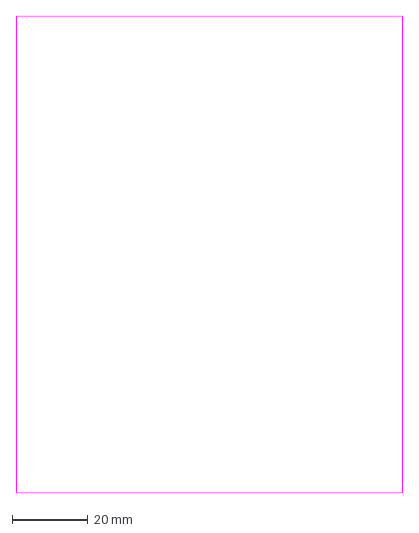
[picture p36: CAD file, 2026-09-07]
4040M/DXF_PCB_2026-04-30_AutoCAD2007.dxf
102.1 x 126.1 mm
