gqkhao/pcb-schematics/4轴3.0/DXF_4轴3.0_2025-04-28_AutoCAD2007.dxf

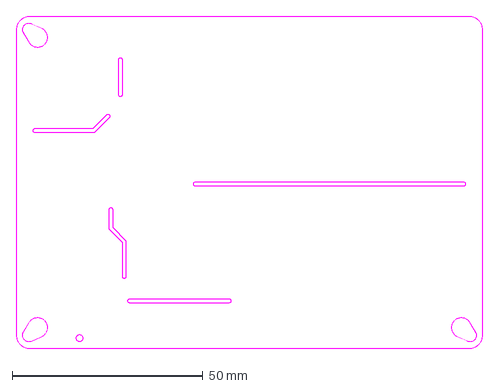
[picture p37: CAD file, 2026-09-07]
4轴3.0/DXF_4轴3.0_2025-04-28_AutoCAD2007.dxf
122.1 x 87.1 mm
