gqkhao/pcb-schematics/FluidNC/DXF__2025-12-15_包裹.dxf

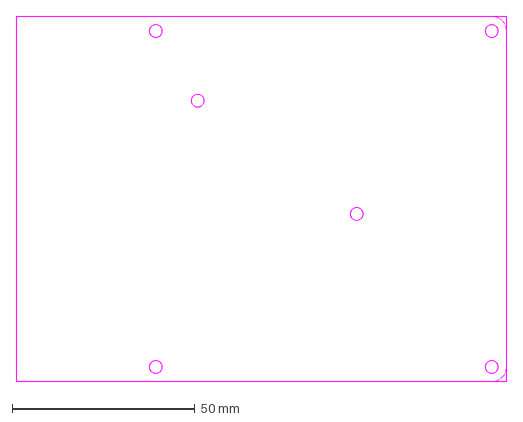
[picture p38: CAD file, 2026-09-07]
FluidNC/DXF__2025-12-15_包裹.dxf
134.1 x 100.0 mm
