gqkhao/pcb-schematics/三轴4.0控制板/LY-V10.DXF

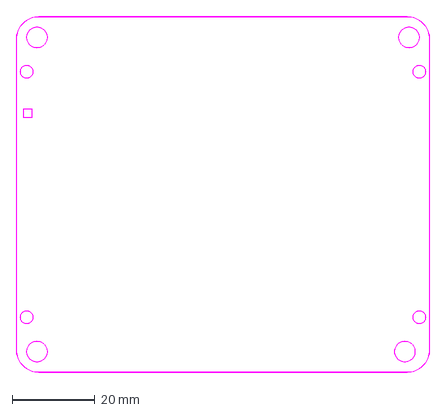
[picture p39: CAD file, 2026-09-07]
三轴4.0控制板/LY-V10.DXF
100.1 x 86.1 mm
