gqkhao/pcb-schematics/探针圆盘/钢球PCB.dxf

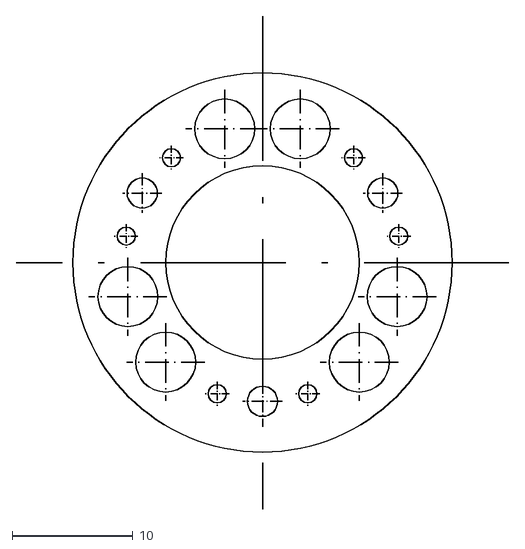
[picture p40: CAD file, 2026-09-07]
探针圆盘/钢球PCB.dxf
40.8 x 40.8
