gqkhao/pcb-schematics/电机驱动TB6600/DXF_无刷驱动板框_AutoCAD2007.dxf

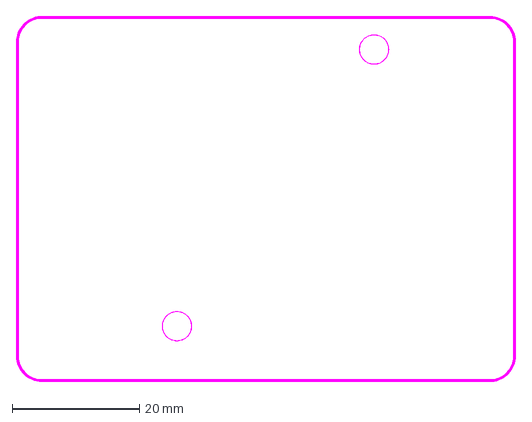
[picture p41: CAD file, 2026-09-07]
电机驱动TB6600/DXF_无刷驱动板框_AutoCAD2007.dxf
78.5 x 57.5 mm
