gqkhao/pcb-schematics/3020机器转接板/Z轴限位板.dxf

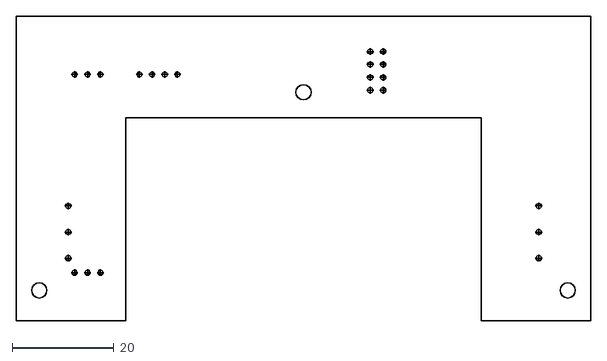
[picture p42: CAD file, 2026-09-07]
3020机器转接板/Z轴限位板.dxf
113.0 x 60.0
