gqkhao/pcb-schematics/3轴6.0--esp32/DXF_PCB_2025-09-17_AutoCAD2007.dxf

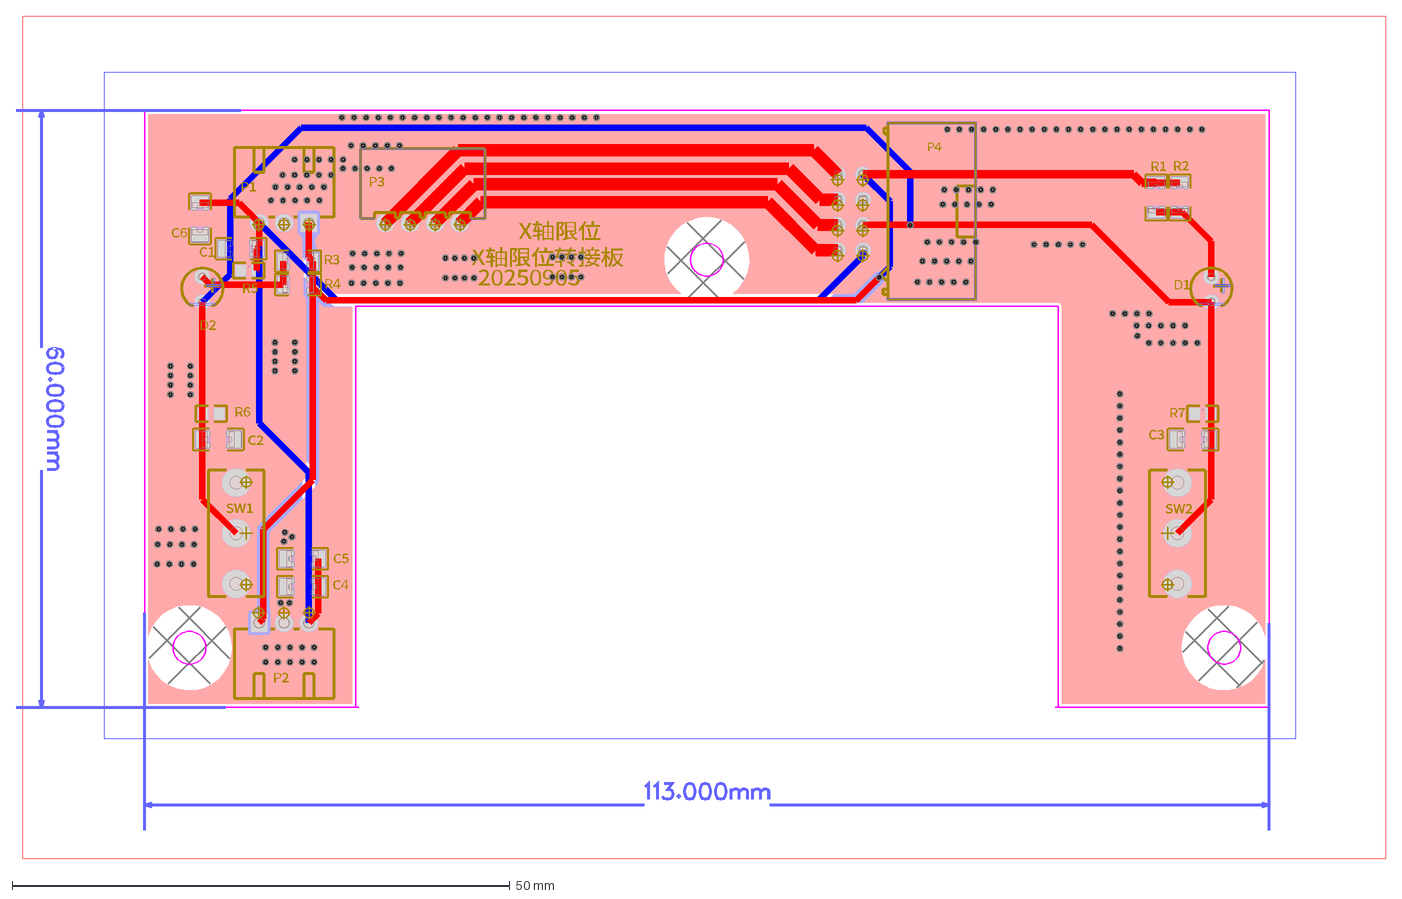
[picture p43: CAD file, 2026-09-07]
3轴6.0--esp32/DXF_PCB_2025-09-17_AutoCAD2007.dxf
20250905
X轴限位转接板
X轴限位
P1
P3
D1
D2
R4
R3
R2
R1
SW1
P2
SW2
P4
R5
R6
R7
C1
C2
C3
C4
C5
C6
