gqkhao/pcb-schematics/4040M/DXF_PCB_2026-04-29_AutoCAD2007.dxf

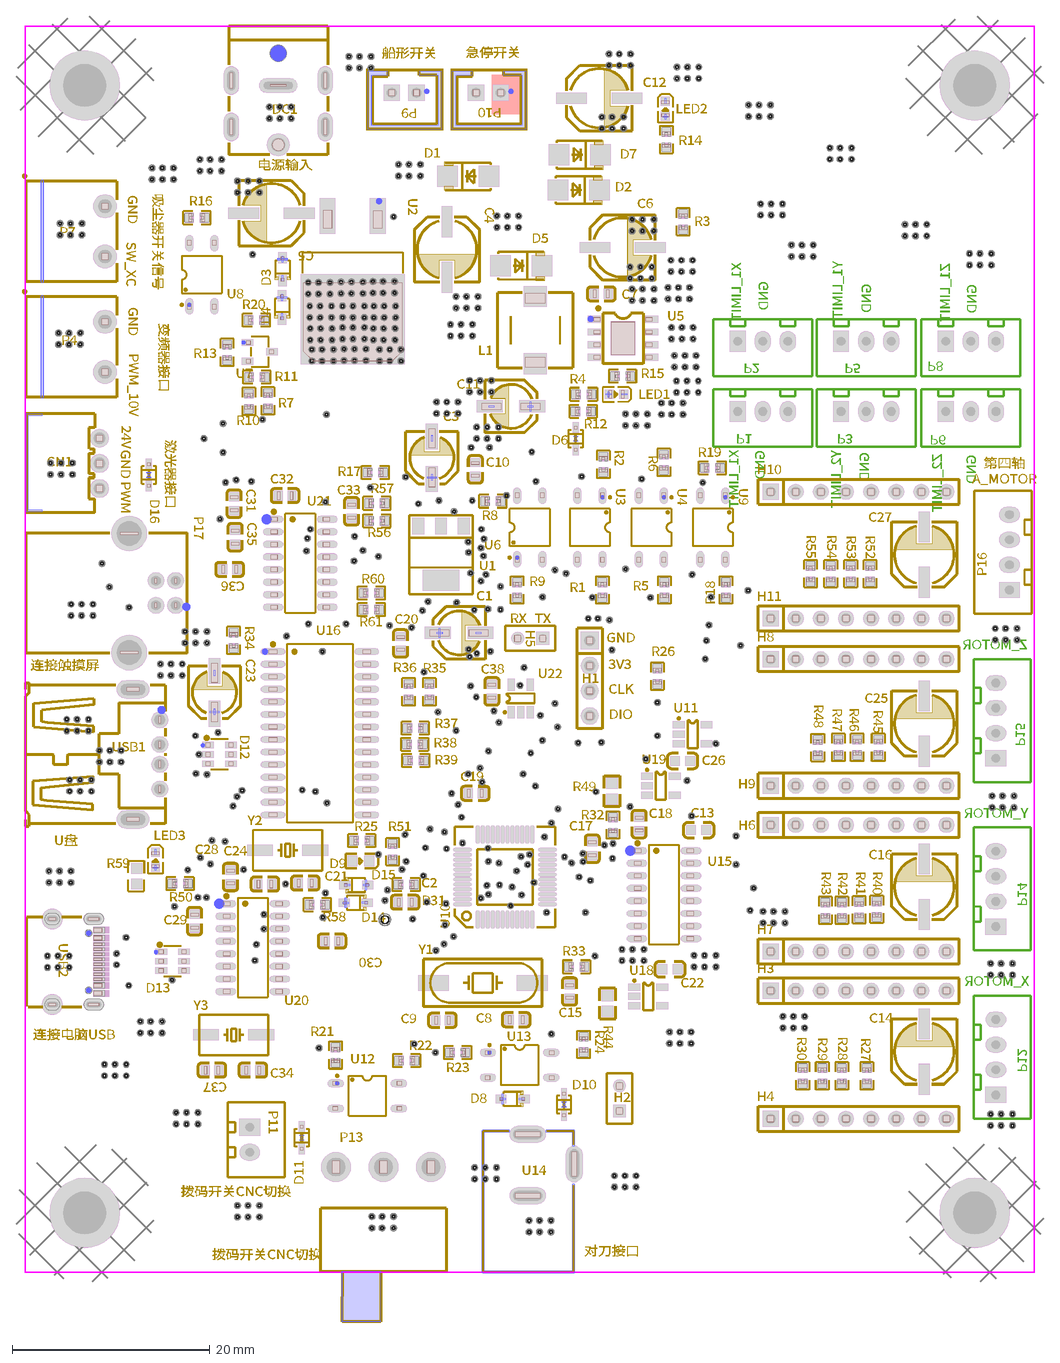
[picture p45: CAD file, 2026-09-07]
4040M/DXF_PCB_2026-04-29_AutoCAD2007.dxf
X1_LIMIT
Z1_LIMIT
Y1_LIMIT
Y2_LIMIT
Z2_LIMIT
GND
X_MOTOR
Y_MOTOR
Z_MOTOR
P1
P3
P5
P6
P8
P2
P14
P15
P12
连接电脑USB
连接触摸屏
U盘
电源输入
吸尘器开关信号
拨码开关CNC切换
变频器接口
对刀接口
激光器接口
24V
PWM
PWM_10V
SW_XC
第四轴
A_MOTOR
船形开关
急停开关
RX
TX
3V3
CLK
DIO
U1
U3
C3
D16
U9
U4
U13
C1
DC1
D5
D2
LED2
C6
U5
L1
LED1
C11
D6
D7
P17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
