gqkhao/pcb-schematics/探针圆盘/主PCB.dxf

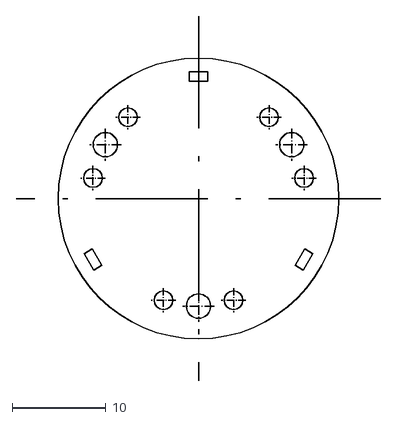
[picture p48: CAD file, 2026-09-07]
探针圆盘/主PCB.dxf
39.0 x 39.0
