gqkhao/pcb-schematics/3020机器转接板/Y限位.dxf

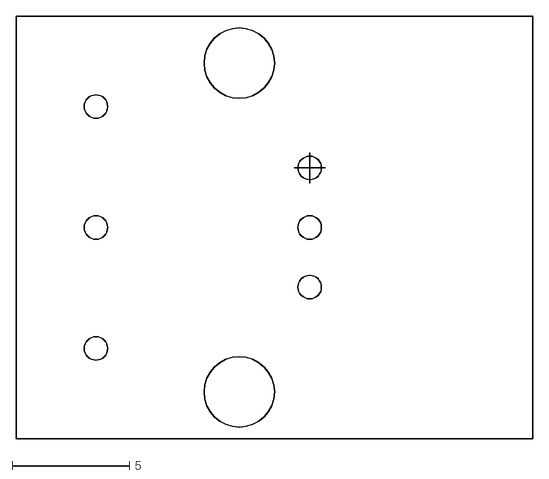
[picture p49: CAD file, 2026-09-07]
3020机器转接板/Y限位.dxf
22.0 x 18.0
