gqkhao/pcb-schematics/3轴6.0--esp32/DXF_PCB_2025-09-03_AutoCAD2007.dxf

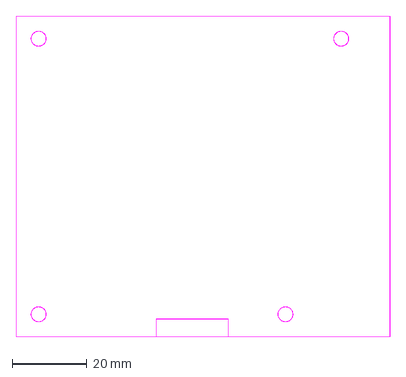
[picture p50: CAD file, 2026-09-07]
3轴6.0--esp32/DXF_PCB_2025-09-03_AutoCAD2007.dxf
100.0 x 85.8 mm
