gqkhao/pcb-schematics/4040lite转接板/激光转接板(1).dxf

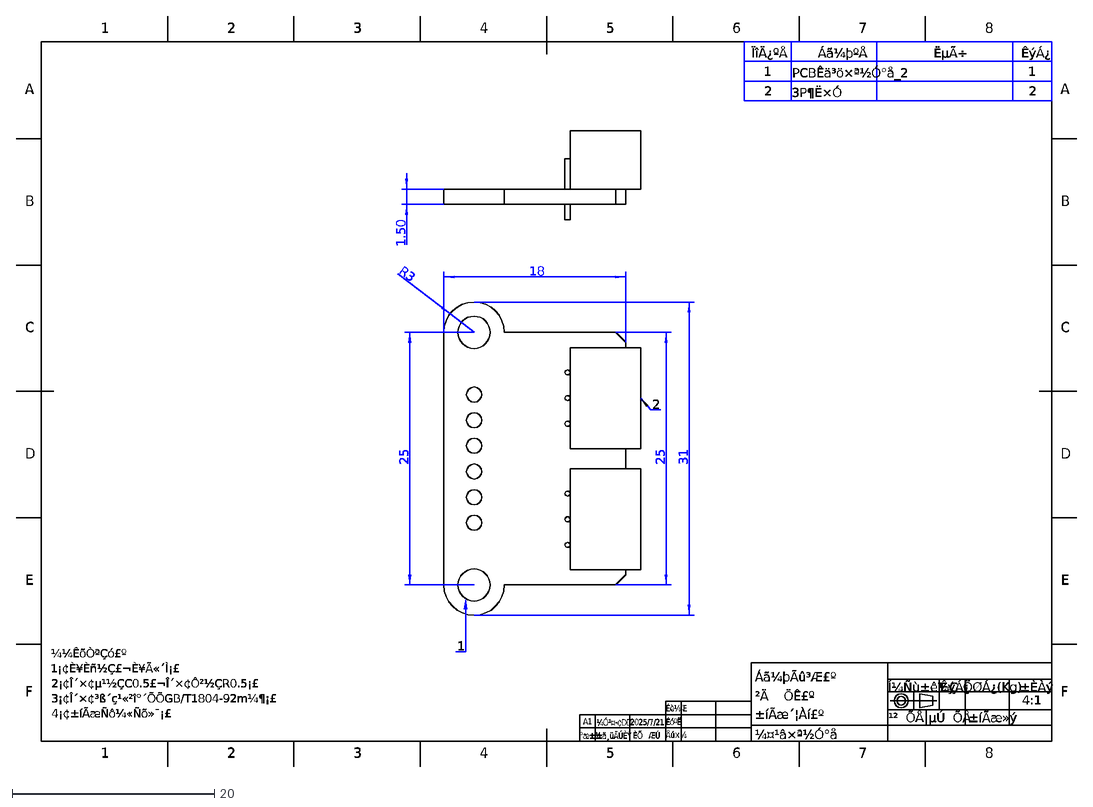
[picture p51: CAD file, 2026-09-07]
4040lite转接板/激光转接板(1).dxf
技术要求：
1、去锐角，去毛刺。
2、未注倒角C0.5，未注圆角R0.5。
3、未注尺寸公差按照GB/T1804-92m级。
4、表面阳极氧化。
A1
审核
变更内容
设计
日 期
加工发行
批准
版本
2025/7/21
第 张
共 张
4:1
比例
零件名称：
材 质：
重量(Kg)
图样标记
表面积
表面处理：
数量
激光转接板
F
E
D
C
B
A
1
2
3
4
5
6
7
8
项目号
零件号
说明
PCB输出转接板_2
3P端子
25
18
31
R3
1.50
