gqkhao/pcb-schematics/FluidNC/DXF_PCB_2026-04-30_AutoCAD.dxf

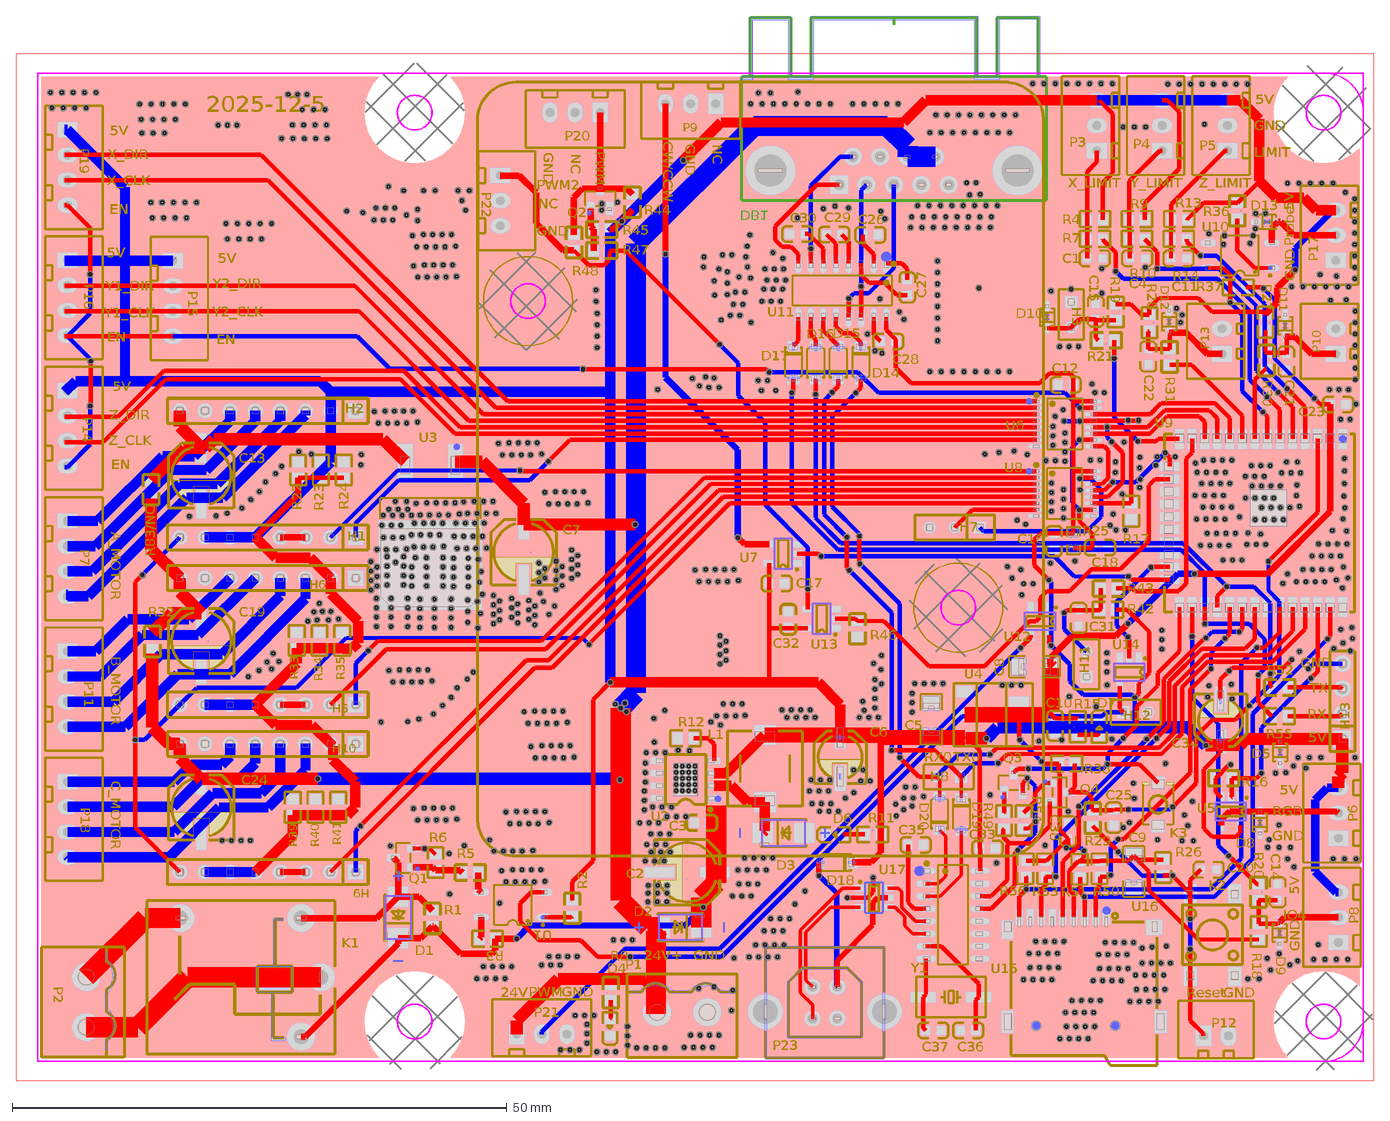
[picture p52: CAD file, 2026-09-07]
FluidNC/DXF_PCB_2026-04-30_AutoCAD.dxf
DB1
X_LIMIT
Y_LIMIT
Z_LIMIT
LIMIT
GND
5V
Reset
IO4
Probe
RGB
TX
RX
RX0
TX0
EN
X_CLK
X_DIR
PWM2
24V+
PWM
24V
Y1_DIR
Y1_CLK
Y2_DIR
Y2_CLK
Z_DIR
Z_CLK
CW/CCW
NC
A_MOTOR
B_MOTOR
C_MOTOR
2025-12-5
C10
C8
C9
C5
C3
C35
C36
C37
C33
C38
C1
C4
C11
D9
D3
D5
D2
D4
K2
L1
P3
P12
P4
Q4
Q3
R7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
