gqkhao/pcb-schematics/主轴转接板/A轴电机预埋线_1.DXF

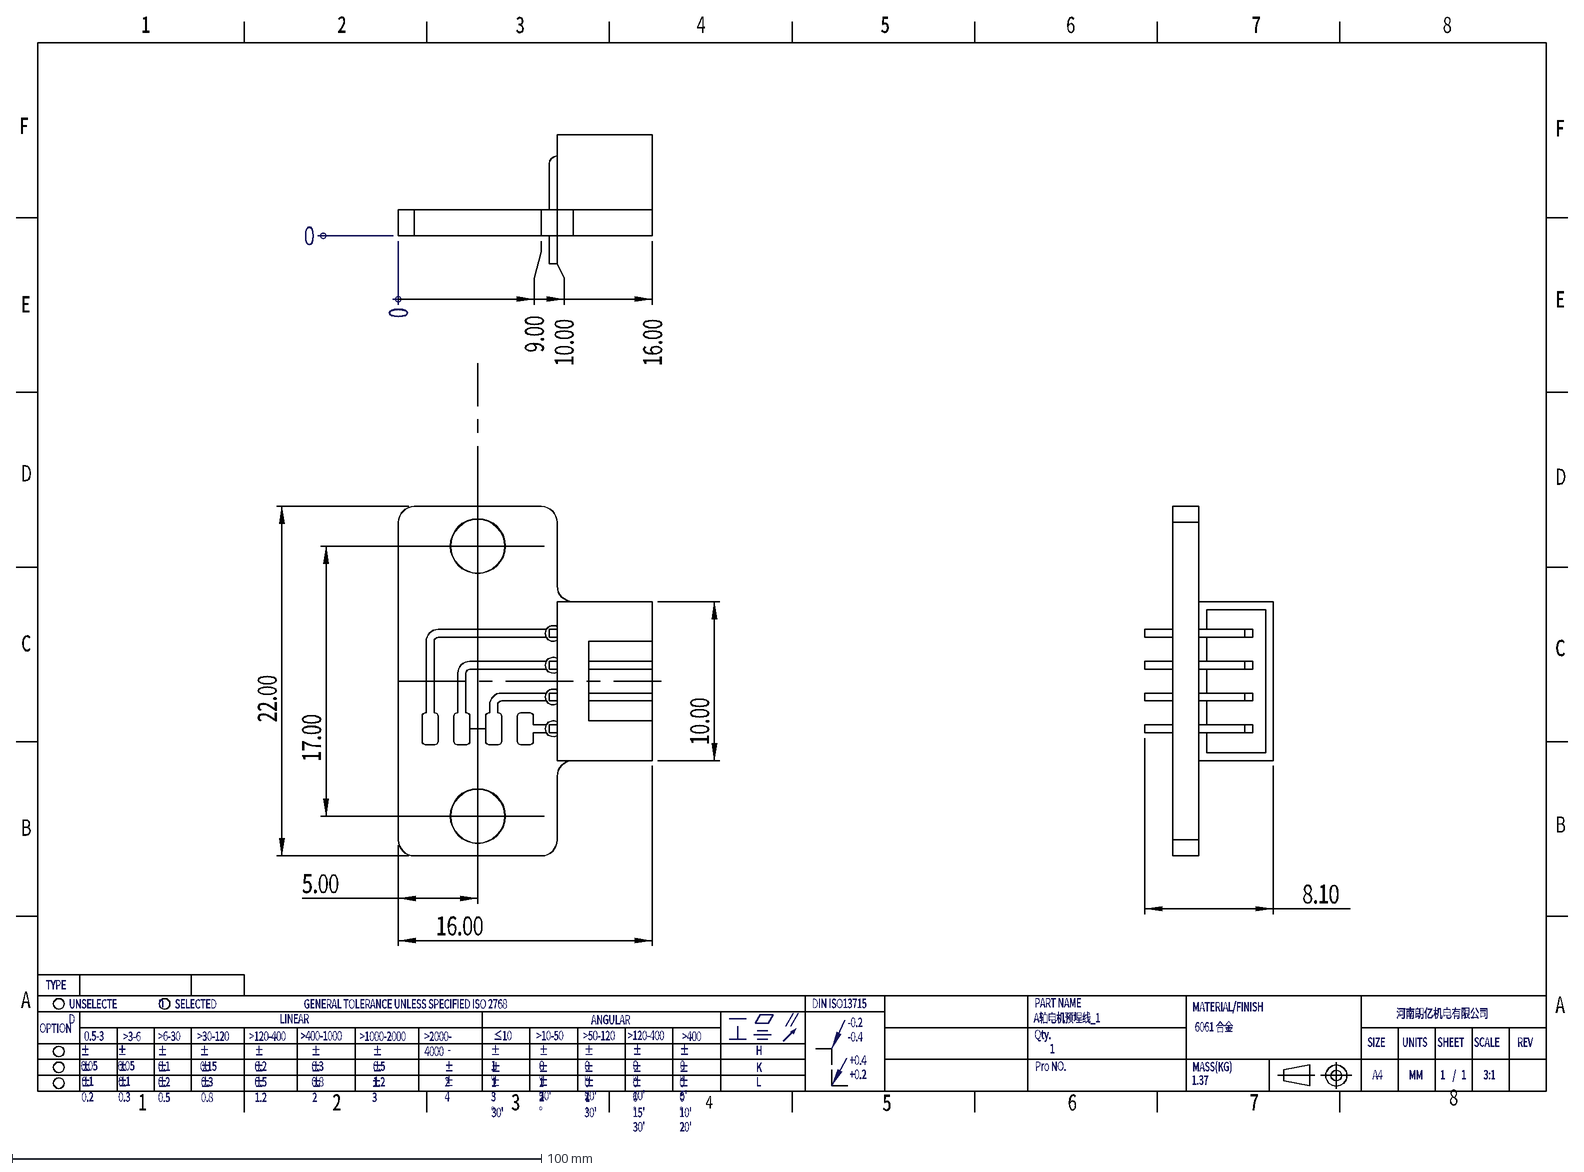
[picture p53: CAD file, 2026-09-07]
主轴转接板/A轴电机预埋线_1.DXF
1
2
3
4
5
6
7
8
A
B
C
E
F
D
MATERIAL/FINISH
Qty.
SIZE
UNITS
SHEET
SCALE
REV
MM
A4
MASS(KG)
GENERAL TOLERANCE UNLESS SPECIFIED ISO 2768
≤10
Pro NO.
3:1
/
1.37
± 3 °
± 1 °
± 0 ° 20'
± 0 ° 30'
LINEAR
>3-6
>6-30
>30-120
>120-400
>10-50
± 0.05
± 0.1
± 0.2
± 0.3
± 0.5
± 0.15
± 0.8
± 1.2
± 2
± 3
± 2 °
± 0 ° 10'
± 1 ° 30'
± 0 ° 5'
OPTION
TYPE
PART NAME
>400
L
H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
