gqkhao/pcb-schematics/3020机器转接板/XZ转接板.dxf

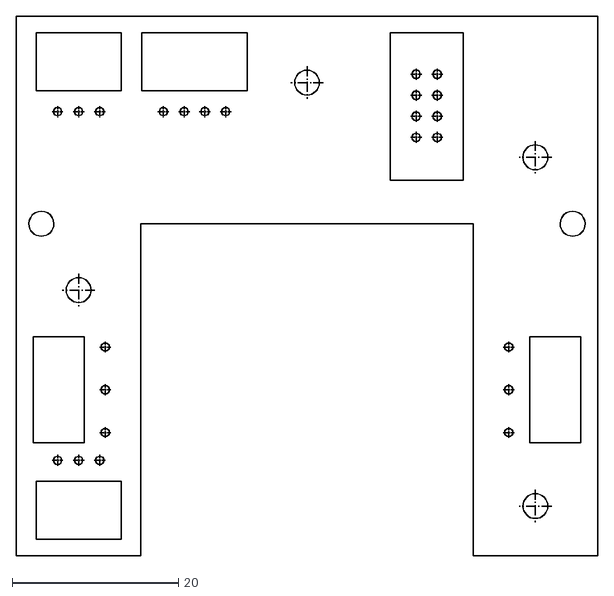
[picture p55: CAD file, 2026-09-07]
3020机器转接板/XZ转接板.dxf
70.0 x 65.0
