gqkhao/pcb-schematics/3020-2.0包裹款/主轴照明灯PCB板.dxf

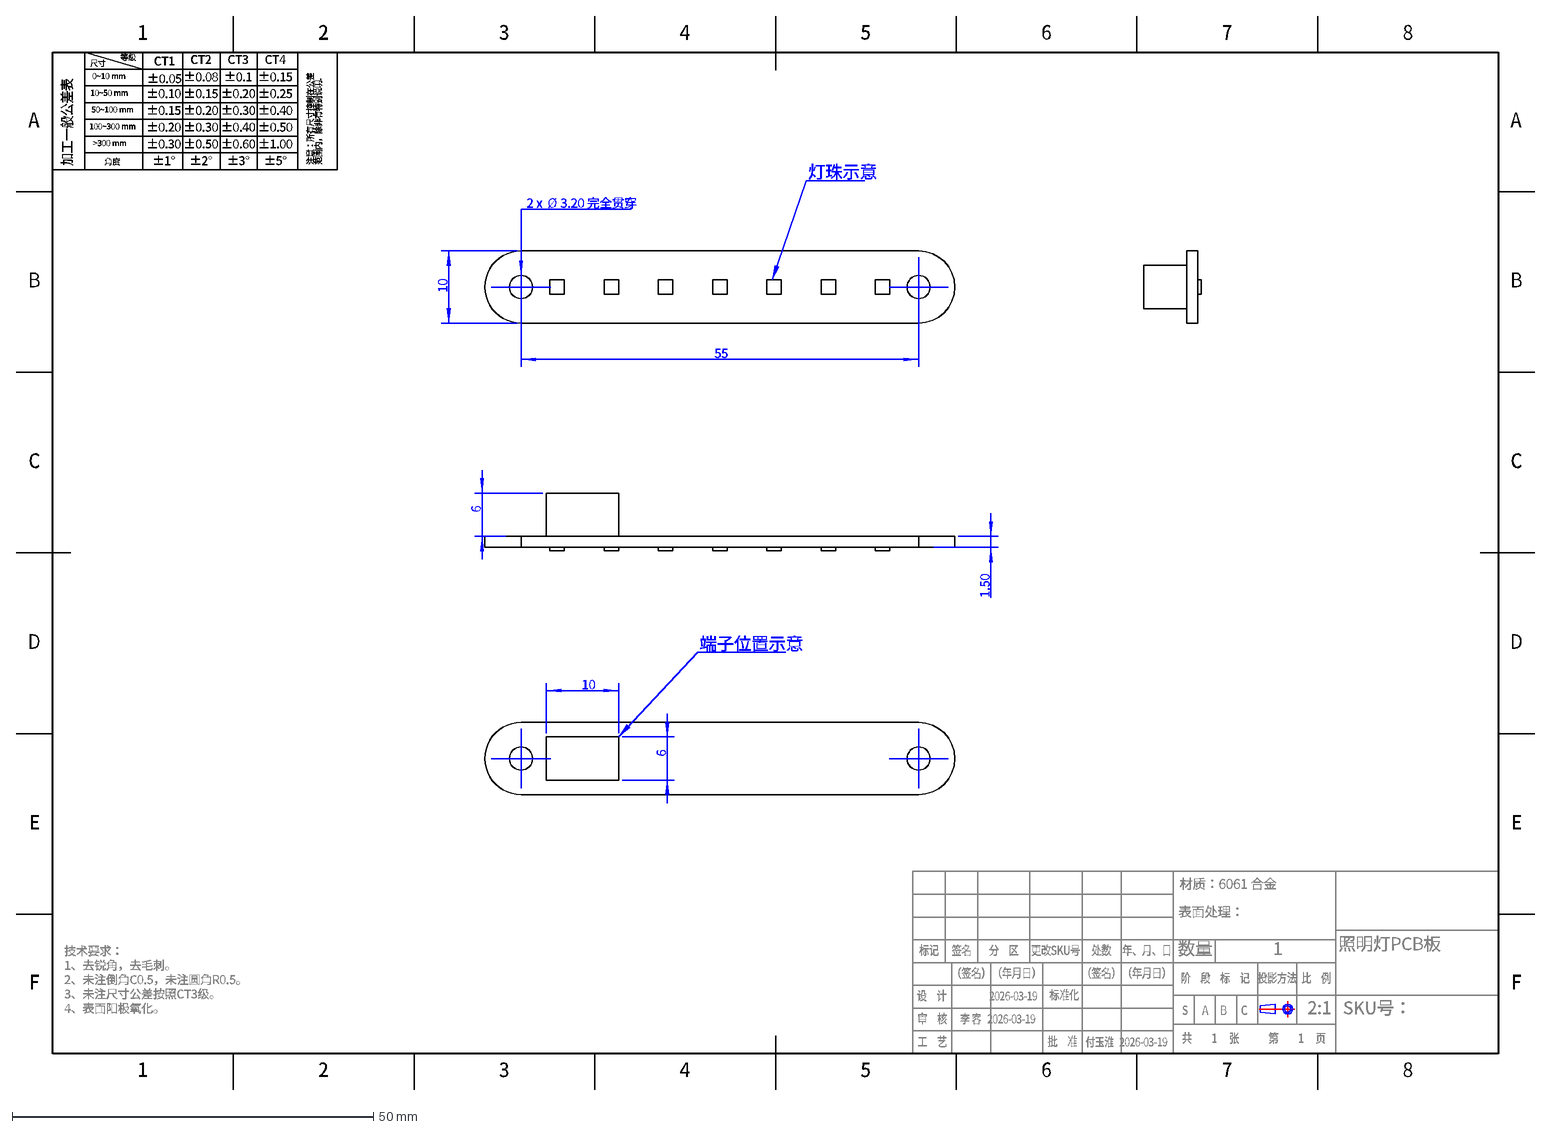
[picture p58: CAD file, 2026-09-07]
3020-2.0包裹款/主轴照明灯PCB板.dxf
±0.60
±0.40
±3°
±5°
±1.00
±0.50
±0.20
±0.30
±0.1
±0.15
±0.25
CT3
CT4
±0.10
±0.05
>300 mm
100~300 mm
角度
10~50 mm
50~100 mm
0~10 mm
尺寸
等级
±2°
±1°
±0.08
CT1
CT2
加工一般公差表
注意：所有尺寸控制在公差
范围内，除非有特别说明.
2:1
SKU号：
1
数量
照明灯PCB板
技术要求： 1、去锐角，去毛刺。 2、未注倒角C0.5，未注圆角R0.5。 3、未注尺寸公差按照CT3级。 4、表面阳极氧化。
S A B C
（签名）
（年月日）
共 1 张 第 1 页
比 例
投影方法
阶 段 标 记
批 准
工 艺
审 核
设 计
标准化
年、月、日
签名
更改SKU号
分 区
处数
标记
表面处理：
材质：6061 合金
F
E
D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
