gqkhao/pcb-schematics/3020机器转接板/DXF_PCB_2025-06-04_AutoCAD2007.dxf

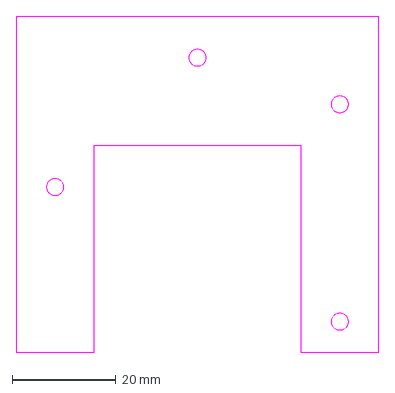
[picture p59: CAD file, 2026-09-07]
3020机器转接板/DXF_PCB_2025-06-04_AutoCAD2007.dxf
70.1 x 65.1 mm
