gqkhao/pcb-schematics/3轴6.0--esp32/DXF_ESP32-AXIS3-6.0_.dxf

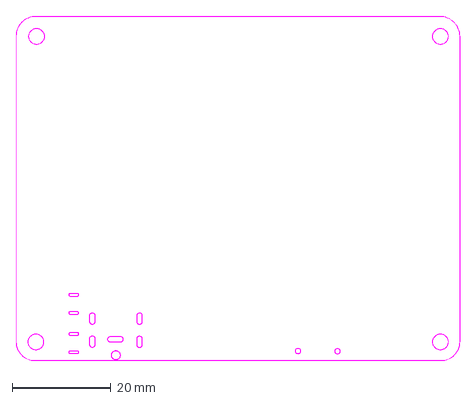
[picture p60: CAD file, 2026-09-07]
3轴6.0--esp32/DXF_ESP32-AXIS3-6.0_.dxf
90.1 x 70.0 mm
