gqkhao/pcb-schematics/4040lite转接板/主轴转接板.dxf

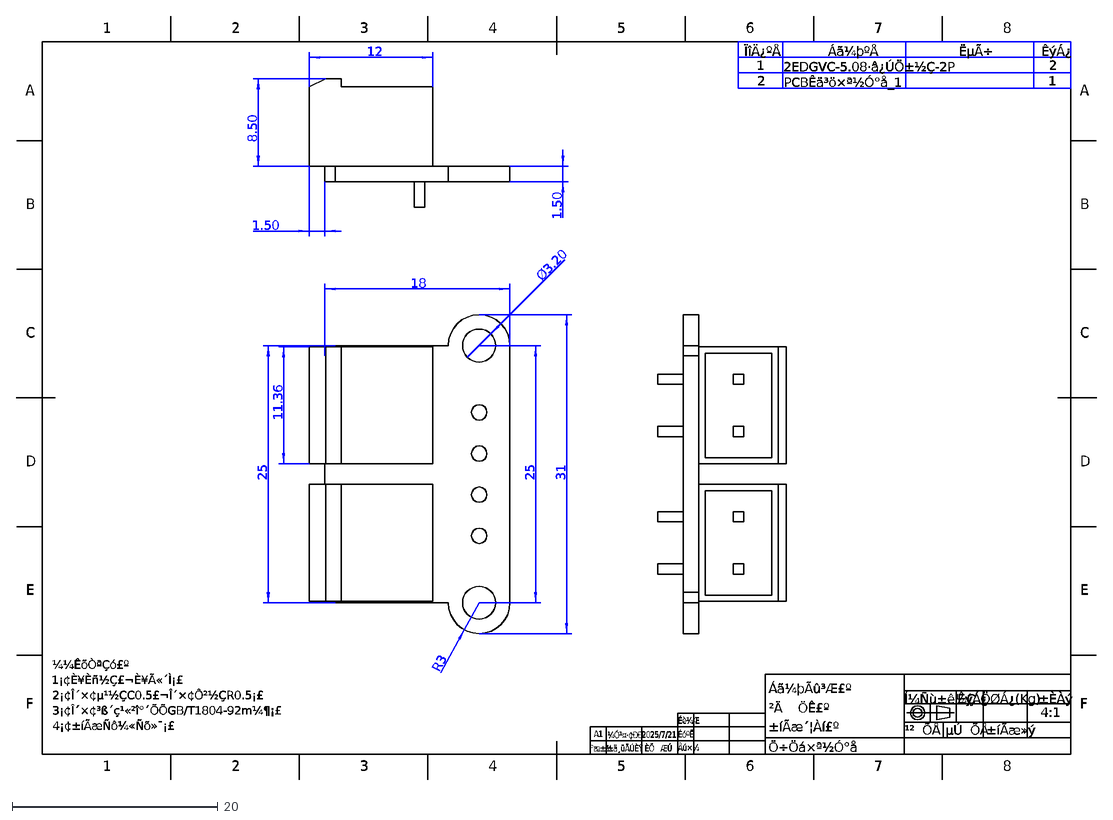
[picture p61: CAD file, 2026-09-07]
4040lite转接板/主轴转接板.dxf
¼¼ÊõÒªÇó£º
1¡¢È¥Èñ½Ç£¬È¥Ã«´Ì¡£
2¡¢Î´×¢µ¹½ÇC0.5£¬Î´×¢Ô²½ÇR0.5¡£
3¡¢Î´×¢³ß´ç¹«²î°´ÕÕGB/T1804-92m¼¶¡£
4¡¢±íÃæÑô¼«Ñõ»¯¡£
A1
ÉóºË
±ä¸üÄÚÈÝ
Éè¼Æ
ÈÕ ÆÚ
¼Ó¹¤·¢ÐÐ
Åú×¼
°æ±¾
2025/7/21
µÚ ÕÅ
¹² ÕÅ
4:1
±ÈÀý
Áã¼þÃû³Æ£º
²Ä ÖÊ£º
ÖØÁ¿(Kg)
Í¼Ñù±ê¼Ç
±íÃæ»ý
±íÃæ´¦Àí£º
ÊýÁ¿
Ö÷Öá×ª½Ó°å
F
E
D
C
B
A
1
2
3
4
5
6
7
8
ÏîÄ¿ºÅ
Áã¼þºÅ
ËµÃ÷
2EDGVC-5.08·â¿ÚÖ±½Ç-2P
PCBÊä³ö×ª½Ó°å_1
25
18
31
Ø
3.20
R3
11.36
1.50
8.50
12
