gqkhao/pcb-schematics/3020-2.0包裹款/DXF_摄像头板框_2026-03-27_AutoCAD2007.dxf

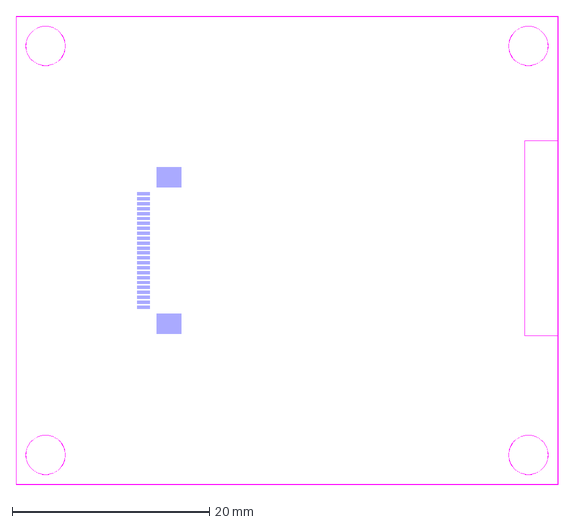
[picture p62: CAD file, 2026-09-07]
3020-2.0包裹款/DXF_摄像头板框_2026-03-27_AutoCAD2007.dxf
55.0 x 47.5 mm
