gqkhao/pcb-schematics/4040lite转接板/X转接板.dxf

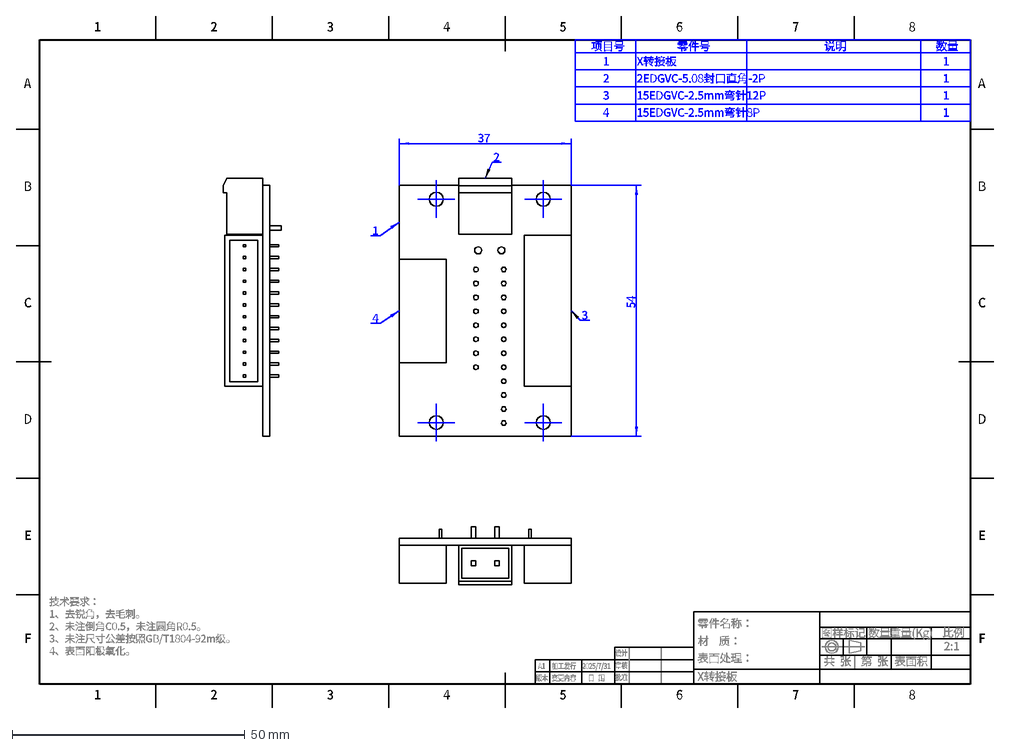
[picture p64: CAD file, 2026-09-07]
4040lite转接板/X转接板.dxf
技术要求： 1、去锐角，去毛刺。 2、未注倒角C0.5，未注圆角R0.5。 3、未注尺寸公差按照GB/T1804-92m级。 4、表面阳极氧化。
A1
审核
变更内容
设计
日 期
加工发行
批准
版本
2025/7/31
第 张
共 张
2:1
比例
零件名称：
材 质：
重量(Kg)
图样标记
表面积
表面处理：
数量
X转接板
F
E
D
C
B
A
1
2
3
4
5
6
7
8
项目号
零件号
说明
2EDGVC-5.08封口直角-2P
15EDGVC-2.5mm弯针12P
15EDGVC-2.5mm弯针8P
37
54
