gqkhao/pcb-schematics/3020-2.0包裹款/DXF_摄像头_2026-03-12_AutoCAD2007.dxf

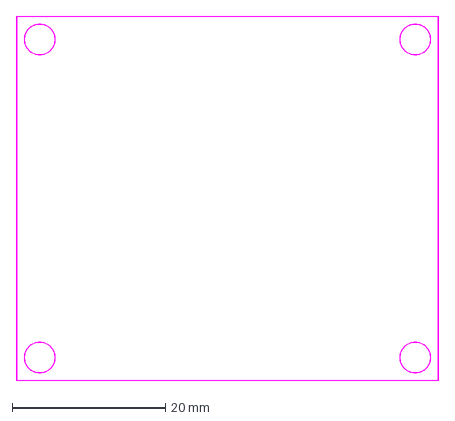
[picture p65: CAD file, 2026-09-07]
3020-2.0包裹款/DXF_摄像头_2026-03-12_AutoCAD2007.dxf
55.1 x 47.6 mm
