gqkhao/pcb-schematics/4040lite转接板/X转接板 - 4040.dxf

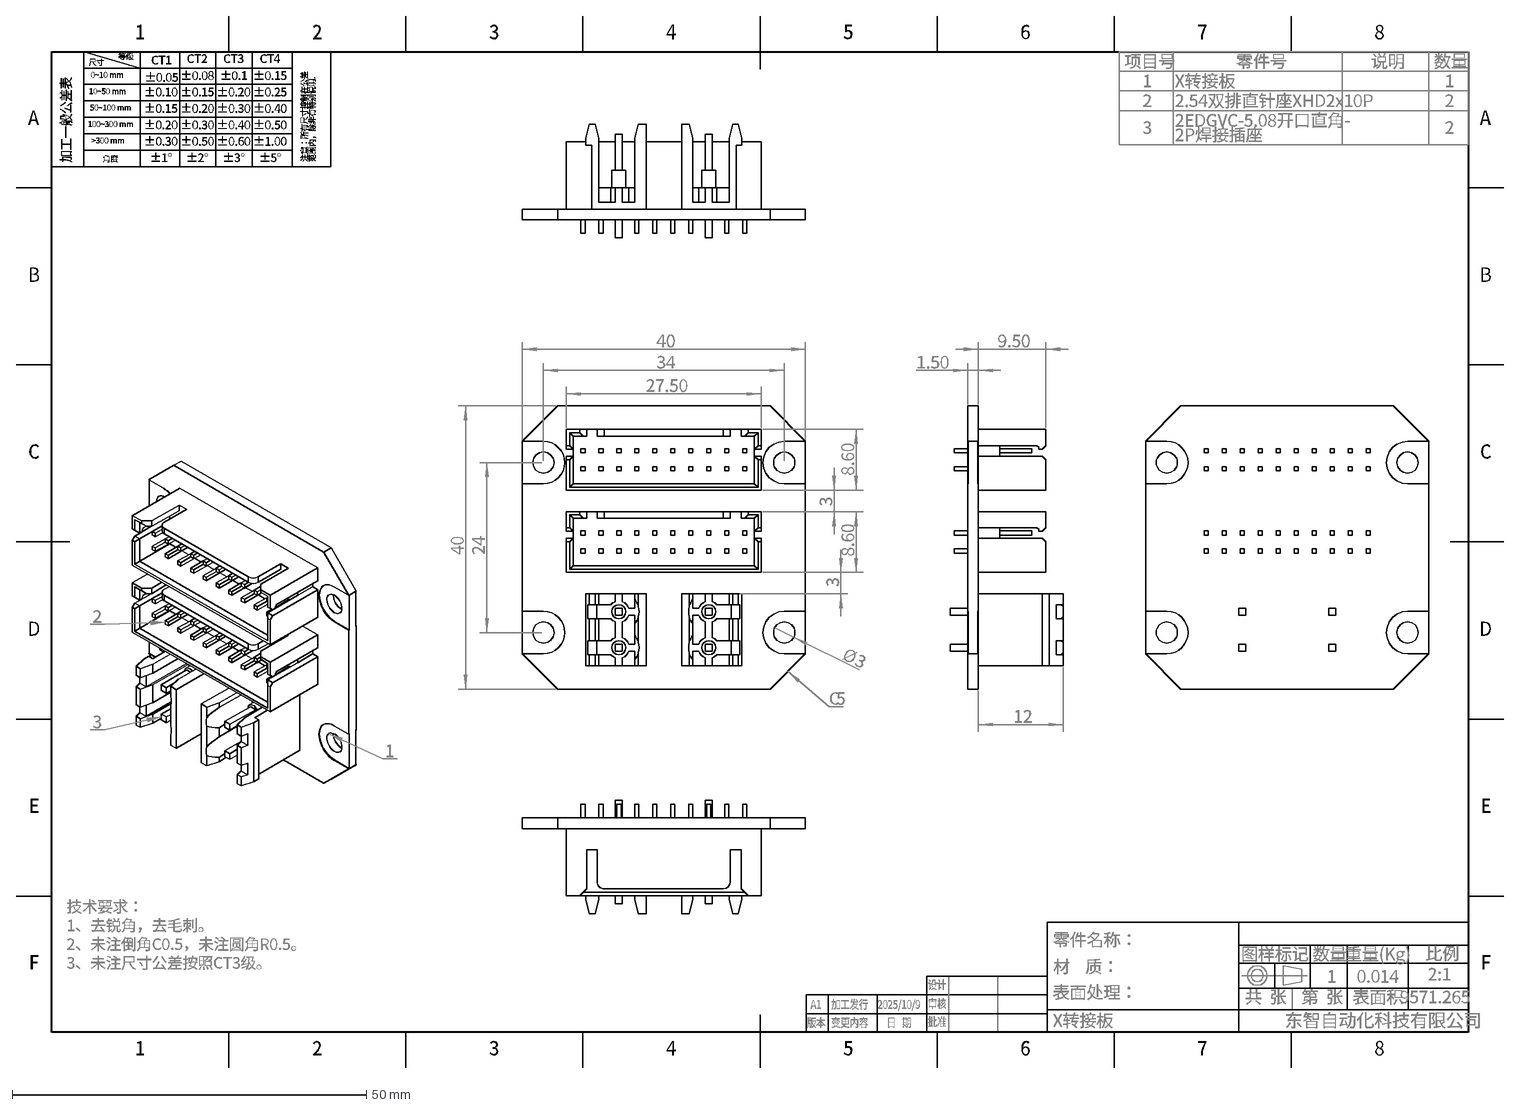
[picture p66: CAD file, 2026-09-07]
4040lite转接板/X转接板 - 4040.dxf
±0.60
±0.40
±3°
±5°
±1.00
±0.50
±0.20
±0.30
±0.1
±0.15
±0.25
CT3
CT4
±0.10
±0.05
>300 mm
100~300 mm
角度
10~50 mm
50~100 mm
0~10 mm
尺寸
等级
±2°
±1°
±0.08
CT1
CT2
加工一般公差表
注意：所有尺寸控制在公差
范围内，除非有特别说明.
技术要求： 1、去锐角，去毛刺。 2、未注倒角C0.5，未注圆角R0.5。 3、未注尺寸公差按照CT3级。
9571.265
A1
审核
变更内容
设计
日 期
加工发行
批准
版本
2025/10/9
第 张
共 张
2:1
比例
零件名称：
材 质：
1
重量(Kg)
东智自动化科技有限公司
图样标记
表面积
0.014
表面处理：
数量
X转接板
F
E
D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
