gqkhao/pcb-schematics/3020-2.0包裹款/DXF_主板_2026-03-12_AutoCAD2007.dxf

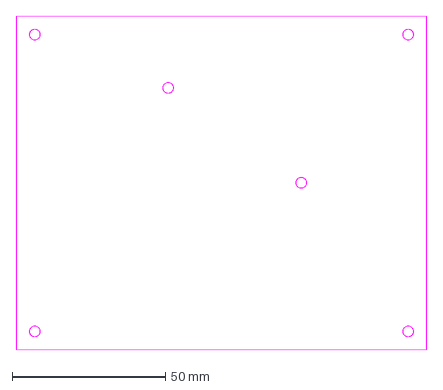
[picture p67: CAD file, 2026-09-07]
3020-2.0包裹款/DXF_主板_2026-03-12_AutoCAD2007.dxf
134.1 x 109.1 mm
