gqkhao/pcb-schematics/4040lite转接板/DXF_PCB_2025-09-12_AutoCAD2007.dxf

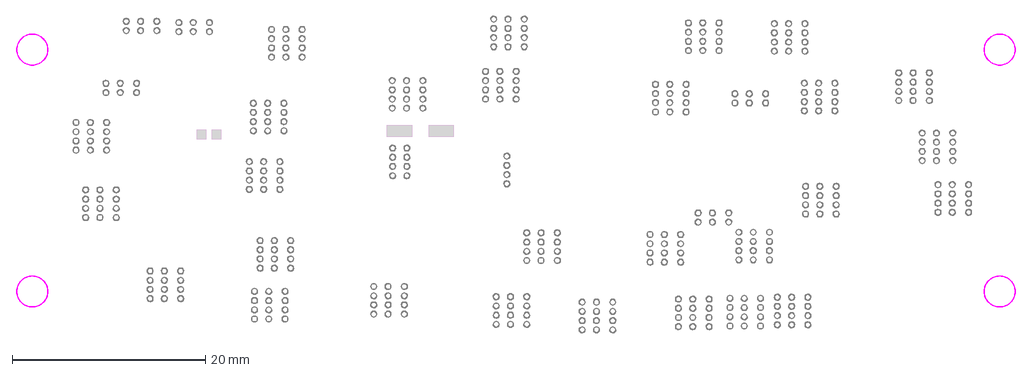
[picture p69: CAD file, 2026-09-07]
4040lite转接板/DXF_PCB_2025-09-12_AutoCAD2007.dxf
103.3 x 32.7 mm
