gqkhao/pcb-schematics/(list of files, cad)

Other CAD files:
3020-2.0包裹款/照明灯PCB板.DWG
4040lite转接板/PCB转接板/激光转接板.DWG
主轴转接板/电路板2.DXF
3020-2.0包裹款/孔位1.dxf
4040lite转接板/PCB转接板/主轴转接板.DWG
3020-2.0包裹款/孔位.dwg
4040lite转接板/PCB转接板/X转接板.DWG
3020-2.0包裹款/刀仓PCB灯光板.dwg
3020机器转接板/DXF_PCB_+2025-06-04_AutoCAD2007.dxf
4040lite转接板/PCB转接板.DWG
4040lite转接板/X转接板 - 4040.DWG
4040lite转接板/X转接板.DWG
4040lite转接板/激光主轴转接板.DWG
4040lite转接板/电机线限位线中继板.DWG
FluidNC/DXF_PCB-_2026-04-30_AutoCAD.dxf
