gqkhao/pcb-schematics/探针圆盘/AC_KEY_V1_2018-001_A3_Schematic.pdf

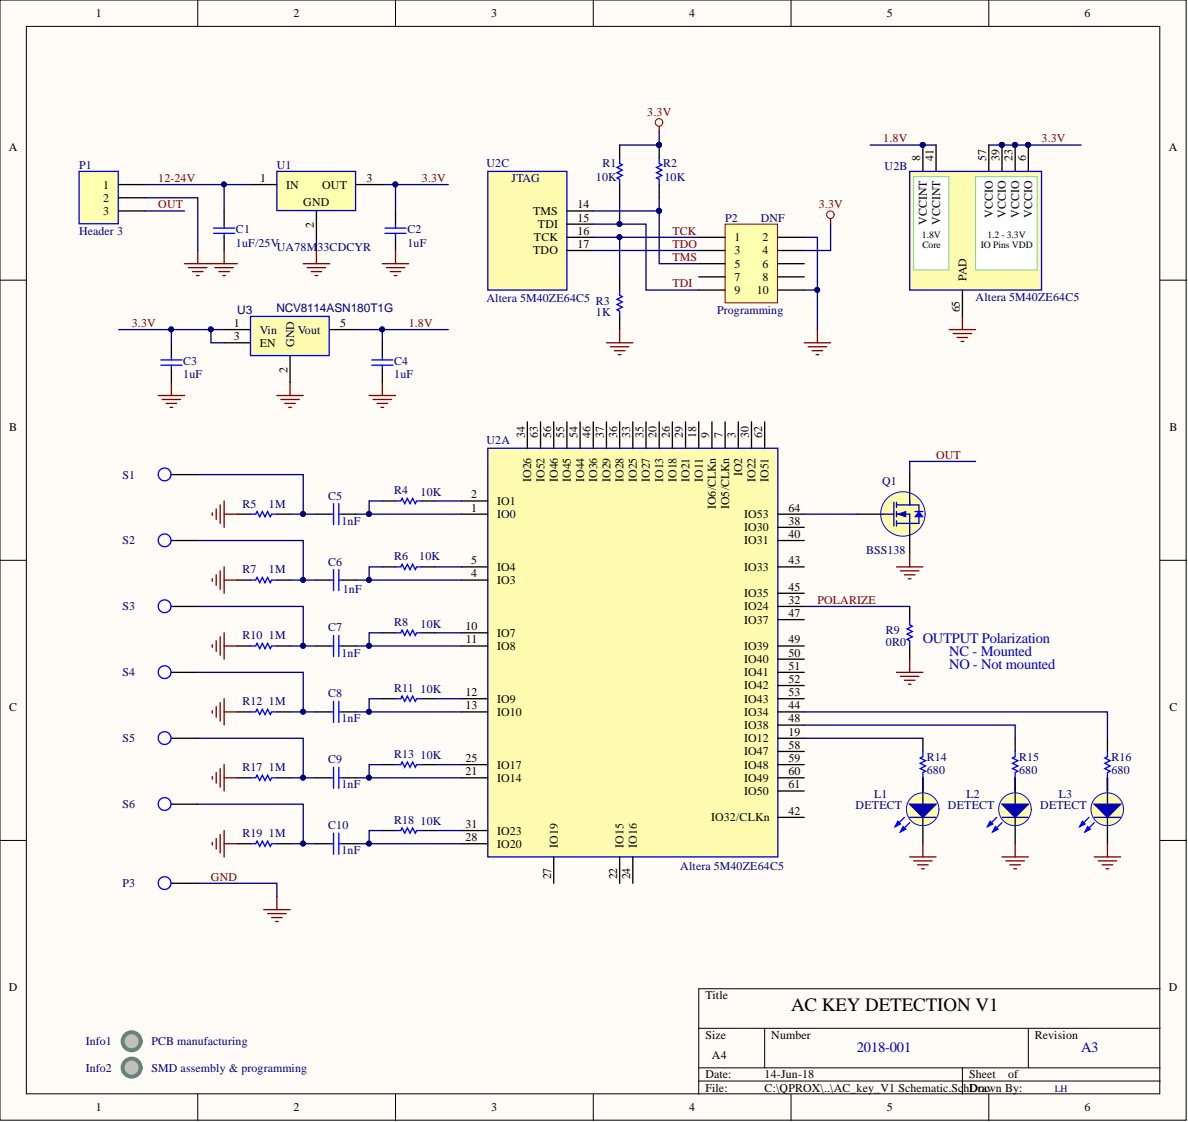
[picture p70: page 1]

VCCIO 6 VCCIO 23 VCCIO 39 VCCIO 57

TDO
TMS

1.8V Core | 1.2 - 3.3V IO Pins VDD

Bill of Materials | AC KEY V1

### Source Data From: AC_key_V1.PrjPcb

### PCB Part Number: 2018-001

### Variant: A3

| Creation Date: 12:25:51 PM
| Designator | Comment | Footprint | Description | Manufacturer | Manufacturer Part Number | Supplier | SuppNumber | Quantity | Price | Total EURO
1 | C1 | 1uF/25V | 3-0603-CAP | Capacitor | | | Farnell | | 1 | 0.10 | 0.10
2 | C2, C3, C4 | 1uF | 3-0603-CAP | Capacitor | | | Farnell | | 3 | 0.10 | 0.30
3 | C5, C6, C7, C8, C9, C10 | 1nF | 3-0603-CAP | Capacitor | | | Farnell | | 6 | 0.10 | 0.60
4 | Info1 | PCB manufacturing | | | | | Vi&Rus - BG | | 1 | 1.50 | 1.50
5 | Info2 | SMD assembly & programming | | | | | Vi&Rus | | 1 | 1.50 | 1.50
6 | L1, L2, L3 | LED red 0603 right angle | 3-0603-LED RED RIGHT ANGLE | LED red 0603 right angle ultrabright | ROHM | SML-D15MWT86C | Farnell | 2146470 | 3 | 0.26 | 0.78
7 | P1 | Header 3 | Header DR1X3 | Header, 3-Pin | | | Farnell | | 1 | 0.20 | 0.20
8 | P2 | DNF | MHDR2X5 | Header, 5-Pin, Dual row | | | | | 1 | 0.10 | 0.10
9 | P3, S1, S2, S3, S4, S5, S6 | Pad | PIN1 round | Pad | | | Farnell | | 7 | | 0.00
10 | Q1 | BSS138 | SOT23-3 | N-Channel Enhancement Mode Vertical DMOS FET | | | Mouser | 512-BSS138L | 1 | 0.13 | 0.13
11 | R1, R2, R4, R6, R8, R11, R13, R18 | 10K | 3-0603-RES | Resistor | | | MT1 | | 8 | 0.01 | 0.08
12 | R3 | 1K | 3-0603-RES | Resistor | | | MT1 | | 1 | 0.01 | 0.01
13 | R5, R7, R10, R12, R17, R19 | 1M | 3-0603-RES | Resistor | | | MT1 | | 6 | 0.01 | 0.06
14 | R9 | 0R0 | 3-0603-RES | Resistor | | | MT1 | | 1 | 0.01 | 0.01
15 | R14, R15, R16 | 680 | 3-0603-RES | Resistor 680R 0603 1% | PANASONIC | ERJ3EKF6800V | Farnell | 2303131 | 3 | 0.01 | 0.03
16 | U1 | UA78M33CDCYR | SOT223 | Linear 500mA Regulator | | | Mouser | 595-UA78M33CDCYR | 1 | | 0.00
17 | U2 | Altera 5M40ZE64C5 | EQFP64 | Altera 5M40ZE64C5 - 64 pin CPLD | | | Farnell | 2100802 | 1 | 1.20 | 1.20
18 | U3 | NCV8114ASN180T1G | SOT23-5 | VOLT REG LD6806 with ficed output 1.8V | | | Mouser | 863-NCV8114ASN180 T1G | 1 | 0.22 | 0.22
Approved | | Notes | | | | | | TOTAL | 47 | | 6.82

### Print Date: 12:26:00 PM

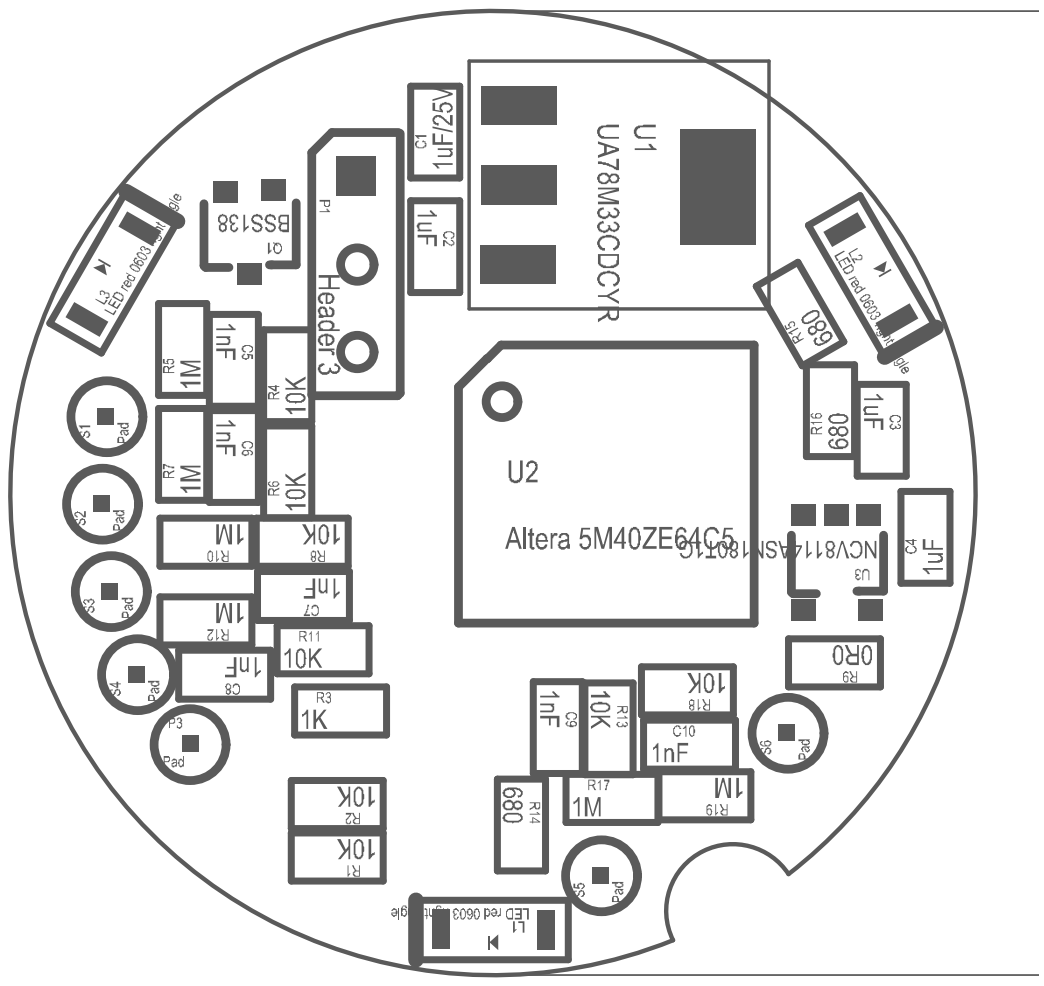
[picture p71: page 3]
