gqkhao/pcb-schematics/001发采购/4轴5.0控制板（BOM要求和pcb）_2025-09-10/四轴5.0控制板-原理图.pdf

## 103 ³V³

## 103 ³V³

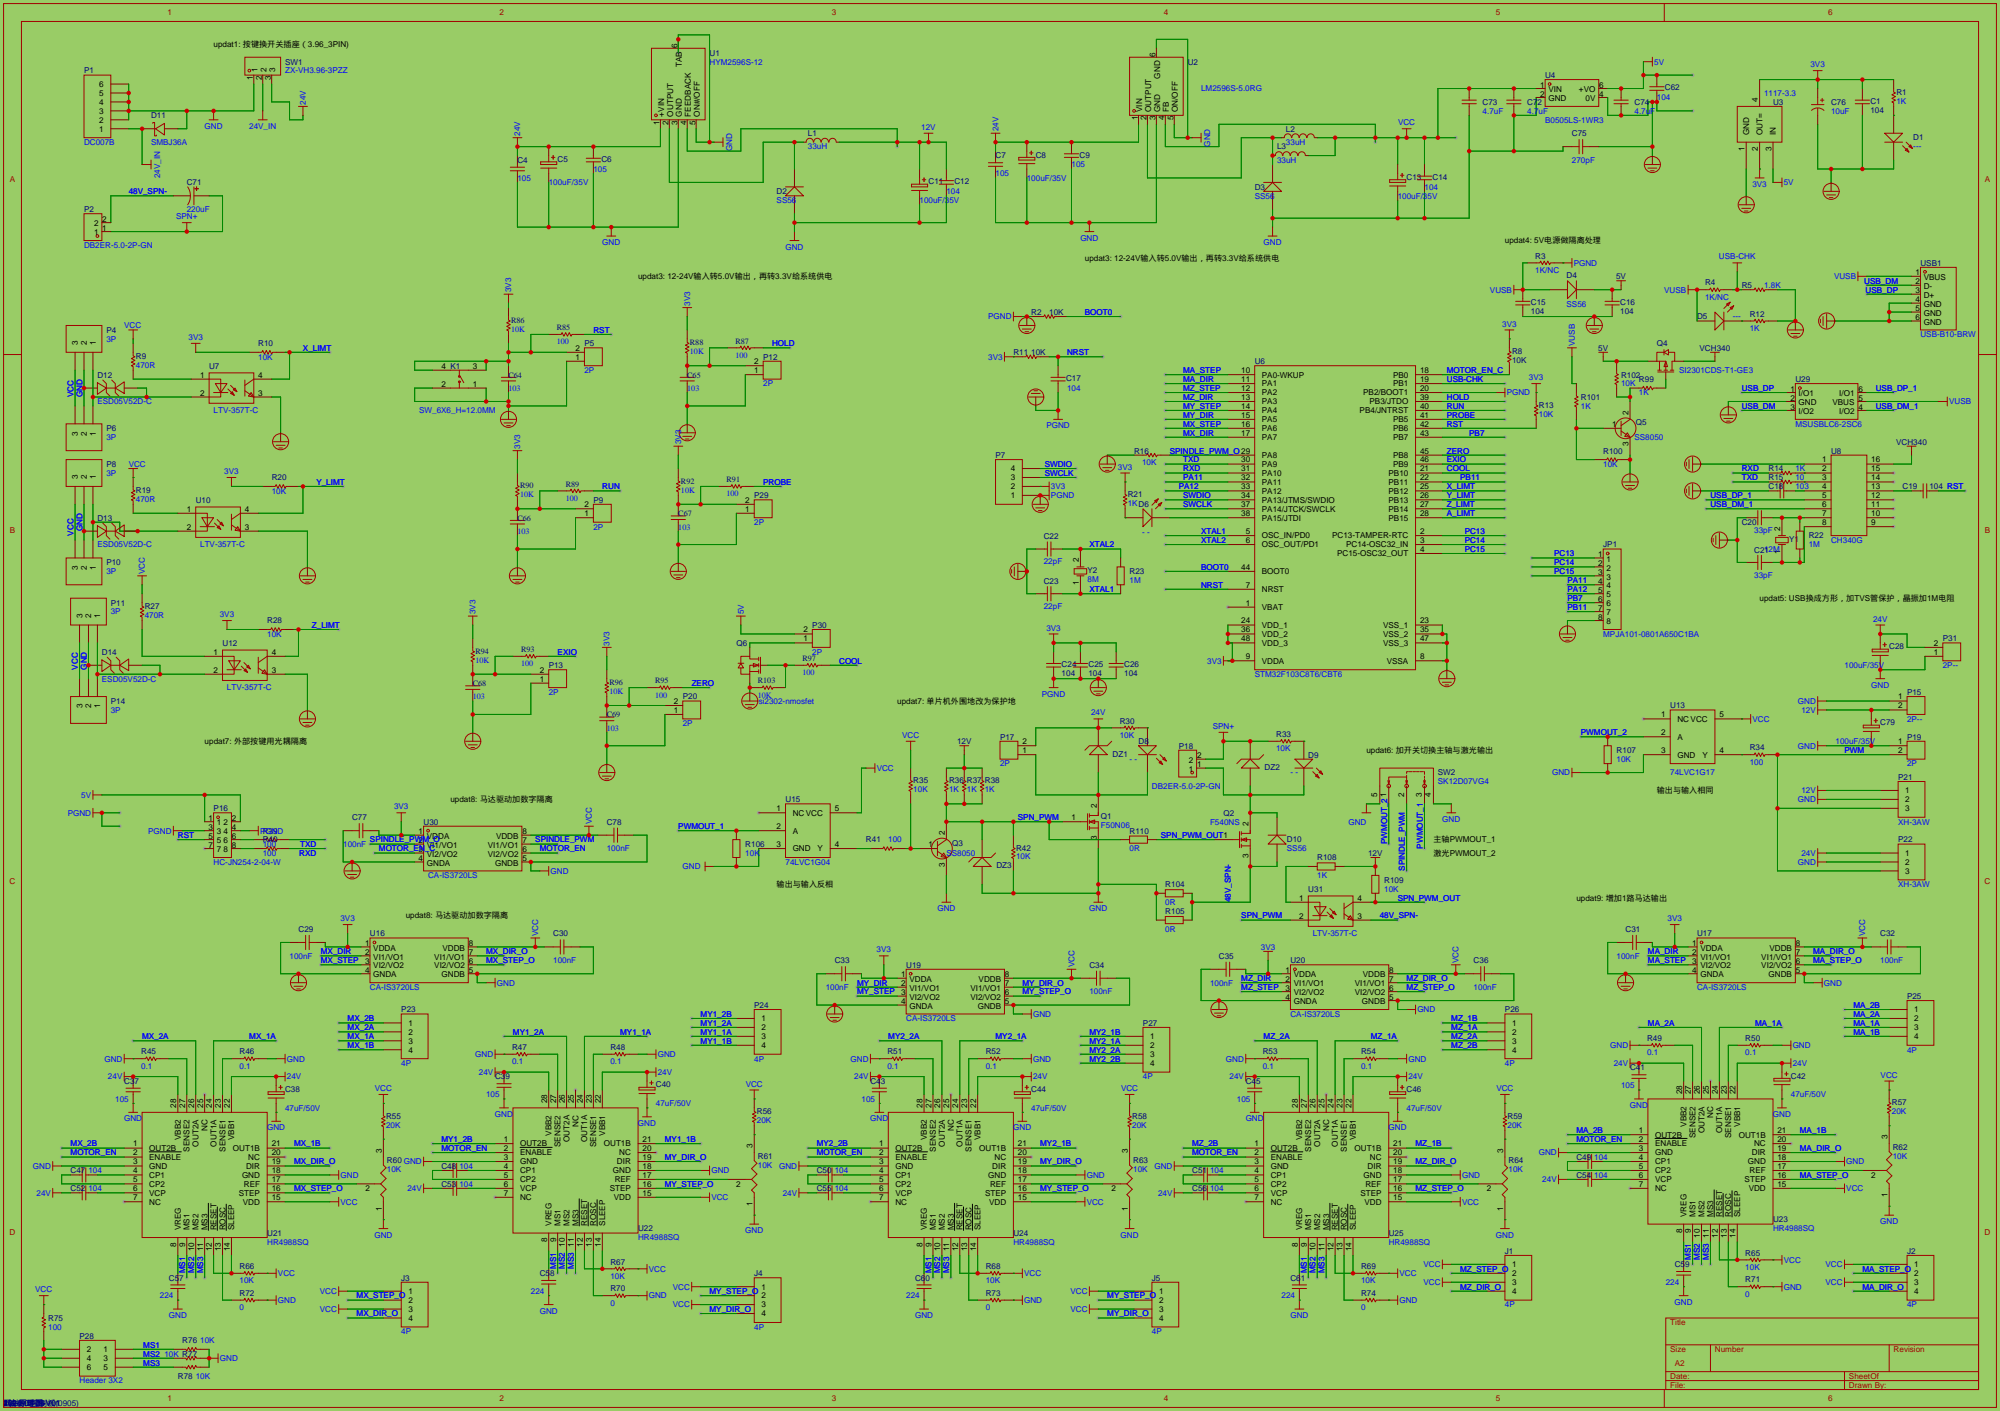
[picture p72: page 1]

VDD 15 STEP 16 REF 17 GND 18 DIR 19 NC 20 OUT1B 21 VBB¹ ²² SENSE¹ ²³ OUT1A ²⁴ NC ²⁵ OUT2A ²⁶ SENSE² ²⁷ VBB² ²⁸
