gqkhao/pcb-schematics/3轴5.2/丝印图2 PCB_3轴5.2-.pdf

X-MOTOR | Y1-MOTOR | Y2-MOTOR
DC24V | DC48V

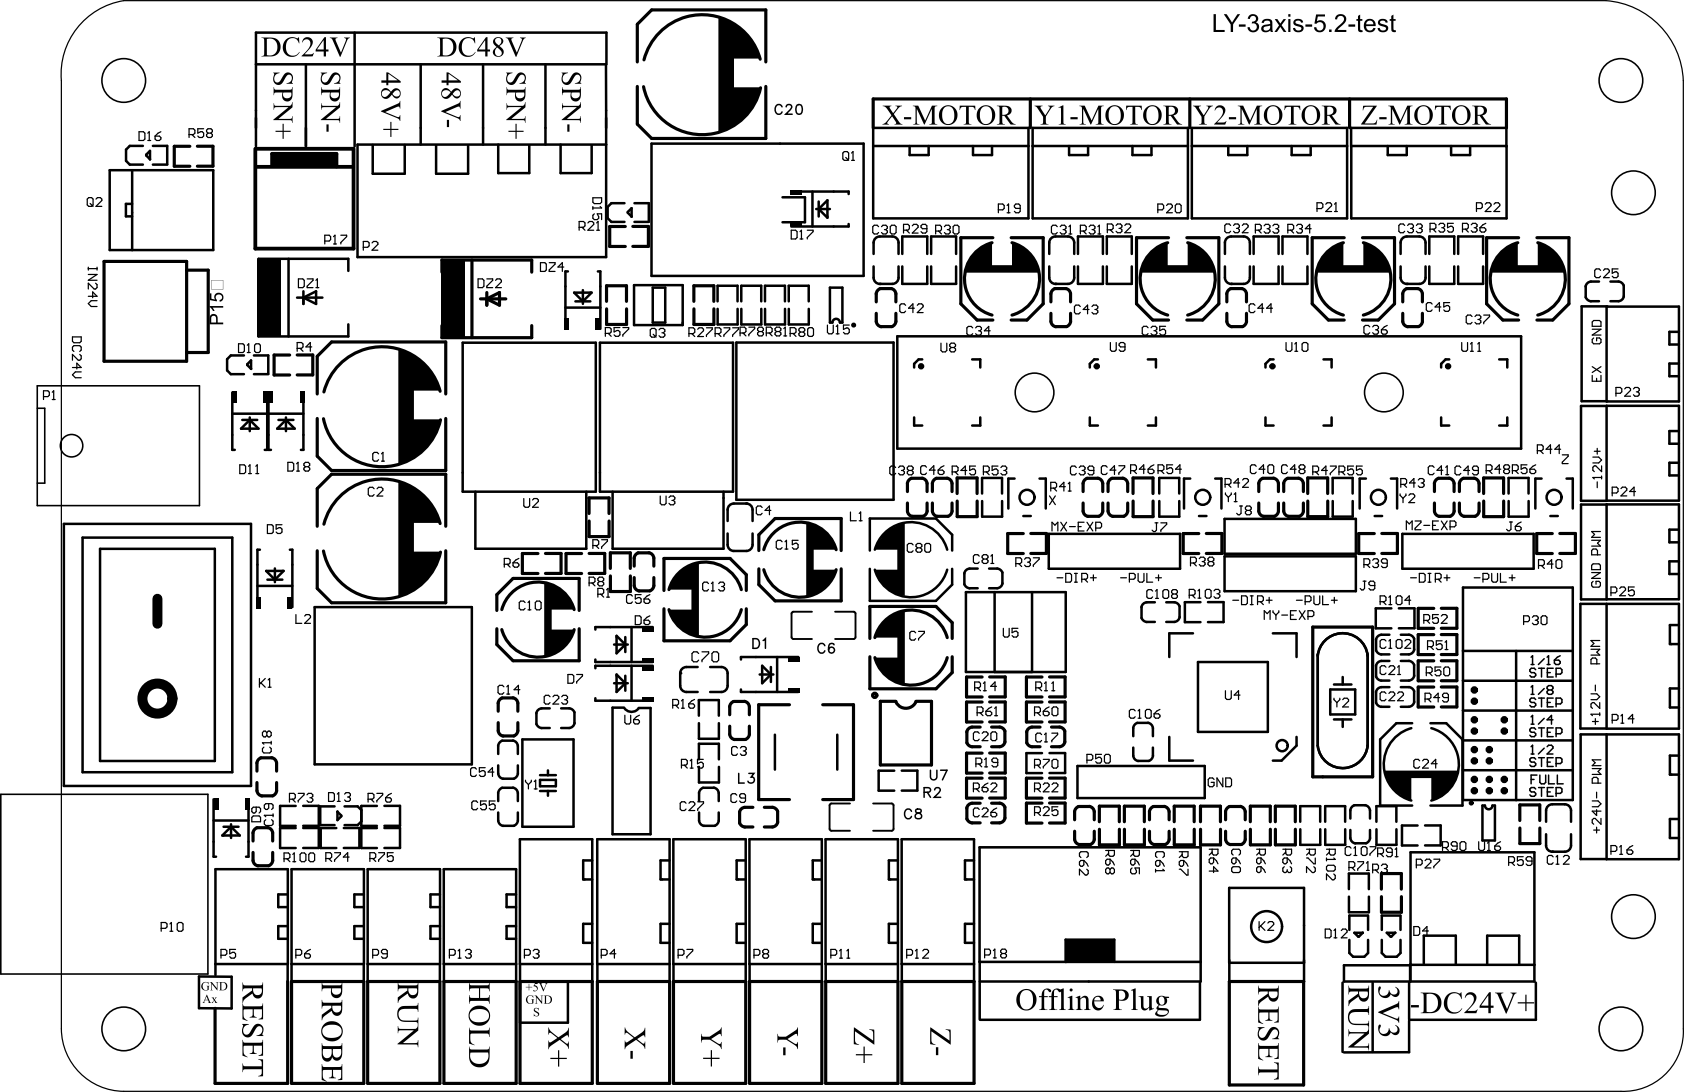
[picture p73: page 1]

GND -12V+ GND PWM +12V- PWM

1/4 STEP

1/2 STEP | P16

FULL STEP
