gqkhao/pcb-schematics/3020-2.0包覆款/包裹款触摸屏控制板v1.0_原理图.pdf

# 单片机LDO电源3.3V

# 24V转5V

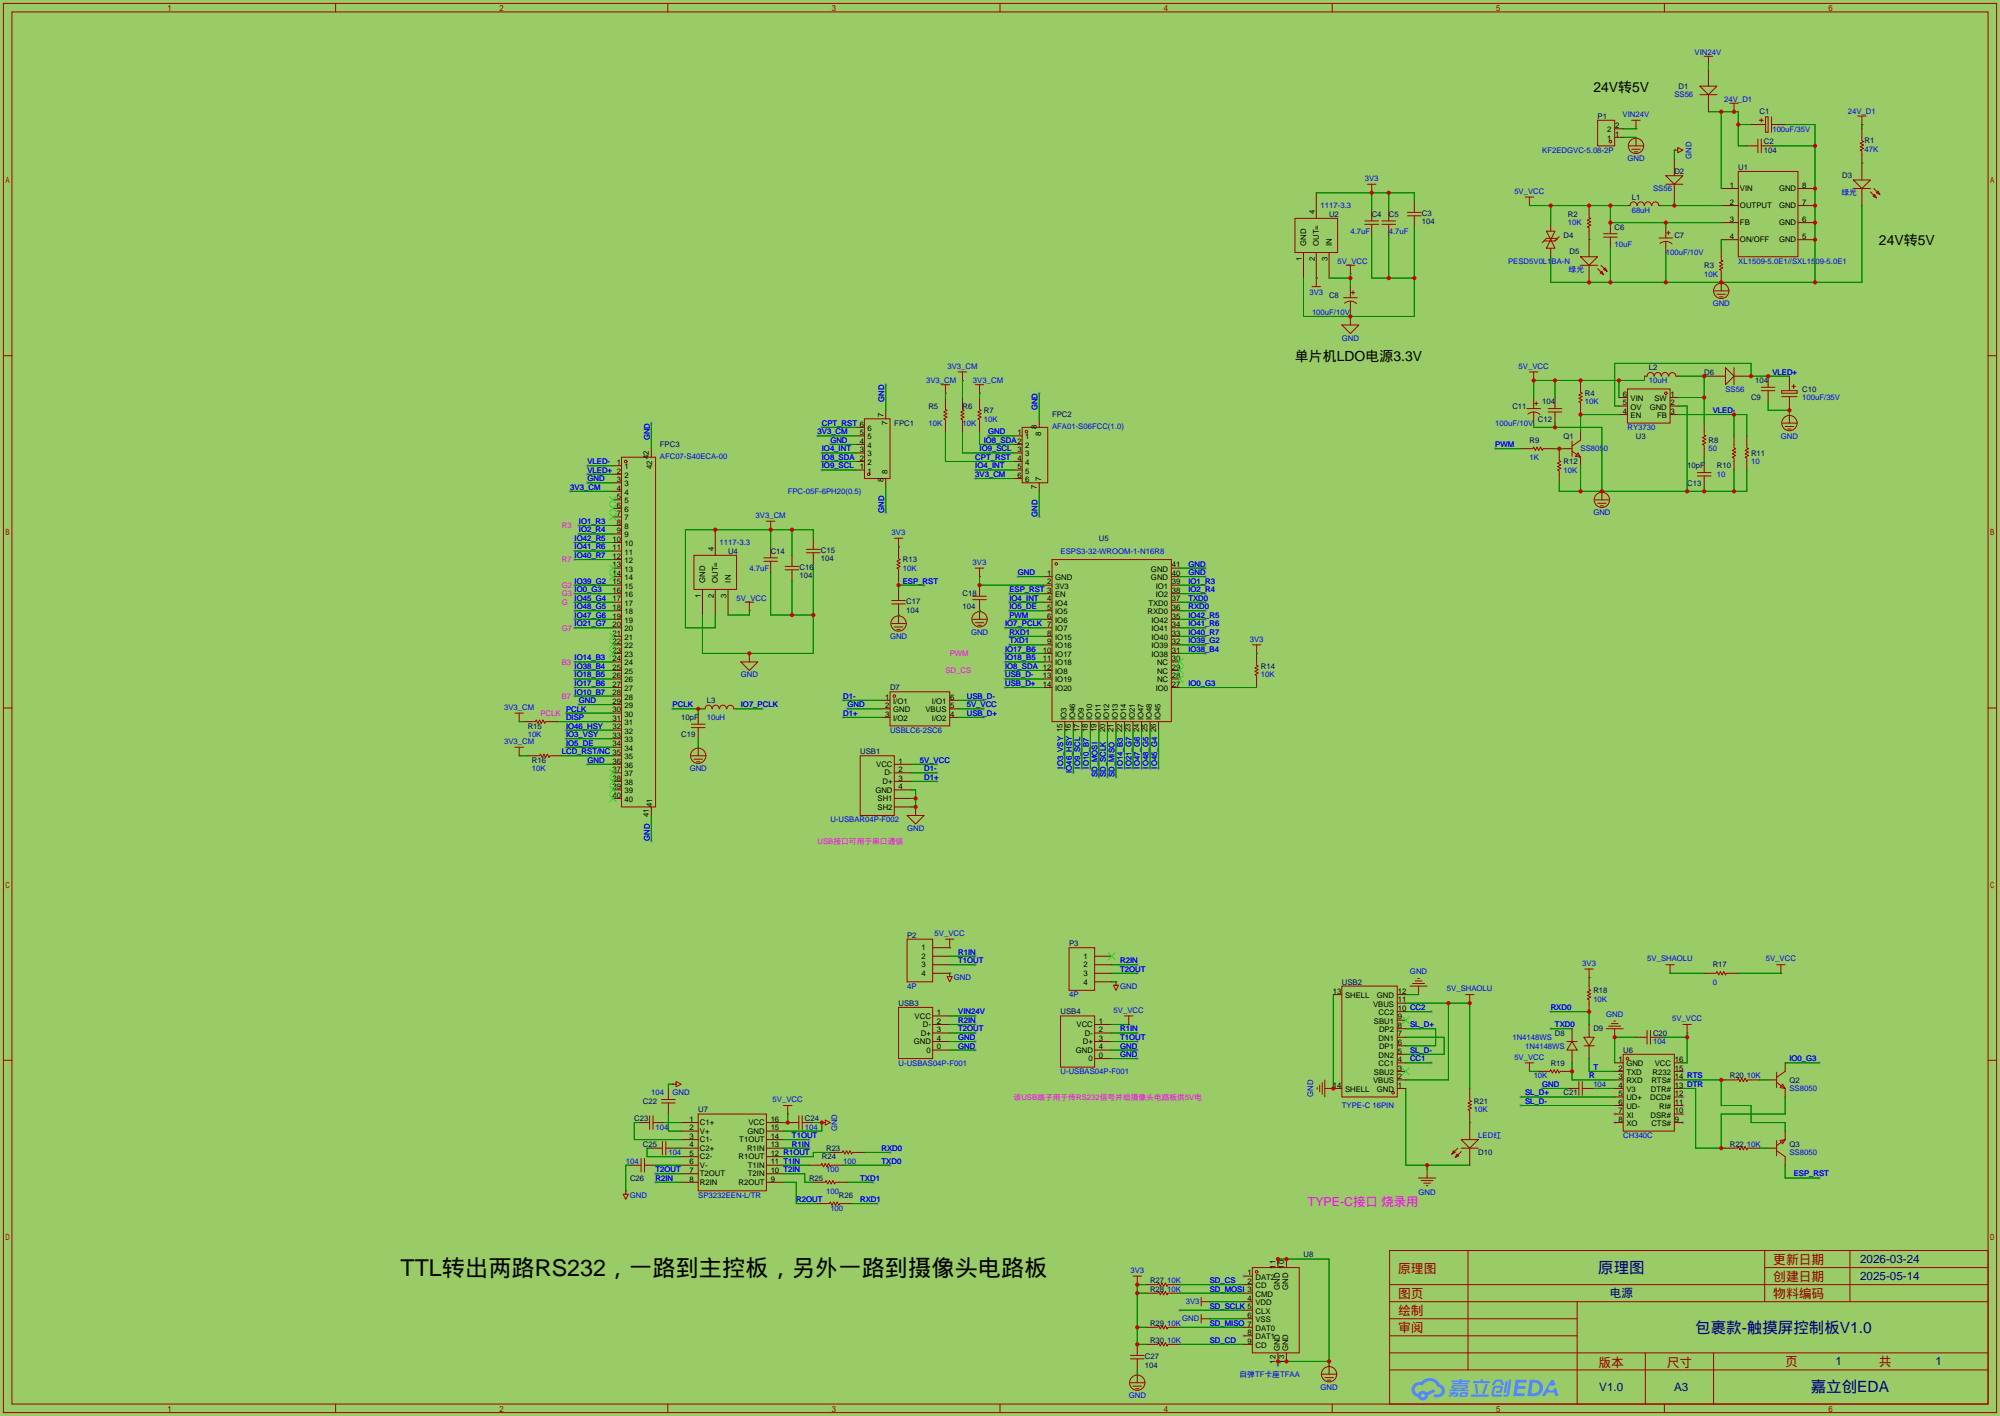
[picture p74: page 1]

IO0 27 NC 28 NC 29 NC 30 IO38 31 IO39 32 IO40 33 IO41 34 IO42 35 RXD0 36 TXD0 37 IO2 38 IO1 39 GND 40 GND 41
