gqkhao/pcb-schematics/3020-2.0包覆款/SCH_包裹款控制板V1.0原理图_2026-03-26.pdf

# 24V转5V

# 24V转5V

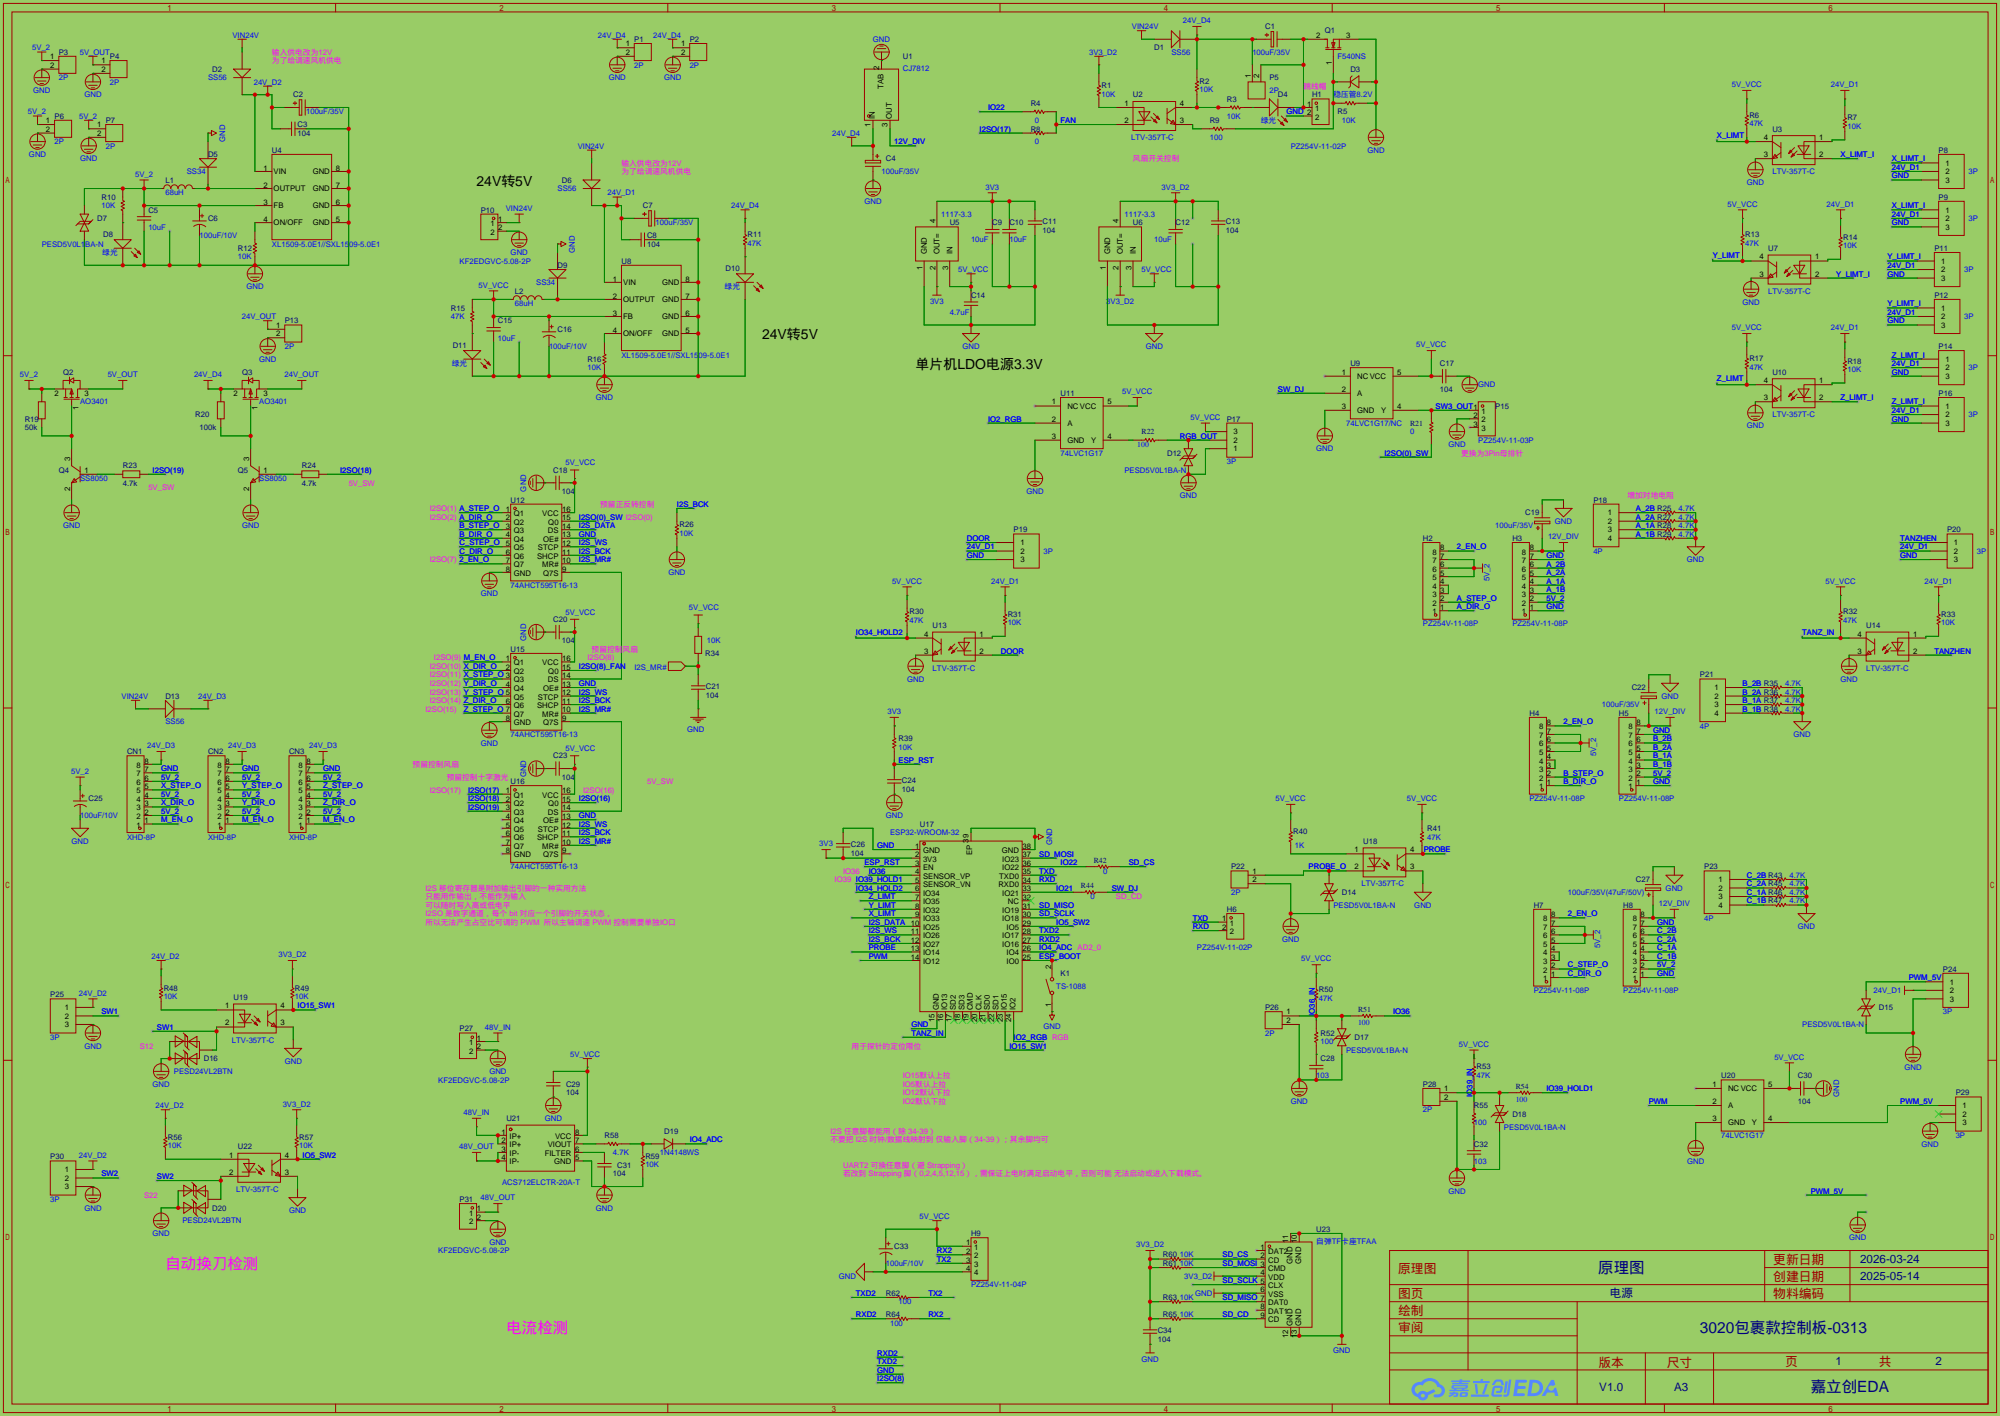
[picture p75: page 1]

MR# 10 SHCP 11 STCP 12 OE# 13 DS 14 Q0 15 VCC 16

I2S 移位寄存器是附加输出引脚的一种实用方法
只能用作输出，不能作为输入
可以随时写入高或低电平
I2SO 是数字通道，每个 bit 对应一个引脚的开关状态，
所以无法产生占空比可调的 PWM 所以主轴调速 PWM 控制需要单独IO口

I2S 任意脚都能用（除 34-39）
不要把 I2S 时钟/数据线映射到 仅输入脚（34-39）；其余脚均可

UART2 可换任意脚（避 Strapping）
若改到 Strapping 脚（0,2,4,5,12,15），需保证上电时满足启动电平，否则可能 无法启动或进入下载模式。

# TTL转RS232

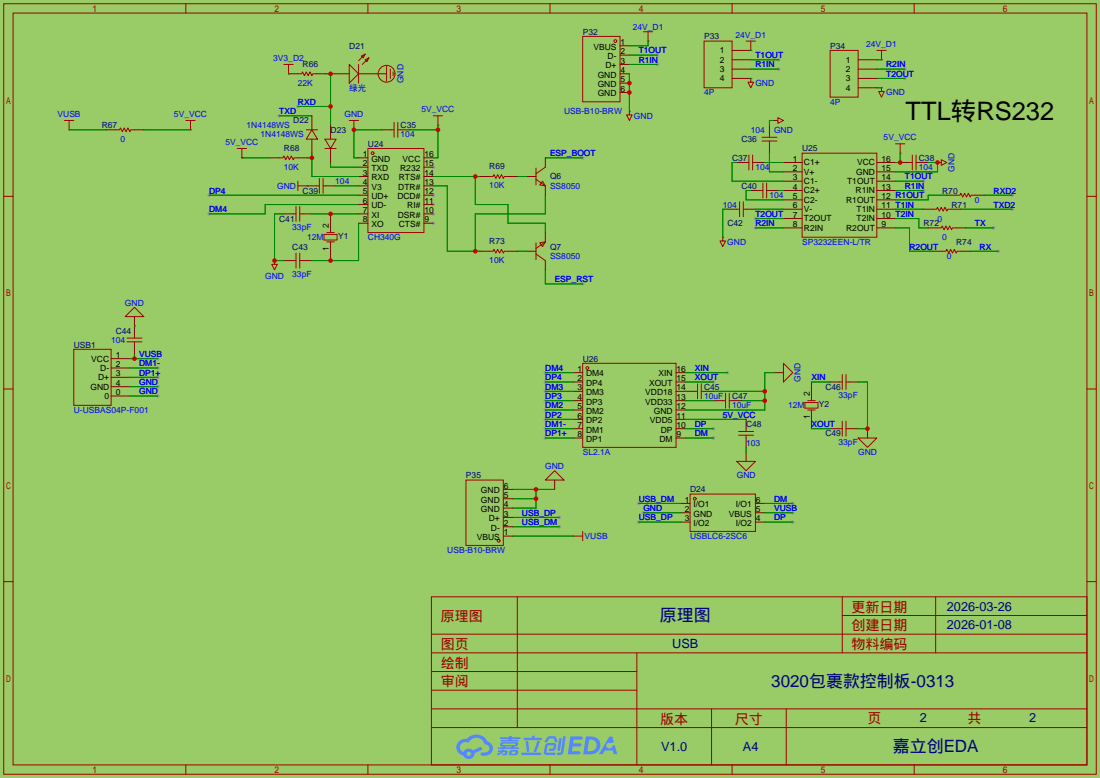
[picture p76: page 2]

DSR# 10 RI# 11 DCD# 12 DTR# 13 RTS# 14 R232 15 VCC 16

DP 10 VDD5 11 GND 12 VDD33 13 VDD18 14 XOUT 15 XIN 16
