gqkhao/pcb-schematics/电机驱动TB6600/TB6600驱动板/TB6600开发板原理图.pdf

D

6 | 5 | 4 | 3 | 2 | 1

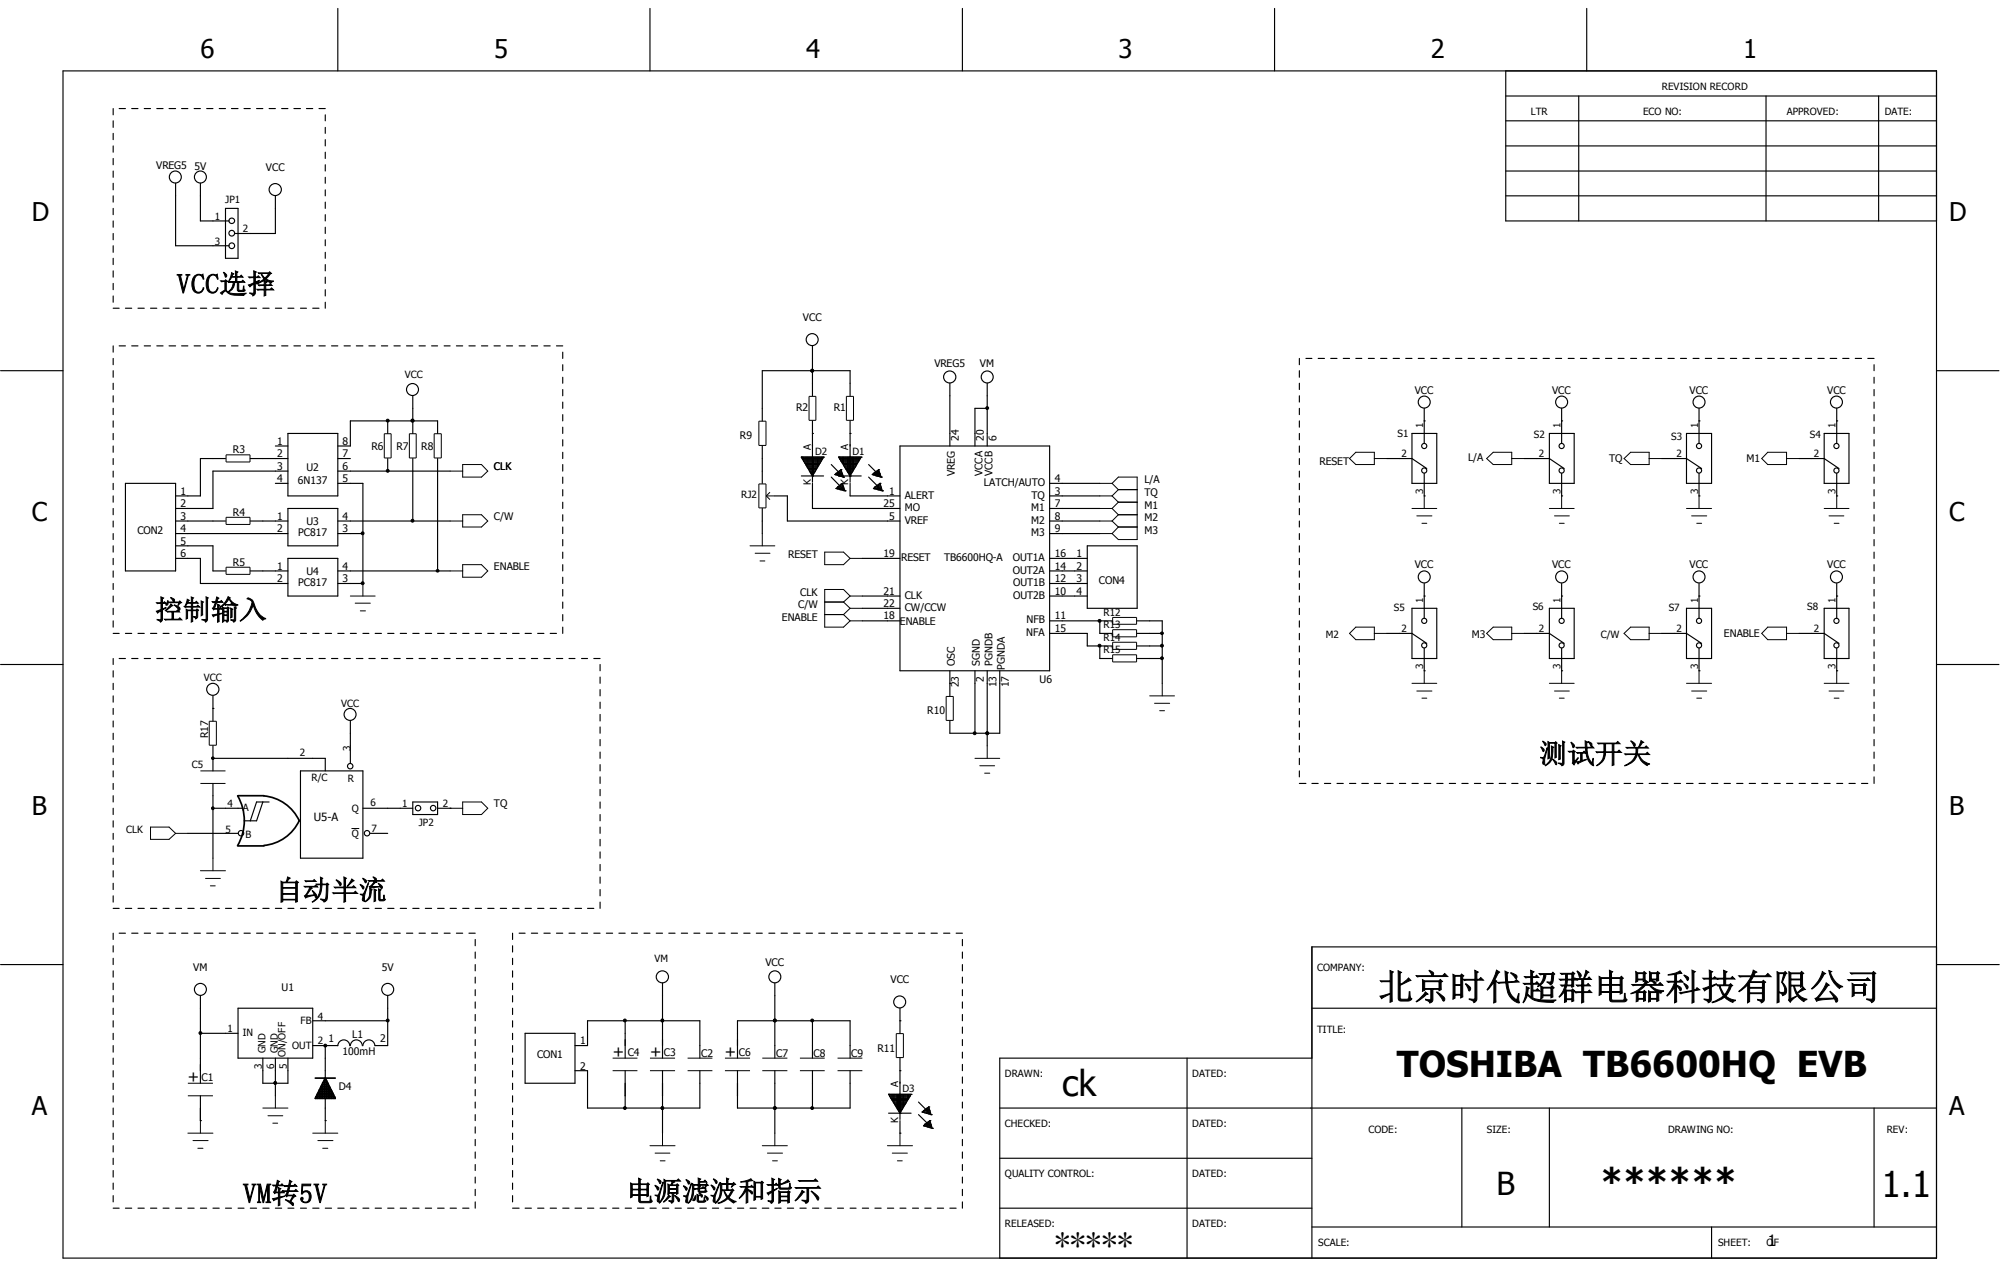
[picture p77: page 1]

5V VCC | REVISION RECORD

LTR | ECO NO: | APPROVED: | DATE:

DRAWN: ck | DATED:
CHECKED: | DATED: | CODE: | SIZE: B | DRAWING NO: ****** | REV: 1.1

QUALITY CONTROL: | DATED:

RELEASED: ***** | DATED:

SCALE: | 1 SHEET: OF

D

6 | 5 | 4 | 3 | 2 | 1

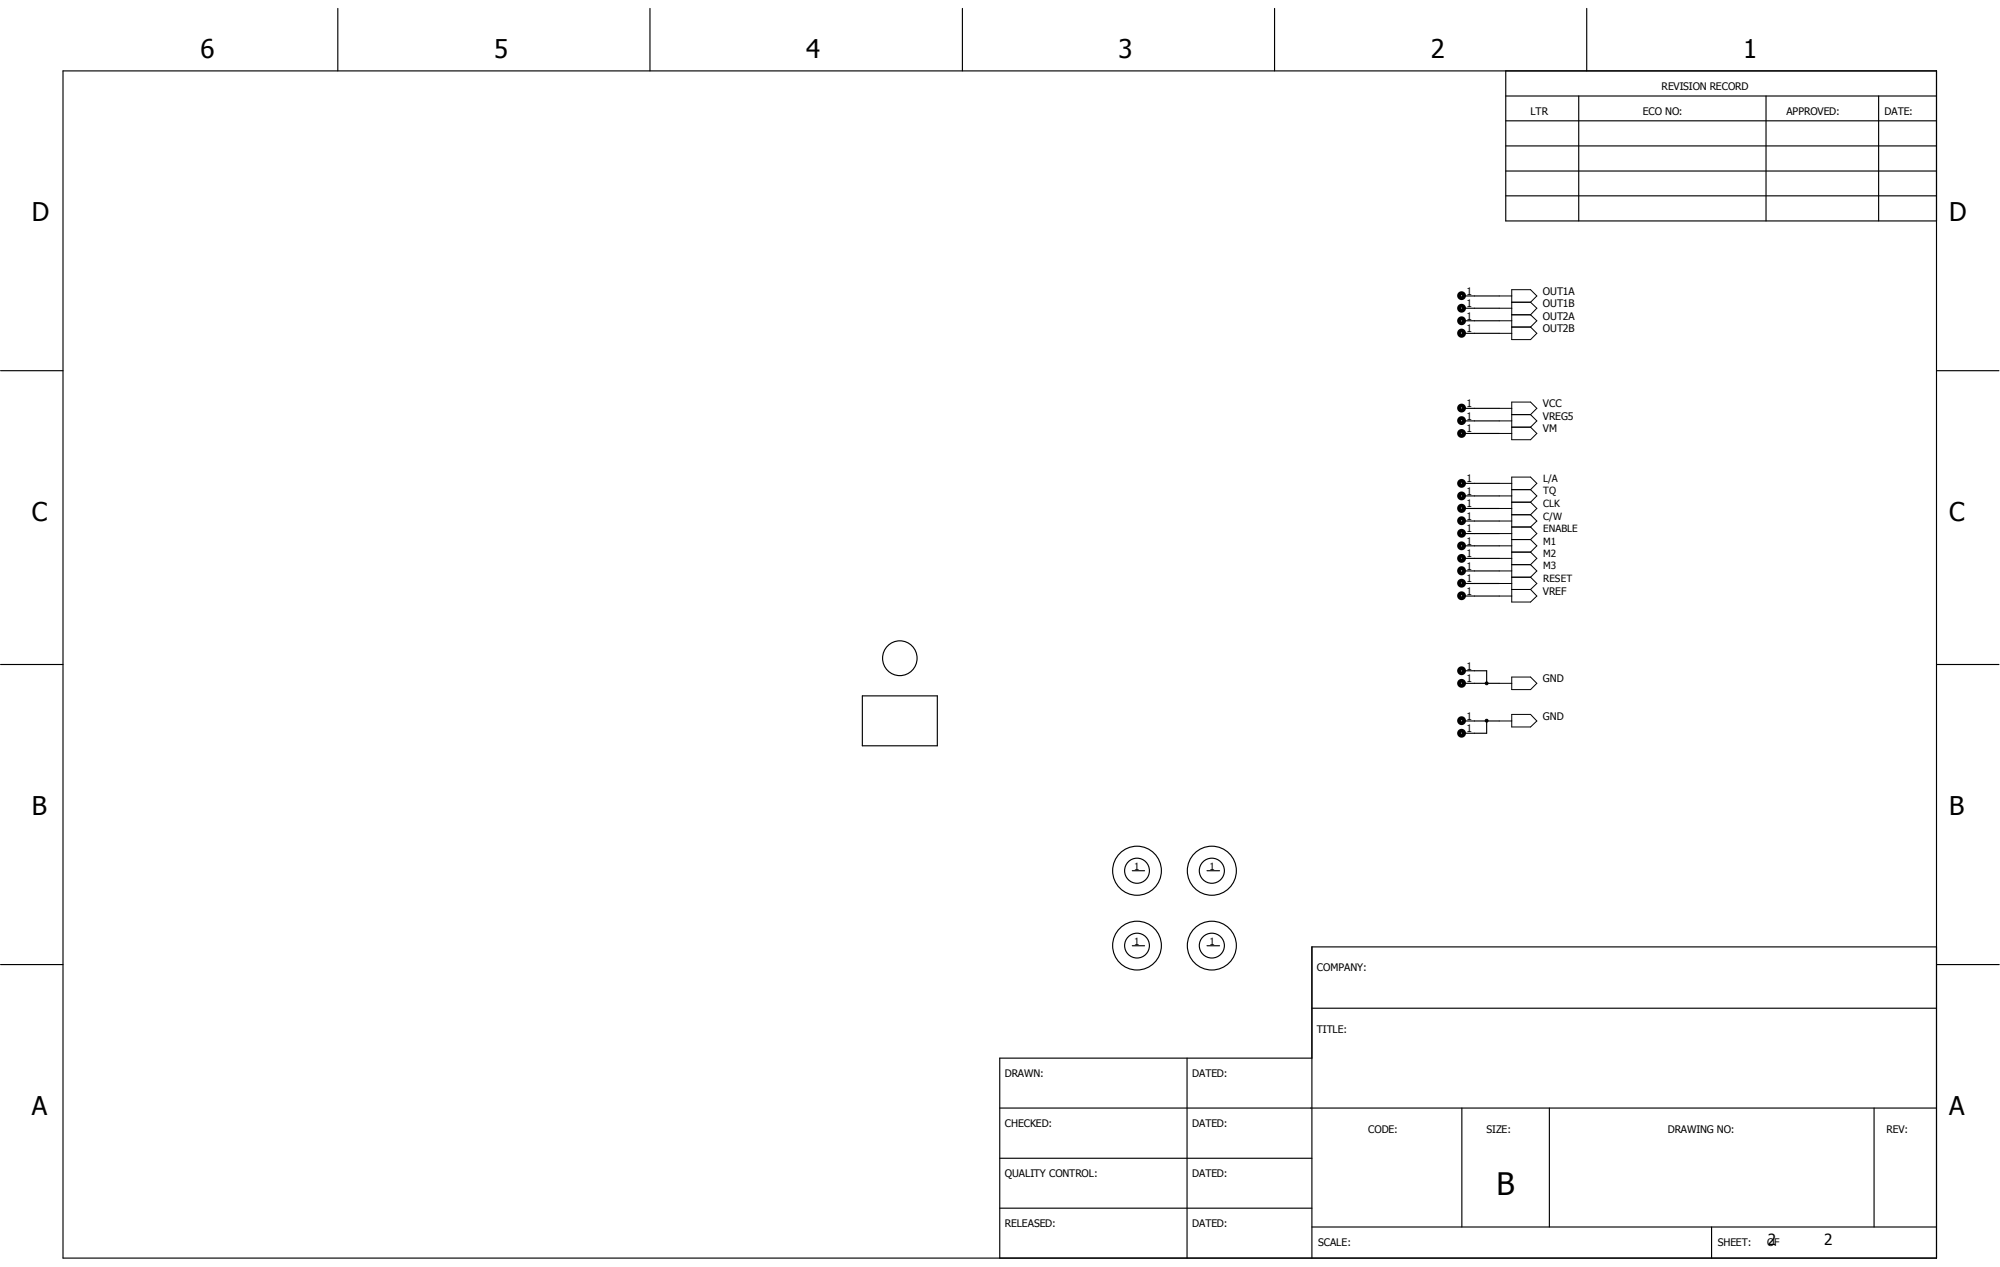
[picture p78: page 2]
COMPANY:; TITLE:; OUT1A OUT1B OUT2A OUT2B; VCC; GND; VREG5; L/A TQ CLK C/W ENABLE M1 M2 M3 RESET VREF

1 | REVISION RECORD

LTR | ECO NO: | APPROVED: | DATE:

DRAWN: | DATED:
CHECKED: | DATED: | CODE: | SIZE: B | DRAWING NO: | REV:

QUALITY CONTROL: | DATED:

RELEASED: | DATED:

SCALE: | 2 2 SHEET: OF
