gqkhao/pcb-schematics/电机驱动TB6600/TB6600驱动板/tb6600板子资料/QH_电路原理图.pdf

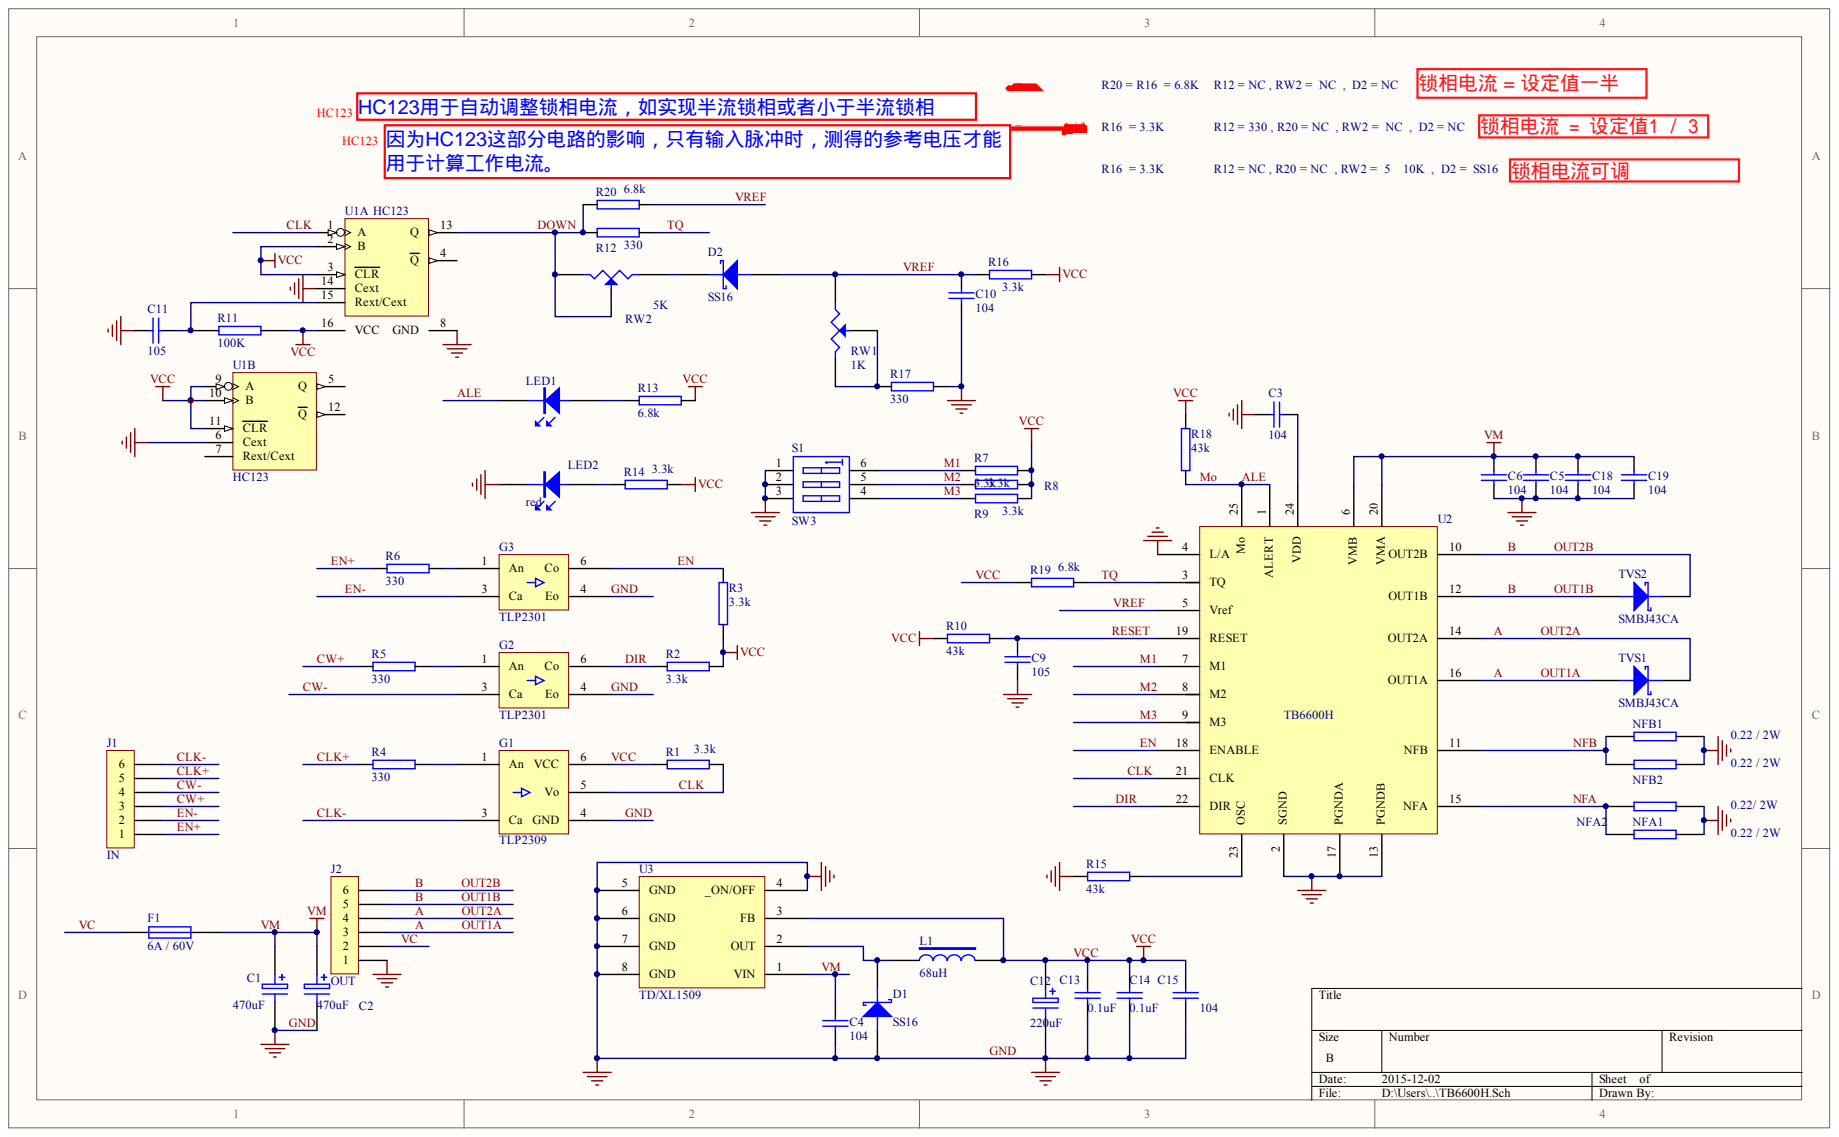
[picture p79: page 1]

Bill of Materials | Bill of Materials For Project [Free Documents] (No PCB Document Selected)
Source Data From: | Free Documents
Project: | | Free Documents
Variant: | | None
Creation Date: 2015-12-02 | 13:21:10
Print Date: | 42340 | 42340.55661
#Column Name Error: #Column Name Error: #Column Name Error: #Column Name Error: Designator | #Column Name Error:Description | #Column Name Error:Quantity

0
Approved | Notes
