gqkhao/pcb-schematics/FluidNC/原理图导出--3020包裹款-V1.0.pdf

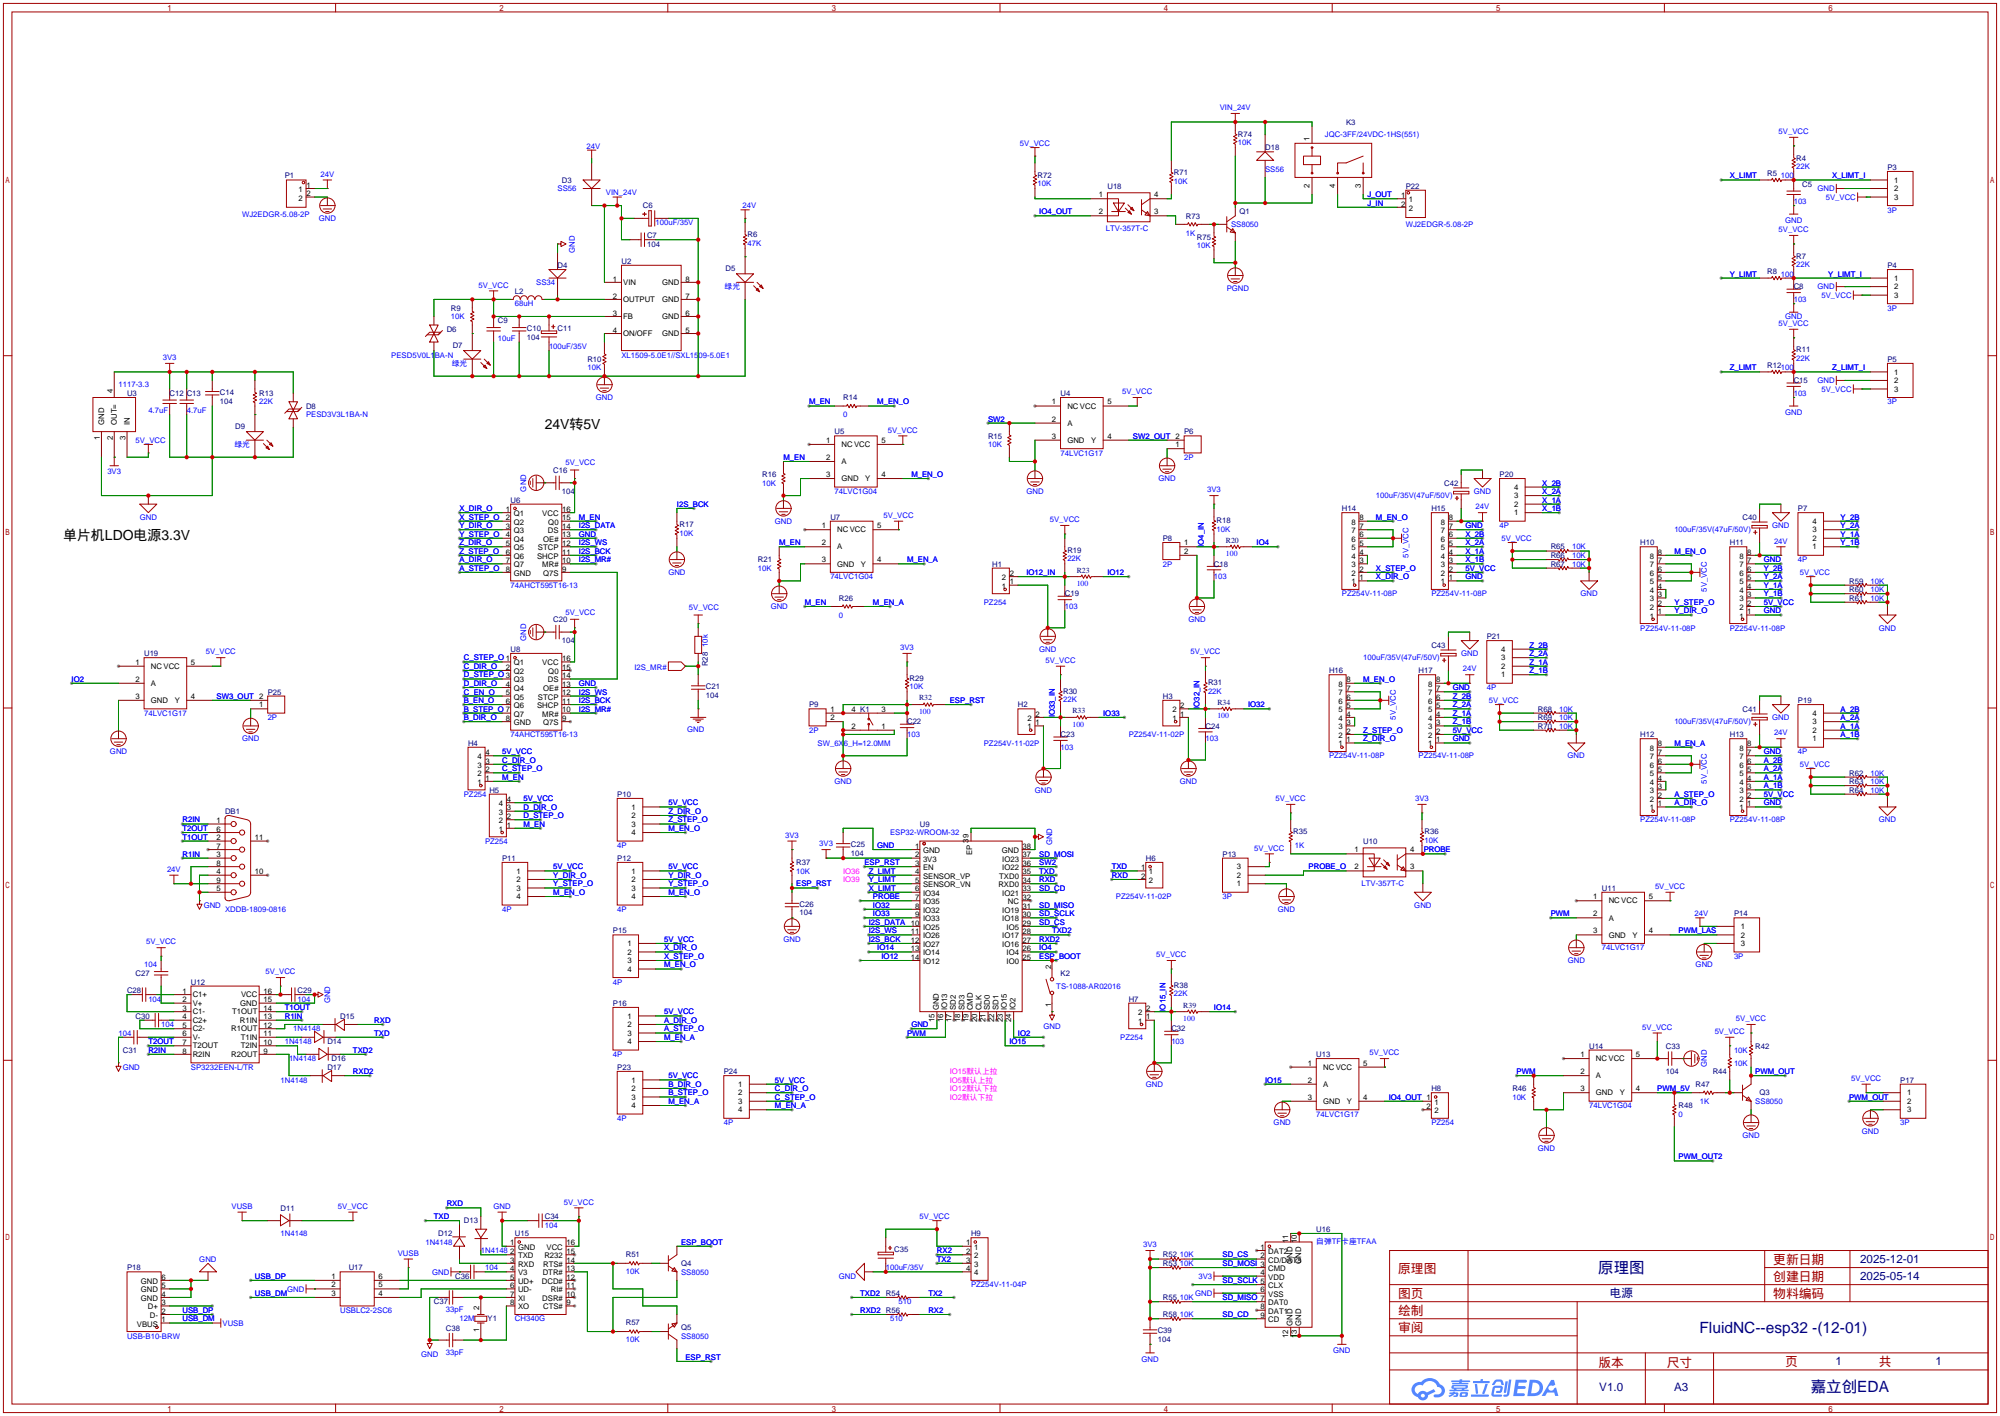
[picture p80: page 1]

MR# 10 SHCP 11 STCP 12 OE# 13 DS 14 Q0 15 VCC 16

DSR# 10 RI# 11 DCD# 12 DTR# 13 RTS# 14 R232 15 VCC 16
