gqkhao/pcb-schematics/FluidNC/PCB_PCB_2026-04-30.pdf

2025-12-5

# C31 C15 H¹¹

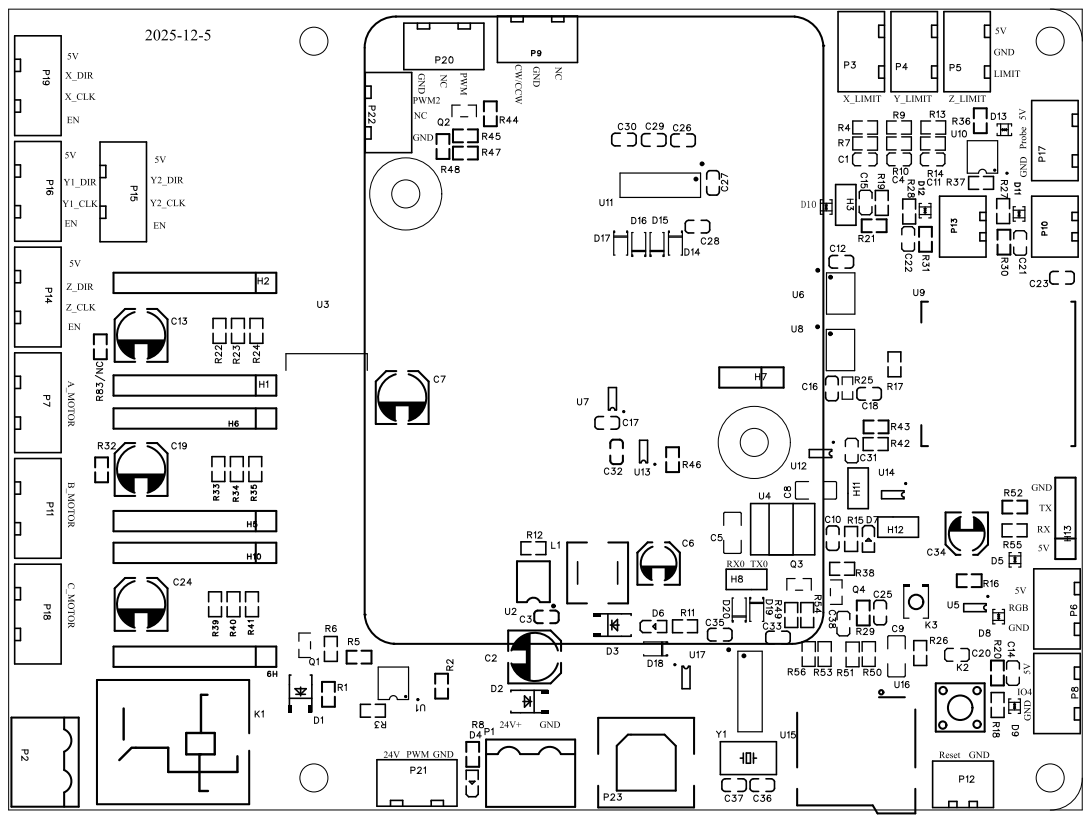
[picture p81: page 1]

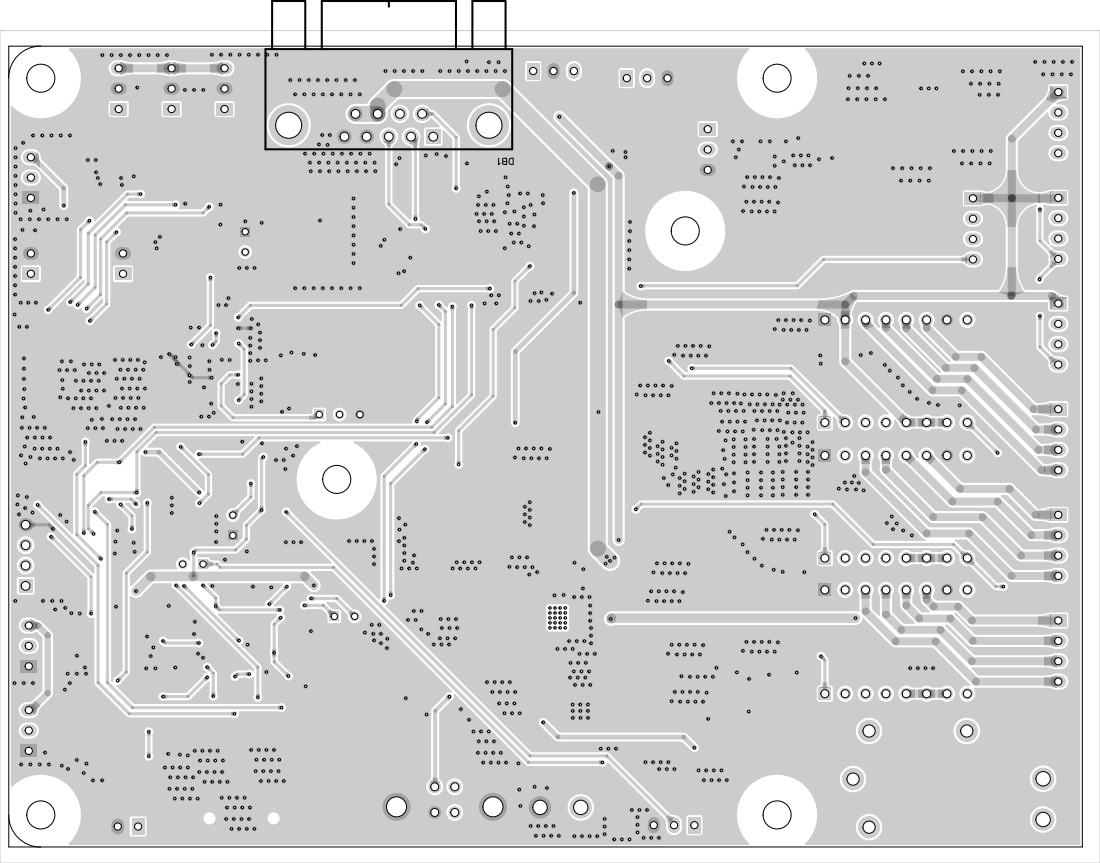
[picture p82: page 2]

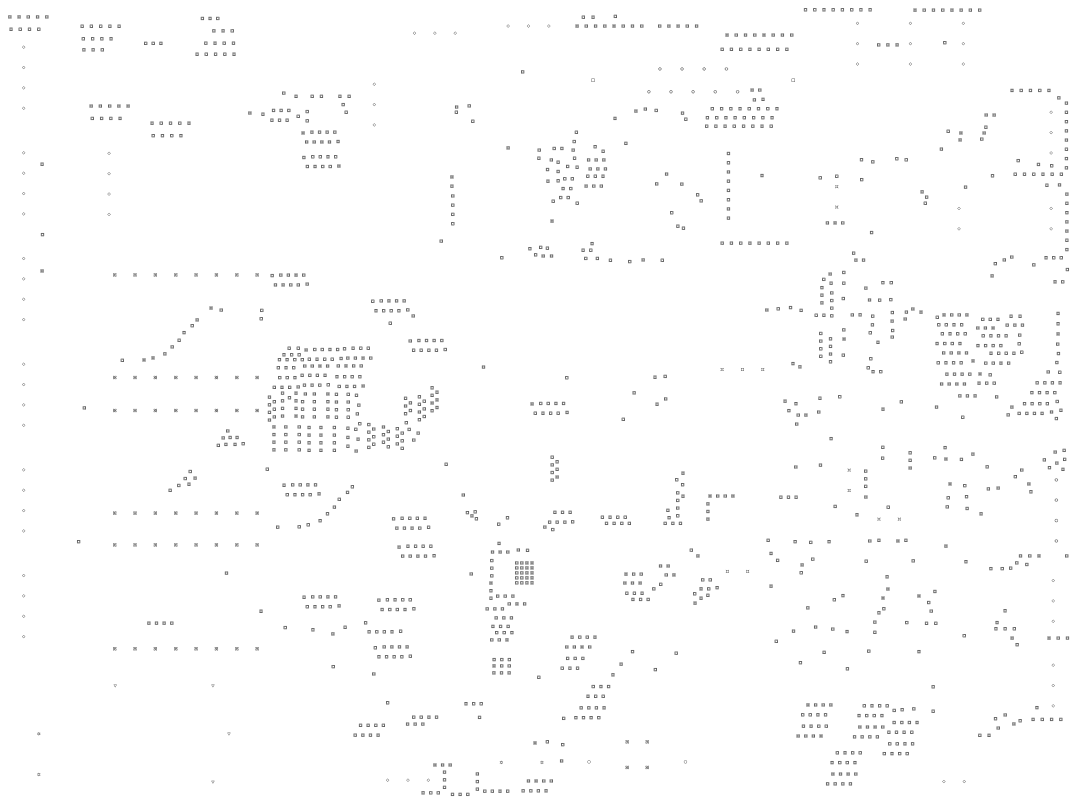
[picture p83: page 3]
