gqkhao/pcb-schematics/FluidNC/PCB_PCB_2025-12-04.pdf

# C32 C19 H⁷

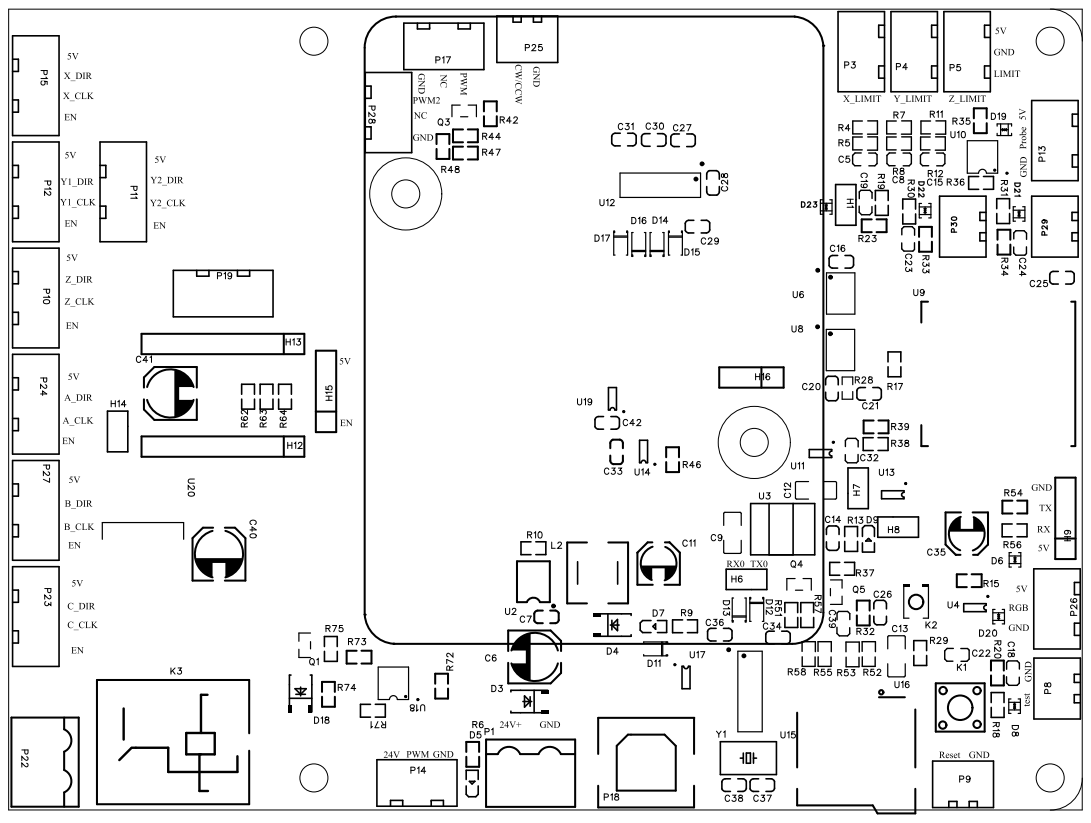
[picture p84: page 1]

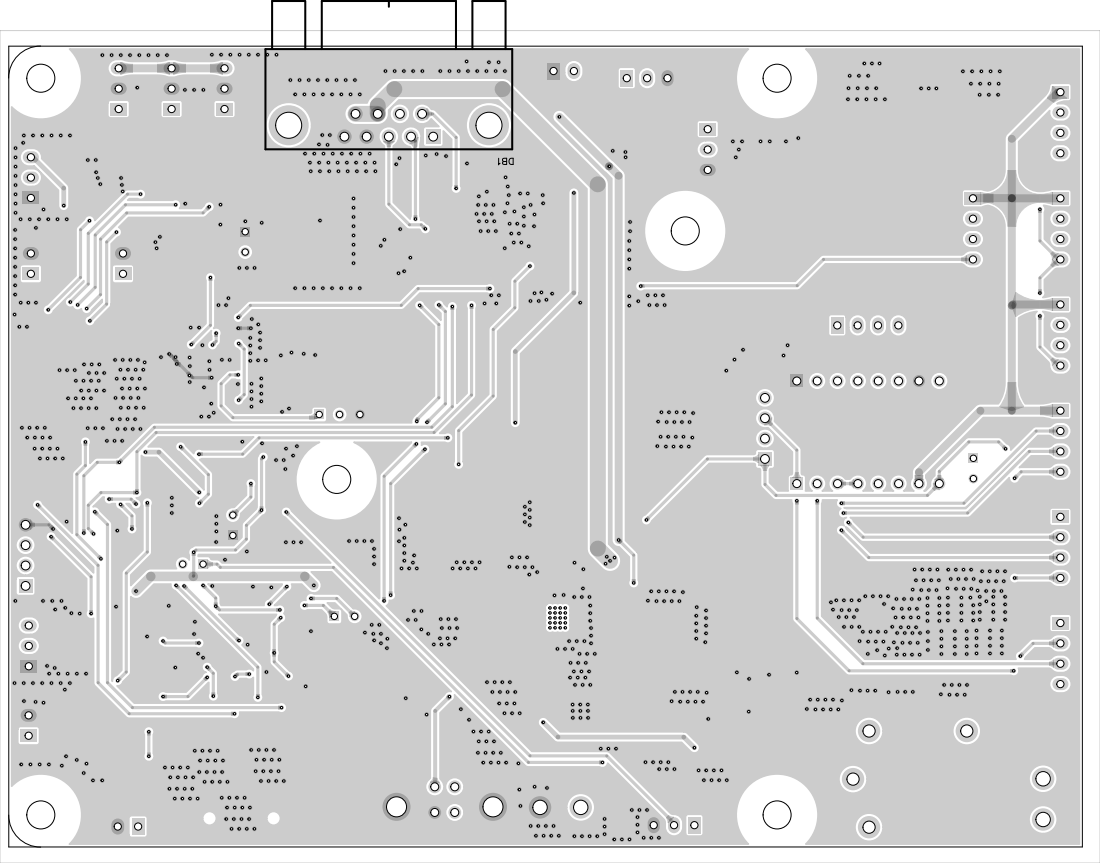
[picture p85: page 2]
