gqkhao/pcb-schematics/4040M/4040M主控板v1.0_原理图.pdf

24V转5V | VIN 1

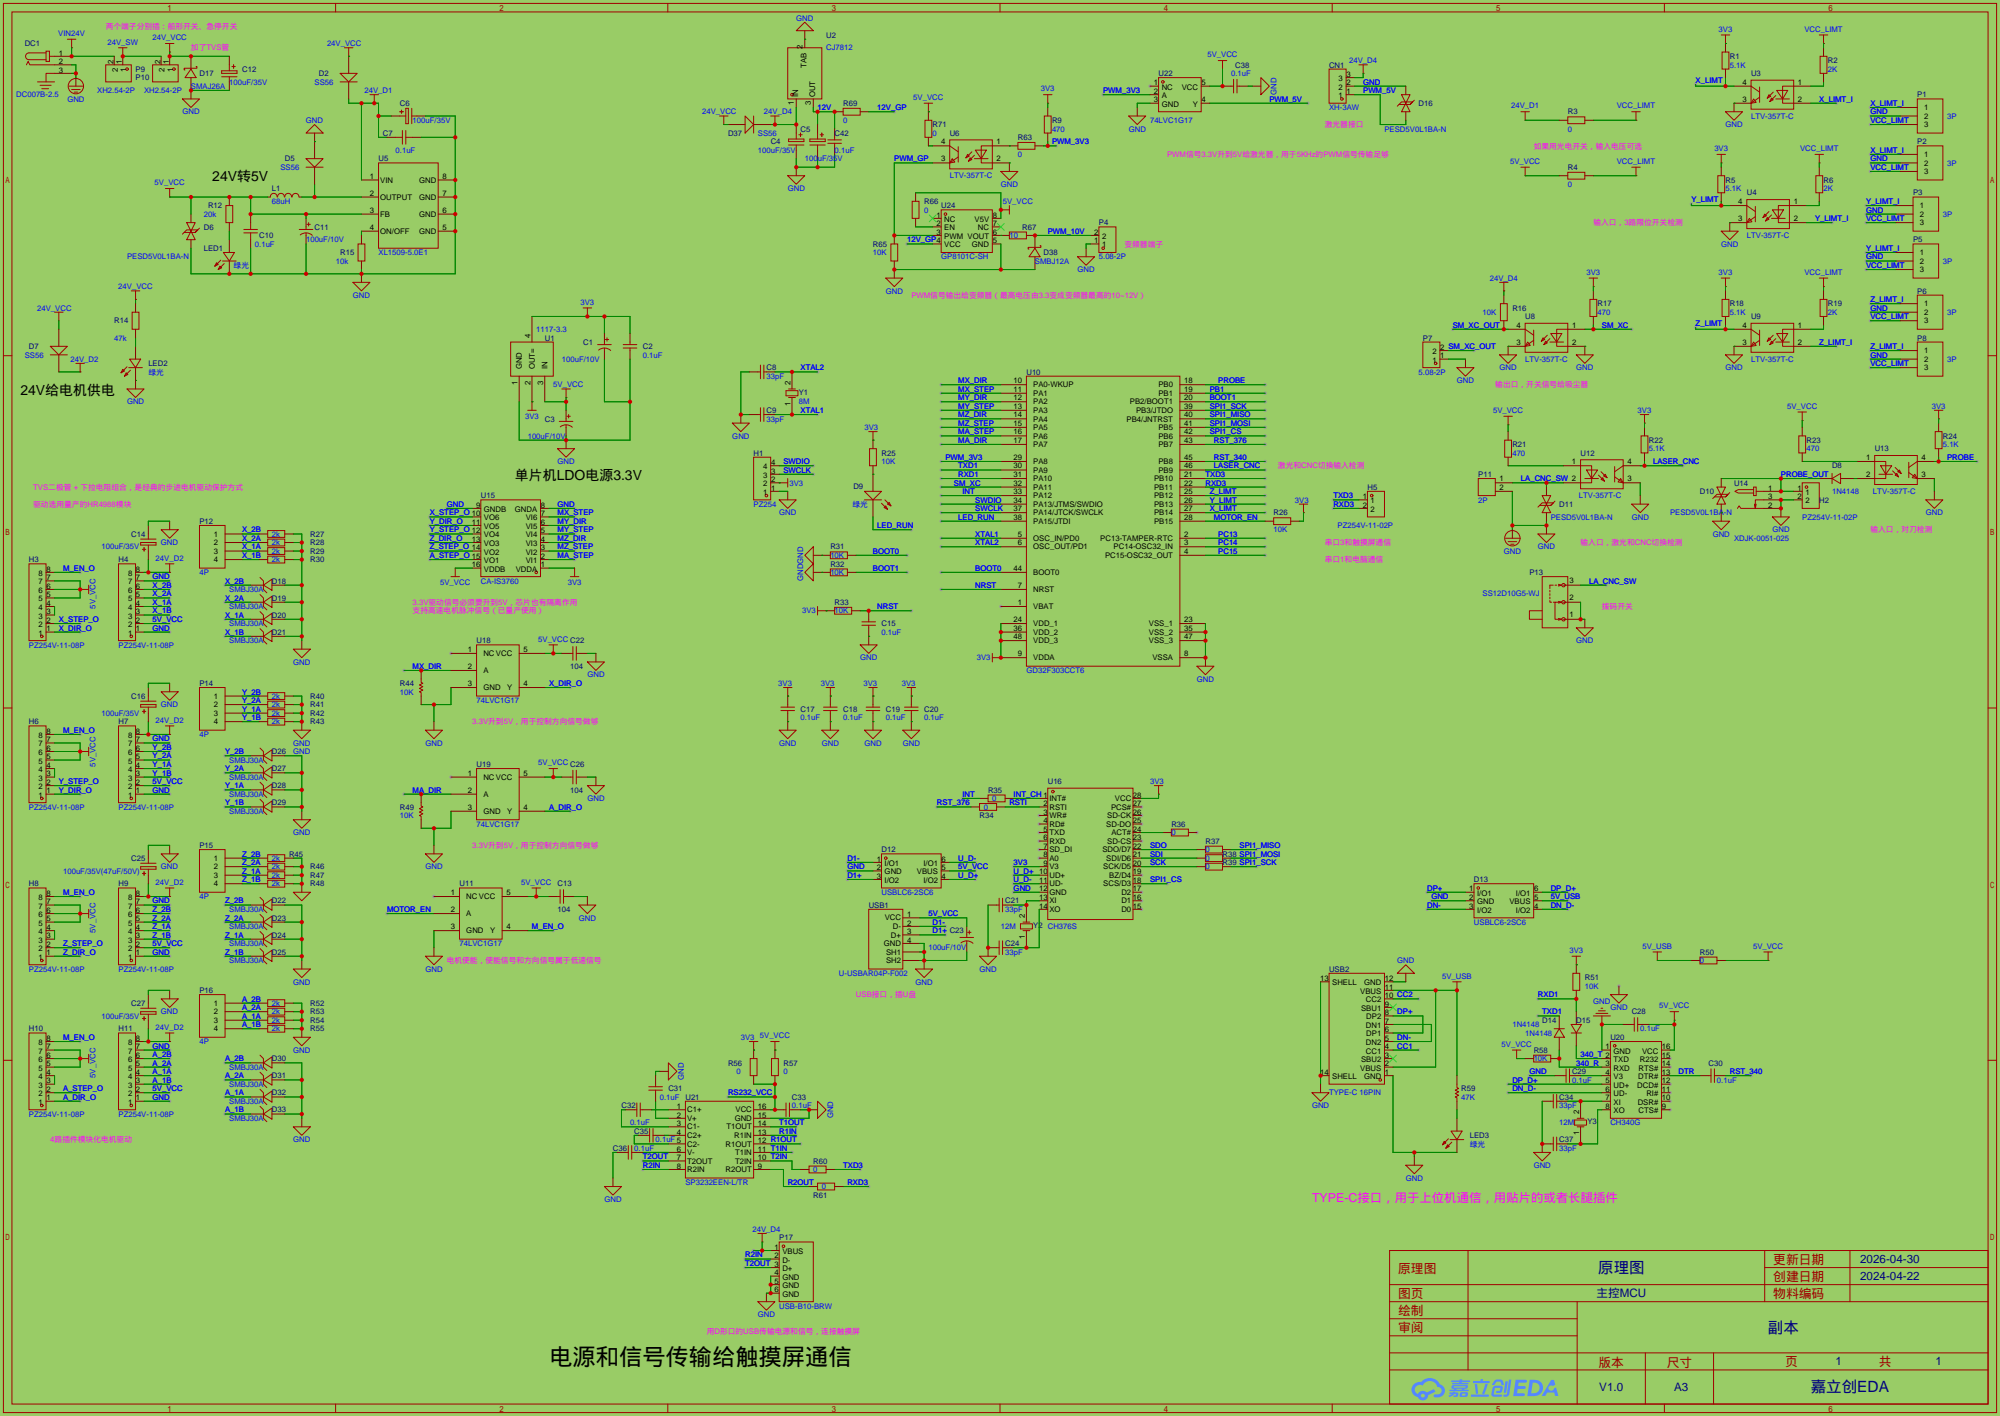
[picture p86: page 1]

ACT# 24 SD-DO 25 SD-CK 26 PCS# 27 VCC 28

TYPE-C接口，用于上位机通信，用贴片的或者长腿插件
