gqkhao/pcb-schematics/(list of files, drawings)

Other design files:
1.8寸脱机屏/1.8寸脱机4轴-PCB-V2.0.PcbDoc
1.8寸脱机屏/1.8寸脱机4轴-原理图-V2.0-2022.05.13.SchDoc
1.8寸脱机屏/1.8寸脱机4轴.PcbDoc
1单轴控制/RS232转接控制板.eprj
1单轴控制/单轴带屏幕.eprj
001发采购/电控箱转接板NC4040-4.0-1.0/PCB源文件-电控箱转接板NC4040-4.0-1.0.eprj
2Axis-5.0-南塘/2Axis-5.0-南塘 - (0522).eprj
2Axis-5.0-南塘/上传/2轴5.0控制板PCB源文件（LY-2X5.0-V1.1）.eprj
2轴4.0/2X-4.5-V3++.PcbDoc
2轴4.0/2X-4.5-V3.PcbDoc
2轴4.0/2轴4.0--(02-06).eprj
2轴4.0/2轴4.0-.SchDoc
2轴4.0/2轴4.0控制板PCB源文件（LY-2X4.5-V4-ESD）.eprj
3轴4.0/3轴4.0控制板PCB源文件（LY-3X4.0-V2.0）.eprj
3轴4.0/LY-3axis-4.0-v2.0-.PcbDoc
3轴4.0/LY-3axis-4.0-v2.0.pcb
3轴5.2/3轴5.2-V3.3/3轴5.2-PCB-V3.3-2023.10.27.PcbDoc
3轴5.2/3轴5.2-V3.3/3轴5.2-原理图-V3.3-2023.10.27.SchDoc
3轴5.2/3轴5.2-专业软件格式.PcbDoc
3轴5.2/3轴5.2_ -0718 -(8.8x13cm).eprj
3轴5.2/3轴5.2_-专业软件格式.eprj
3轴5.2/AD格式/3轴5.2-原理图-V3.2.SchDoc
3轴5.2/AD格式/电源部分.SchDoc
3轴6.0--esp32/2轴6.0.SchDoc
3轴6.0--esp32/3轴6.0__esp32.eprj
3轴6.0--esp32/3轴6.1--esp32 - (6-21).eprj
3轴6.0--esp32/3轴6.1--esp32 - (改驱动一半).eprj
3轴6.0--esp32/3轴6.1--esp32 -(7-8).eprj
3轴6.0--esp32/3轴6.1--esp32 -(7-30)-删除器件.eprj
3轴6.0--esp32/3轴6.1--esp32 -(08-14).eprj
3轴6.0--esp32/3轴6.1--esp32 -(8-15) - 导BOM.eprj
3轴6.0--esp32/3轴6.1--esp32 -(0105).eprj
3轴6.0--esp32/3轴6.1--esp32 -(0604).eprj
3轴6.0--esp32/3轴6.1--esp32 -(0604)改.eprj
3轴6.0--esp32/3轴6.1--esp32 -(0730).eprj
3轴6.0--esp32/3轴6.1--esp32 -(0802).eprj
3轴6.0--esp32/3轴6.1--esp32 -(0815).eprj
3轴6.0--esp32/3轴6.1--esp32 -(0821).eprj
3轴6.0--esp32/3轴6.1--esp32 -(0825).eprj
3轴6.0--esp32/3轴6.1--esp32 -(0905) - 副1.eprj
3轴6.0--esp32/3轴6.1--esp32 -(0905) - 副.eprj
3轴6.0--esp32/3轴6.1--esp32 -(1031) I2S.eprj
3轴6.0--esp32/3轴6.1--esp32 -(驱动).eprj
3轴6.0--esp32/3轴6.1--esp32.eprj
3轴6.0--esp32/3轴6.1--esp32S3.eprj
3轴6.0--esp32/3轴6.2--esp32S3.eprj
3轴6.0--esp32/10-10.eprj
3轴6.0--esp32/ESP32-AXIS3-6.0 V1.0-2024-7-27.PcbDoc
3轴6.0--esp32/ESP32-AXIS3-6.0.PcbDoc
3轴6.0--esp32/老3轴6.0__esp32.eprj
3轴6.0--esp32/限位开关转接板.eprj
4轴3.0/4轴3.0控制板PCB源文件LY-4X3.0-V3.4.eprj
4轴5.0/LY-5X-V3.1 - (0826).eprj
4轴5.0/LY-5X-V3.1 - (0826)留EN.eprj
4轴5.0/LY-5X-V3.1 - (0904) - 12V和24V.eprj
4轴5.0/LY-5X-V3.1 - (0905).eprj
4轴5.0/LY-5X-V3.1 - 仅+使能.eprj
4轴5.0/LY-5X-V3.1.eprj
4轴5.0/四轴5.0控制板(0905).eprj
3020-2.0包裹款/3020包裹款控制板V1.1.eprj
3020-2.0包裹款/3020包裹款控制板V1.2.eprj
3020-2.0包裹款/主轴照明灯.eprj
3020-2.0包裹款/主轴照明灯板v1.0.eprj
3020-2.0包裹款/主轴照明灯板v1.1.eprj
3020-2.0包裹款/刀仓照明灯.eprj
3020-2.0包裹款/包裹款-触摸屏控制板V1.eprj
3020-2.0包覆款/3020摄像头 (0323).eprj
3020-2.0包覆款/包裹款-触摸屏控制板V1.3.eprj
3020机器转接板/X轴限位转接板--(0909).eprj
3020机器转接板/Z轴转接板-光耦.eprj
3020机器转接板/限位开关板.eprj
4040lite转接板/X转接板V1.0(4040Lite).eprj
4040lite转接板/激光主轴转接板01.eprj
4040lite转接板/激光主轴转接板V1.0.eprj
4040lite转接板/电机线限位线中继板V1.0.eprj
4040M/4040M主控板.eprj
4040M/4040M主控板V1.0 - ESP32.eprj
4040M/4040M主控板V1.0.eprj
4040M/4040M主控板v1.0_原理图.eprj
4040M/触摸屏电路板/包裹款-触摸屏控制板-V1.3(1).epro
esp32屏幕/stm32+ULN2003a.eprj
esp32屏幕/驱动圆形屏幕.eprj
三轴4.0控制板/GRBL3-10086-V10.PcbDoc
三轴4.0控制板/GRBL3-10086-V10.SchDoc
三轴4.0控制板/GRBL3-10086.PcbDoc
三轴4.0控制板/GRBL3-10086.SchDoc
串口转蓝牙/串口转蓝牙.eprj
主轴转接板/主轴转接板01.eprj
主轴转接板/主轴转接板02.eprj
主轴转接板/主轴转接板.eprj
安全继电器TXAS1-3012/延时继电器 - V2.eprj
安全继电器TXAS1-3012/延时继电器 -(4-11).eprj
探针圆盘/圆环探针板.eprj
探针圆盘/探针圆盘 - 0617.eprj
探针圆盘/探针圆盘.eprj
控制板10长宽/控制板10+10.eprj
控制板10长宽/板框10+10.eprj
控制板10长宽/测试板10+10 - 发出4-11.eprj
控制板+驱动/5轴PCB-V1.1--捷配 -(0331).eprj
控制板+驱动/5轴PCB-V1.1--捷配.eprj
控制板+驱动/USB-B-TH_USB-B12-BRW.pcbdoc
控制板+驱动/控制板+驱动.eprj
电机驱动TB6600/TB6600驱动板/LY-TB6600-V1.0.eprj
电机驱动TB6600/TB6600驱动板/TB6600步进电机驱动.eprj
电机驱动TB6600/TB6600驱动板/TB6600步进电机驱动验证板_.epro
电机驱动TB6600/无刷电机驱动_6-80V_20A_V2.0-J.eprj
电源板48-24/电源板48-24 (0524).eprj
电源板48-24/电源板48-24.eprj
转接隔离板/转接隔离板.eprj
通讯接口转换/控制箱转接板.eprj
通讯接口转换/新转接板.eprj
